Grammid/oomwoo-pcb/kicad/cliff-sensor/output/Cliff Sensor.pdf

1 | 2 | 3 | 4 | 5
1 | 2 | 3 | 4 | 5

AB

C

D

AB

C

D Date: 2026-10-28

Size: USLetter | Rev: 1
KiCad E.D.A. 10.0.4 | Id: 1/1

## Title: Cliff sensor board (fit 6x)

File: Cliff Sensor.kicad_sch

Sheet: /

OOMWOO cliff sensor

D4001
1 | IR333-A 2

3
4

5 6

J4001

ZX-SH1_0-4PLT

Q4001 PT333-3B

LED_A OUT LED_K OOMWOO cliff sensor board (rev 1, 2026-10-28). One design, fitted 6x. No lenses: narrow-beam 5 mm parts (IR333-A 20 deg, PT333-3B black lens) tilted toward each other so their beams cross at the floor. The tilt sets the reference distance:
crossing depth = (spacing / 2) / tan(tilt), e.g. 18 mm spacing: 30 deg -> 15.6 mm, 25 deg -> 19.3 mm, 20 deg -> 24.7 mm. Beyond the crossing point the beams diverge, so a far floor (a cliff) returns little light even if it is white.

The main board switches the LED cathode (CLIFF_LED_EN, modulate it to cancel ambient light) and pulls OUT up (47k).
Refs in the 4000s: each board has its own range.

Assembly (JLC): D4001 and Q4001 THT with the ASSEMBLY STANDOFF (~2 mm) so the leads can be bent; pin bending to the tilt angle, or bend by hand in the 3D-printed housing. LED: flat side = cathode. Q8501: flat side / square pad = emitter. Spacing D4001-Q4001: 18 mm centre to centre. - VLED PWM period <<15 usec - duty cycle ~10%

J4001

ZX-SH1_0-4PLT 1
2
3
4

5 6 Q4001 PT333-3B
