Grammid/oomwoo-pcb/kicad/front-sensors/output/Front Sensor-bom.csv

Comment | Designator | Footprint | LCSC Part # | Quantity
10uF/10V | C2001,C2003,C2005 | JLCImport:C0603 | C19702 | 3
100nF/50V | C2002,C2004 | JLCImport:C0603 | C1591 | 2
2005WR-2X4P | J2001 | JLCImport:HDR-TH_8P-P2.00-H-F-R2-C2-S2.00-W8.8 | C6837622 | 1
BLM18PG121SN1D | L2001 | JLCImport:BLM18PG121SN1D | C14709 | 1
47k | R2001 | JLCImport:R0603 | C2907042 | 1
100 | R2002 | JLCImport:R0603 | C2906981 | 1
IRM-H638T/TR2 | U2002 | JLCImport:IRM-H638T | C91447 | 1
