Grammid/oomwoo-pcb/kicad/main-phone/output/Main-bom.csv

Comment | Designator | Footprint | LCSC Part # | Quantity
ITR9606-F | BUMP-L1,BUMP-R1 | JLCImport:OPTO-TH_ITR9606-F | C3008416 | 2
10uF/10V | C6,C17,C19,C31,C33,C108,C113,C114,C121,C122,C146,C147,C148,C149,C152,C153,C159,C160,C161,C170,C172 | JLCImport:C0603 / Capacitor_SMD:C_0603_1608Metric | C19702 | 21
220nF/25V | C8 | Capacitor_SMD:C_0603_1608Metric | C64705 | 1
100nF/50V | C12,C13,C15,C16,C18,C21,C30,C32,C36,C37,C64,C84,C88,C92,C102,C103,C109,C111,C117,C119,C142,C143,C158,C163,C167,C169,C171,C173,C174,C175,C177 | JLCImport:C0603 / Capacitor_SMD:C_0603_1608Metric | C1591 | 31
1uF/25V | C14,C22,C176 | Capacitor_SMD:C_0603_1608Metric | C380328 | 3
18pF/50V | C39,C42 | Capacitor_SMD:C_0603_1608Metric | C107040 | 2
10uF/25V | C62,C134,C135,C136,C137,C138,C140,C141,C150,C151,C168 | JLCImport:C0603 | C96446 | 11
10uF/50V | C95,C106,C115,C116,C164,C165,C166 | JLCImport:C1206 | C13585 | 7
47nF/50V | C110,C112,C120,C178,C179 | JLCImport:C0603 / Capacitor_SMD:C_0603_1608Metric | C1622 | 5
1.2nF/50V | C162 | JLCImport:C0603 | C107073 | 1
ZX-SH1_0-4PLT | CLIFF-LF1,CLIFF-LM1,CLIFF-LR1,CLIFF-RF1,CLIFF-RM1,CLIFF-RR1,REAR-IR1 | JLCImport:ZX-SH1_0-4PLT | C7430453 | 7
S2B-ZR-SM4A-TF_LF_SN | CN1 | JLCImport:S2B-ZR-SM4A-TF_LF_SN | C265329 | 1
WAFER-PH2_0-4PWB | CONTACT_CHGR1 | JLCImport:WAFER-PH2_0-4PWB | C3029442 | 1
USBLC6-2SC6_C2687116 | D1,D40 | JLCImport:USBLC6-2SC6_C2687116 | C2687116 | 2
ZMM9V1_C2891750 | D2 | JLCImport:ZMM9V1_C2891750 | C2891750 | 1
SS34 | D4,D11,D37 | JLCImport:SS34_C8678 | C8678 | 3
SS56 | D12,D13,D14,D15,D42,D43 | JLCImport:SS56 | C65009 | 6
1N4148 | D26,D27,D28 | JLCImport:SOD-123_L2.8-W1.8-LS3.7-RD-1 | C917030 | 3
SMAJ22A | D41 | JLCImport:SMAJ18A_C148219 | C353464 | 1
YLED0603B | D44,D45,LED1,LED_CHG1,LED_DONE1,LED_HOME1,LED_PWR1 | JLCImport:YLED0603B | C19171394 | 7
DC-044A-20A | DC1 | JLCImport:DC-044A-20A | C129006 | 1
JFC1206-2200FS | F1 | JLCImport:JFC1206-2200FS | C136357 | 1
ZX-SH1_0-3PLT | HALL-BIN1,HALL-TOWER1 | JLCImport:ZX-SH1_0-3PLT | C7430452 | 2
PZ254R-12-12P | J1 | JLCImport:HDR-TH_12P-P2.54-H-M-R2-C6-S2.54 | C492434 | 1
C3030WV-4P | J2 | JLCImport:CONN-TH_4P-P3.00_CTJ_C3030WV-P3.00-4P | C239441 | 1
PZ1_27-2X7P-TP | JTAG1 | JLCImport:PZ1_27-2X7P-TP | C55099228 | 1
SMMS0630-100M | L1 | JLCImport:SMMS0630-100M | C128692 | 1
3.3uH | L2,L3 | JLCImport:CYA0630-3_3UH | C5189747 | 2
10uH | L4 | JLCImport:XRNR4030-10UH_M | C5289356 | 1
WAFER-GH1_25-4PWB | LIDAR1 | JLCImport:WAFER-GH1_25-4PWB | C3029379 | 1
ZX-ZH1_5-2PWT | MAIN_BRUSH1,SIDE_BRUSH1 | JLCImport:ZX-ZH1_5-2PWT | C19272405 | 2
XDWF-C3030WR-1*4P | MAIN_FAN1 | JLCImport:CONN-TH_4P-P3.00_L8.9-W15.7-EH4.7 | C50399536 | 1
ZX-ZH1_5-7PWT | MOT_WHEEL_L1,MOT_WHEEL_R1 | JLCImport:ZX-ZH1_5-7PWT | C19272410 | 2
AO4407C | Q1,Q13,Q14,Q37,Q38 | Package_SO:SOIC-8_3.9x4.9mm_P1.27mm | C469397 | 5
AOD407_C6396162 | Q12 | JLCImport:AOD407_C6396162 | C6396162 | 1
AO3401 | Q16,Q24,Q25,Q27 | JLCImport:AO3401 | C20628875 | 4
AO3400 | Q18,Q19,Q20,Q23,Q26,Q28,Q29,Q30,Q31,Q32,Q33,Q34,Q35,Q36 | JLCImport:AO3400 | C20628874 | 14
10k | R1,R21,R22,R49,R50,R51,R52,R67,R92,R103,R104,R105,R107,R159,R165,R172,R173,R179,R181,R184,R195,R201,R217 | JLCImport:R0603 / Resistor_SMD:R_0603_1608Metric | C98220 | 23
47k | R2,R39,R53,R64,R73,R189,R192,R194,R196,R212,R213 | JLCImport:R0603 | C2907042 | 11
2.2k | R5,R6,R149 | JLCImport:R0603 / Resistor_SMD:R_0603_1608Metric | C2907005 | 3
1k | R14,R44,R48,R77,R78,R89,R98,R176,R178,R190 | Resistor_SMD:R_0603_1608Metric / JLCImport:R0603 | C2907113 | 10
RLH12FTCR250 | R15,R65 | Resistor_SMD:R_1206_3216Metric | C22464902 | 2
100k | R16,R38,R40,R41,R56,R63,R74,R90,R116,R168,R171,R175,R177,R180,R186,R187,R188,R191,R200,R202,R203,R207,R211,R219,R221 | JLCImport:R0603 / Resistor_SMD:R_0603_1608Metric | C2907088 | 25
10 | R36,R60,R141,R146,R222 | JLCImport:R0603 | C2907091 | 5
120 Ohm | R37 | Resistor_SMD:R_0603_1608Metric | C22787 | 1
1Ω | R59 | JLCImport:FRC0805J1R0TS | C2930253 | 1
100 | R66,R113,R183 | Resistor_SMD:R_0603_1608Metric | C2906981 | 3
GL5537-1 | R75 | JLCImport:GL5537-1 | C125628 | 1
RLH12FTCR300 | R83 | Resistor_SMD:R_1206_3216Metric | C22464904 | 1
LRBK25EFER110 | R84 | Resistor_SMD:R_2512_6332Metric | C5121166 | 1
100mΩ/1W | R106 | JLCImport:R1206 | C46961734 | 1
4.7k | R143,R147 | Resistor_SMD:R_0603_1608Metric | C2907034 | 2
69.8k | R144 | Resistor_SMD:R_0603_1608Metric | C2930012 | 1
22.1k | R145,R208 | Resistor_SMD:R_0603_1608Metric | C2960862 | 2
12k | R148 | Resistor_SMD:R_0603_1608Metric | C2930069 | 1
232k | R160,R205,R206 | Resistor_SMD:R_0603_1608Metric | C22913 | 3
330 | R185 | JLCImport:R1206 | C17930 | 1
1M | R193,R199,R218 | JLCImport:R0603 | C22935 | 3
180 | R197,R220 | JLCImport:R0603 | C22828 | 2
150 | R224,R225,R226,R227,R228,R229 | JLCImport:R0603 | C22808 | 6
ZX-SH1_0-7PWT | SIDE-R1 | JLCImport:ZX-SH1_0-7PWT | C7430449 | 1
PZ254V-11-06P | STM32_DEBUG1 | Connector_PinHeader_2.54mm:PinHeader_1x06_P2.54mm_Vertical | C492405 | 1
TS-1187A-B-A-B | SW_CLEAN1,SW_HOME1,SW_PWR1 | JLCImport:TS-1187A-B-A-B | C318884 | 3
NTCG164KF104FT1 | T1 | JLCImport:NTCG164KF104FT1 | C92042 | 1
SLM6900 | U1 | JLCImport:SLM6900 | C388595 | 1
TMI6240 | U2 | JLCImport:TMI6240 | C2979914 | 1
MT3608 | U5 | JLCImport:MT3608 | C84817 | 1
STM32G473VCT6 | U13 | JLCImport:LQFP-100_L14.0-W14.0-P0.50-LS16.0-BL | C730121 | 1
DRV8870DDAR | U14,U15,U18,U20 | JLCImport:DRV8870DDAR | C86590 | 4
HT7533-1_C14289 | U16 | JLCImport:HT7533-1_C14289 | C14289 | 1
ICM-42607-P | U19 | JLCImport:ICM-42607-P | C5129967 | 1
TPS54560BDDAR | U21,U22 | Package_SO:Texas_R-PDSO-G8_EP2.95x4.9mm_Mask2.4x3.1mm_ThermalVias | C1850354 | 2
74LVC1G17 | U23 | Package_TO_SOT_SMD:SOT-23-5 | C19829593 | 1
TYPE-C-31-M-12 | USBC2 | JLCImport:USB-C_SMD-TYPE-C-31-M-12_1 | C165948 | 1
2005FV-2X4P | VL-L1,VL-R1 | JLCImport:HDR-TH_8P-P2.00-V-F-R2-C4-S2.00-1 | C18723066 | 2
XKXEL89CII-SUAYLC-32_768K | X3 | JLCImport:XKXEL89CII-SUAYLC-32_768K | C18214309 | 1
