Grammid/oomwoo-pcb/kicad/rear-ir/output/Rear IR-bom.csv

Comment | Designator | Footprint | LCSC Part # | Quantity
10uF/10V | C5001,C5002 | JLCImport:C0603 | C19702 | 2
ZX-SH1_0-4PLT | J5001 | JLCImport:ZX-SH1_0-4PLT | C7430453 | 1
100 | R5001,R5002 | JLCImport:R0603 | C2906981 | 2
IRM-H638T/TR2 | U5001,U5002 | JLCImport:IRM-H638T | C91447 | 2
