Grammid/oomwoo-pcb/kicad/charging-dock/output/Charging Dock.pdf

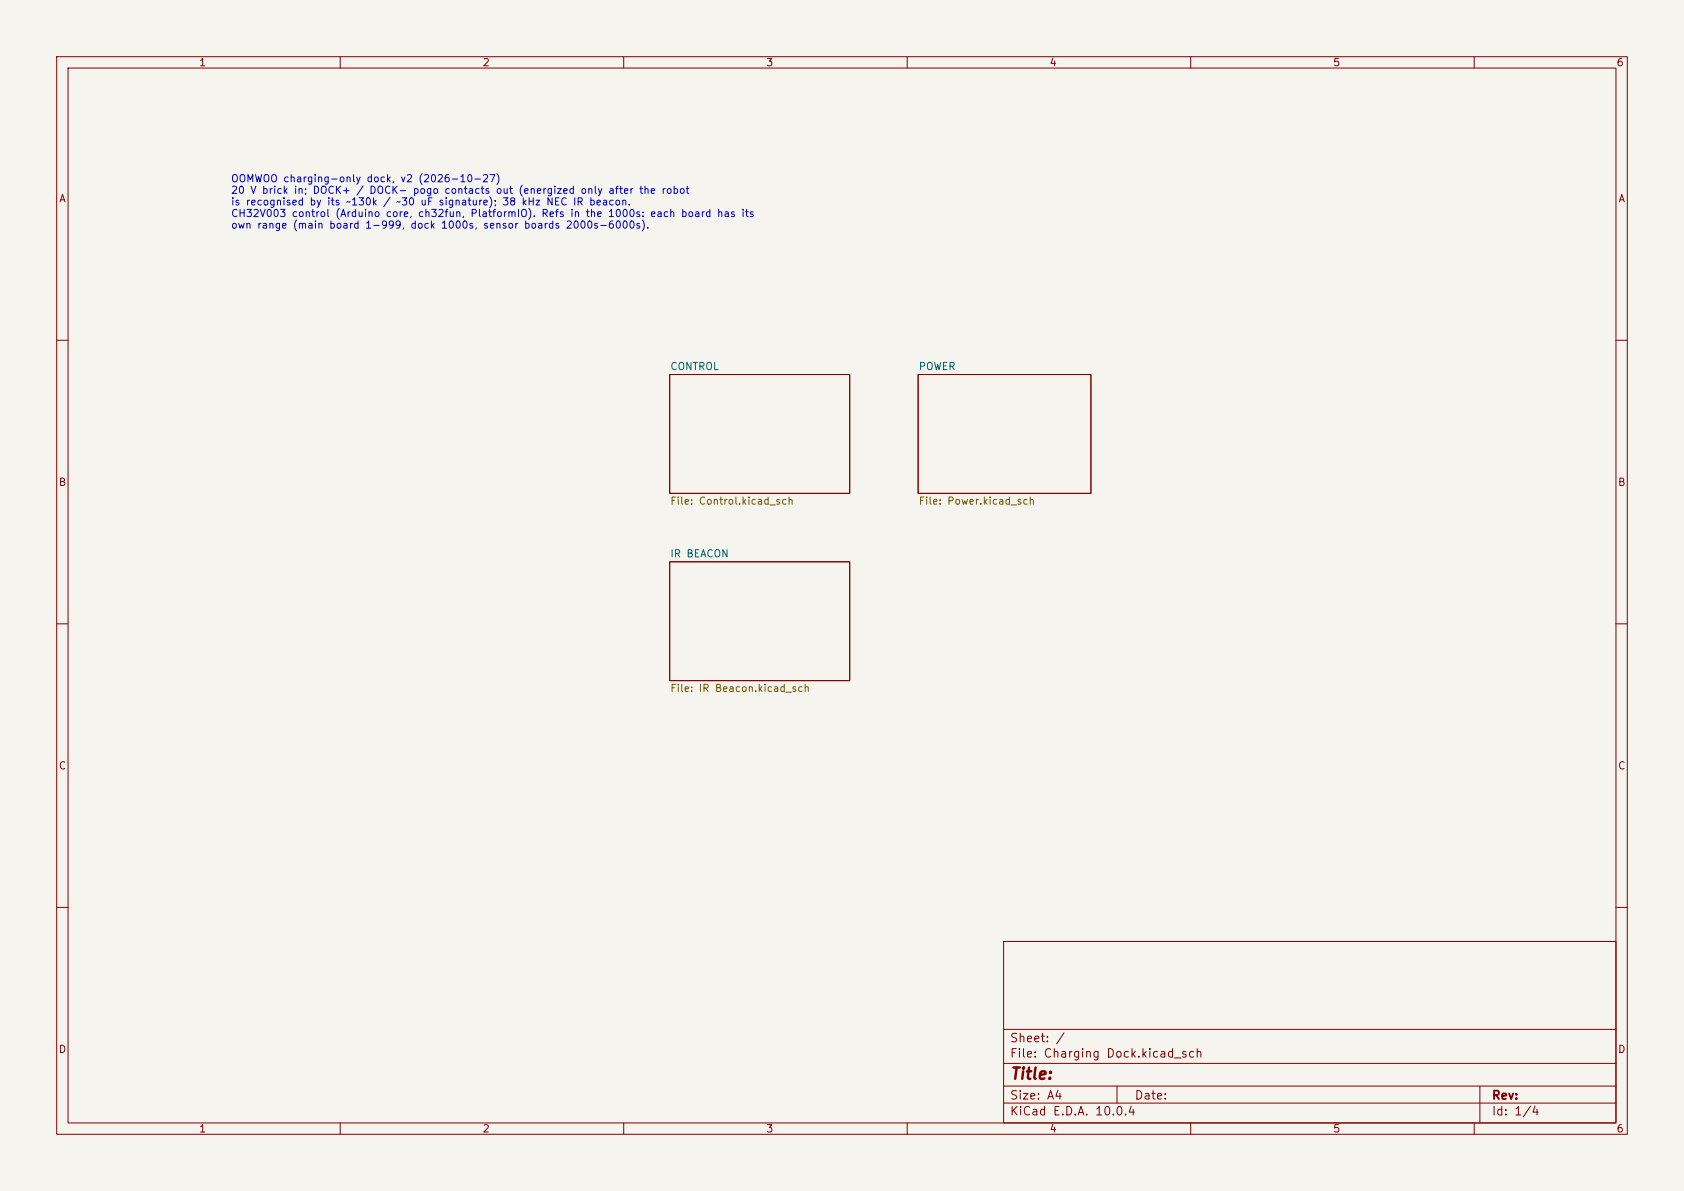
[picture p1: page 1]

File: Power.kicad_sch CONTROL File: Control.kicad_sch OOMWOO charging-only dock, v2 (2026-10-27) 20 V brick in; DOCK+ / DOCK- pogo contacts out (energized only after the robot

is recognised by its ~130k / ~30 uF signature); 38 kHz NEC IR beacon. CH32V003 control (Arduino core, ch32fun, PlatformIO). Refs in the 1000s: each board has its own range (main board 1-999, dock 1000s, sensor boards 2000s-6000s).

Size: A4 | Rev:
KiCad E.D.A. 10.0.4 | Id: 1/4

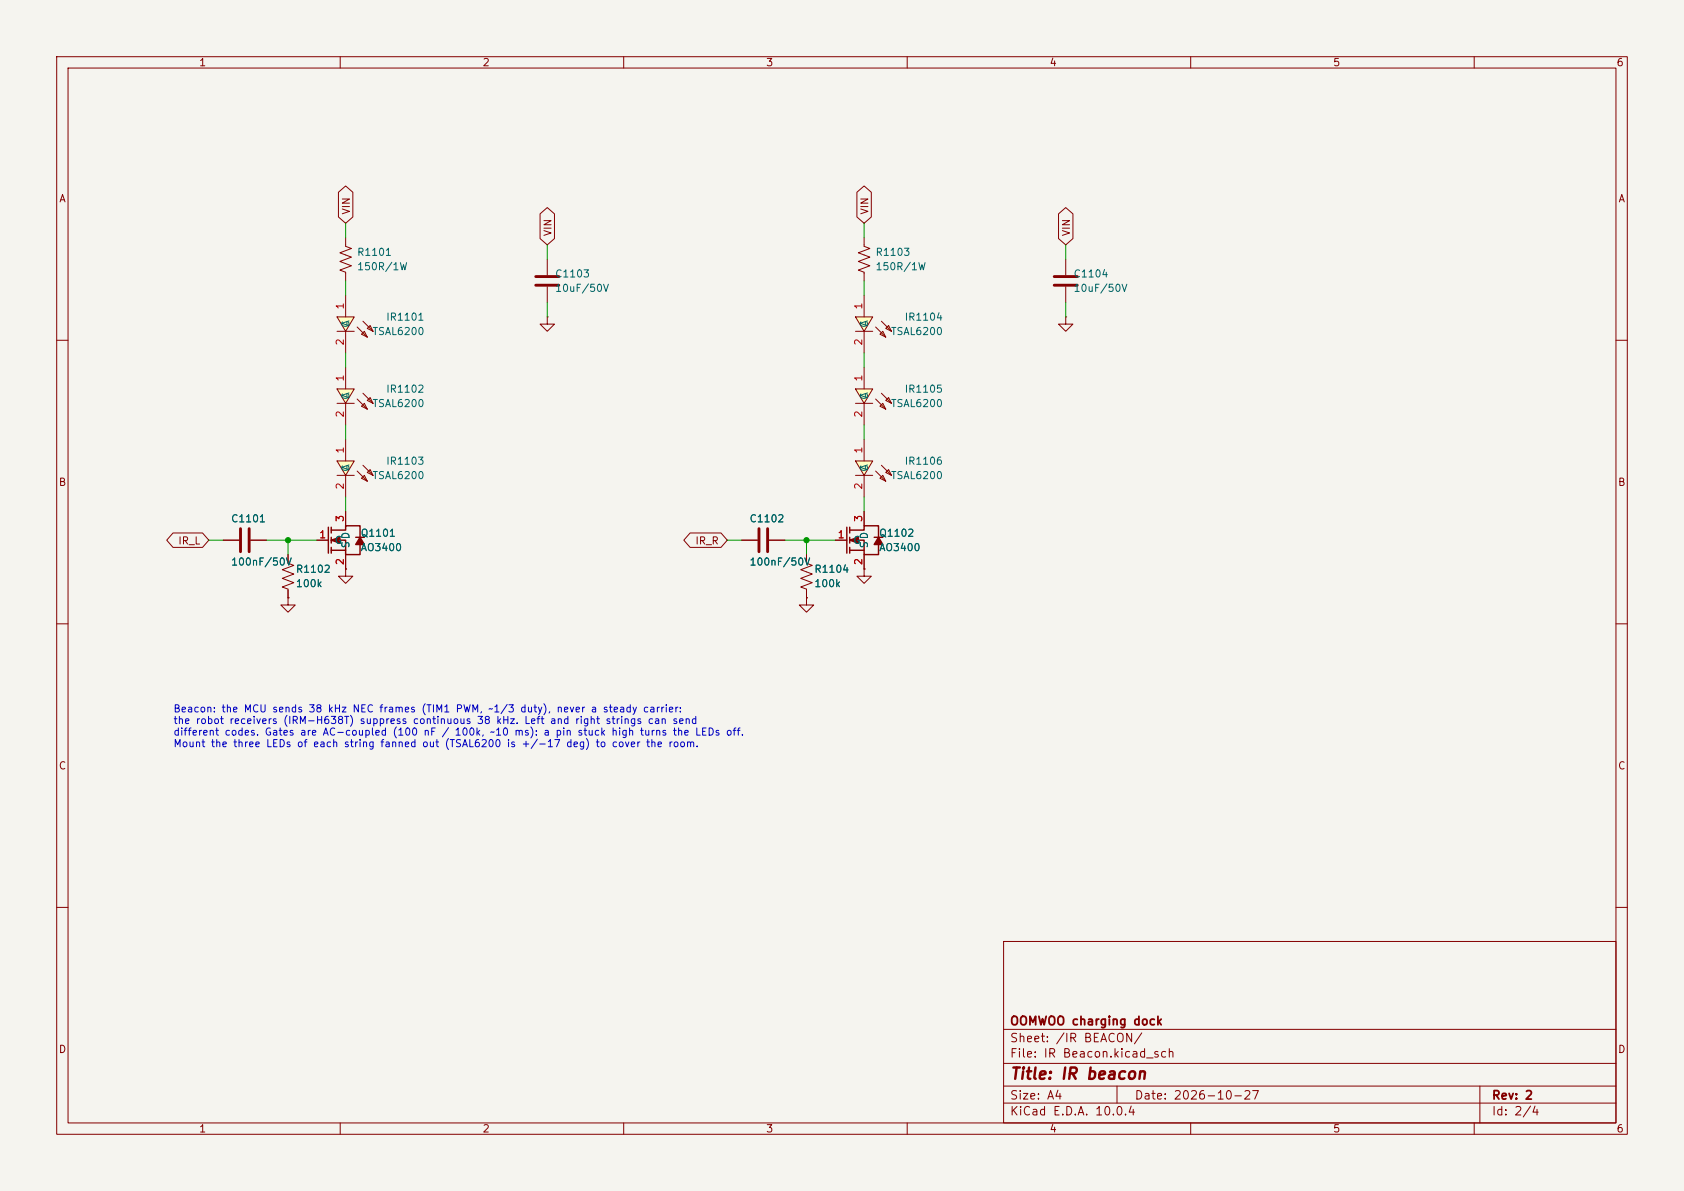
[picture p2: page 2]

Beacon: the MCU sends 38 kHz NEC frames (TIM1 PWM, ~1/3 duty), never a steady carrier: the robot receivers (IRM-H638T) suppress continuous 38 kHz. Left and right strings can send

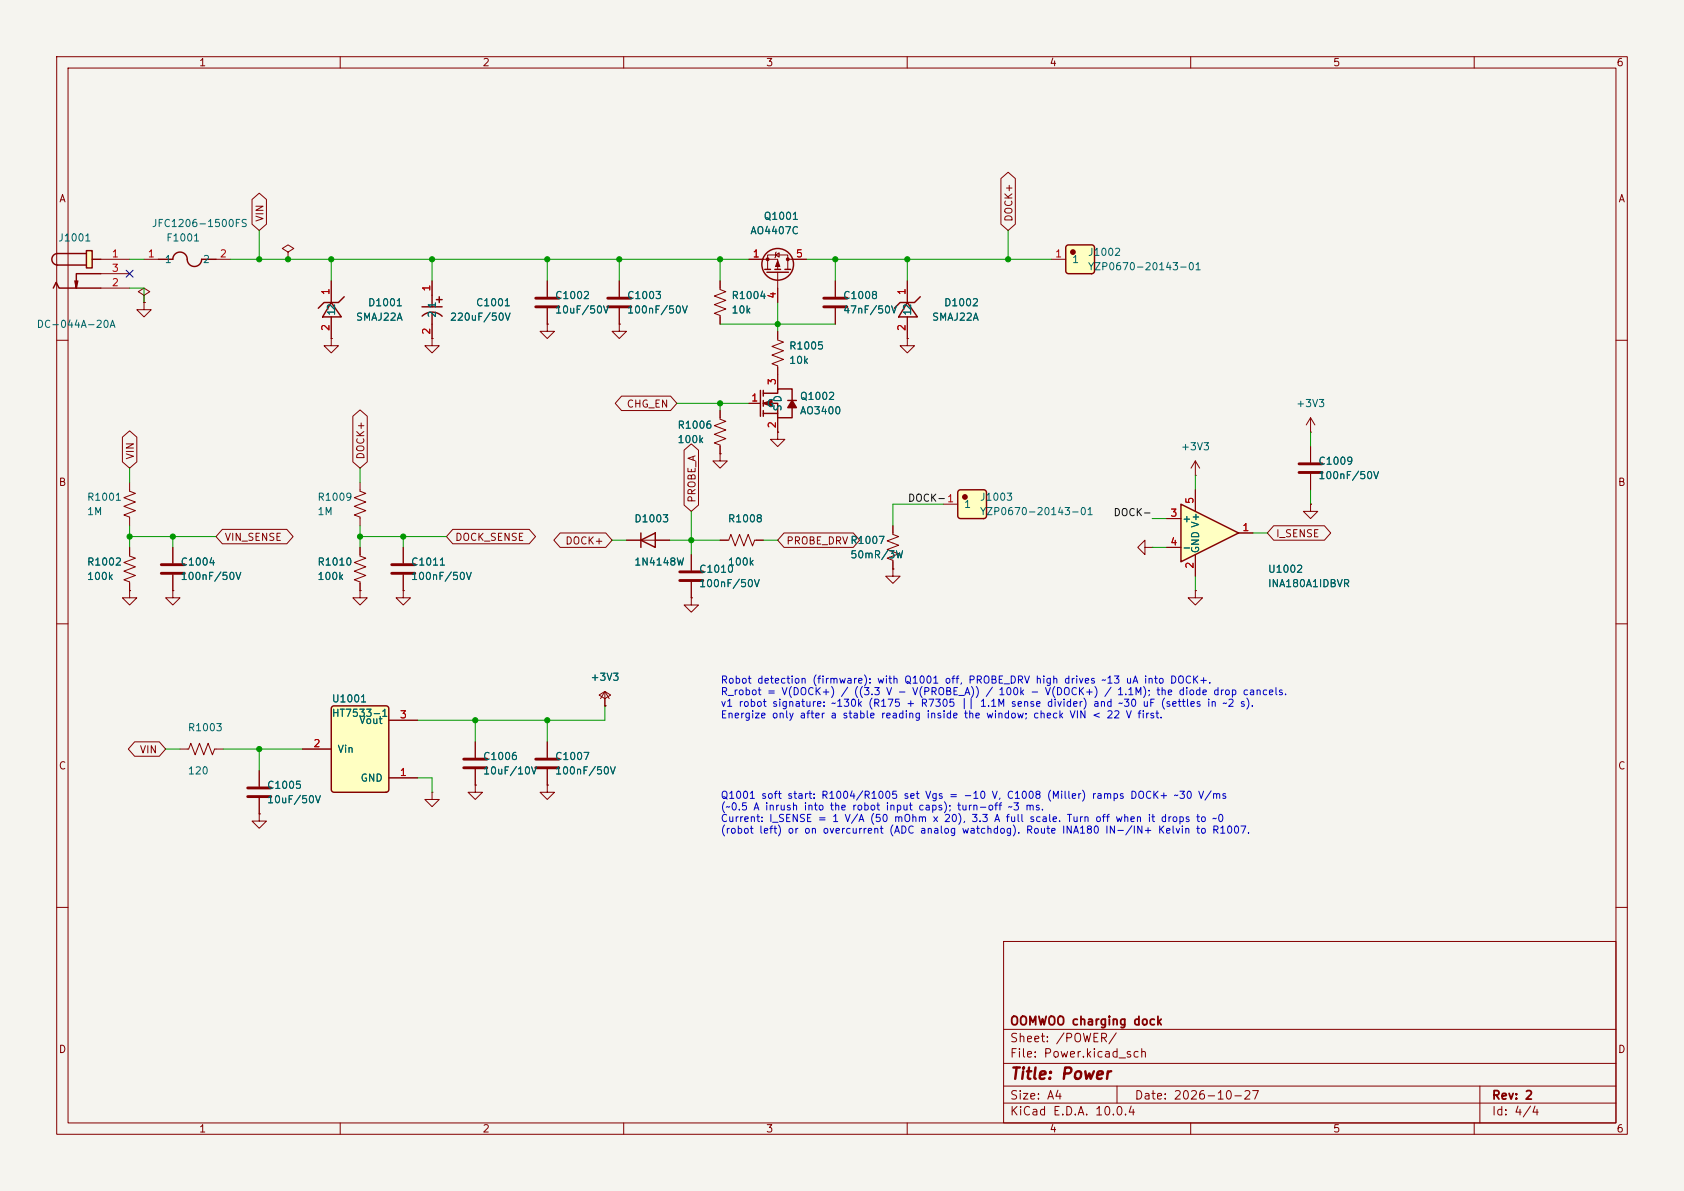
[picture p3: page 3]

Energize only after a stable reading inside the window; check VIN < 22 V first. D1003

(robot left) or on overcurrent (ADC analog watchdog). Route INA180 IN-/IN+ Kelvin to R1007. Robot detection (firmware): with Q1001 off, PROBE_DRV high drives ~13 uA into DOCK+. R_robot = V(DOCK+) / ((3.3 V - V(PROBE_A)) / 100k - V(DOCK+) / 1.1M); the diode drop cancels. v1 robot signature: ~130k (R175 + R7305 || 1.1M sense divider) and ~30 uF (settles in ~2 s).

Q1001 soft start: R1004/R1005 set Vgs = -10 V, C1008 (Miller) ramps DOCK+ ~30 V/ms
(~0.5 A inrush into the robot input caps); turn-off ~3 ms. Current: I_SENSE = 1 V/A (50 mOhm x 20), 3.3 A full scale. Turn off when it drops to ~0

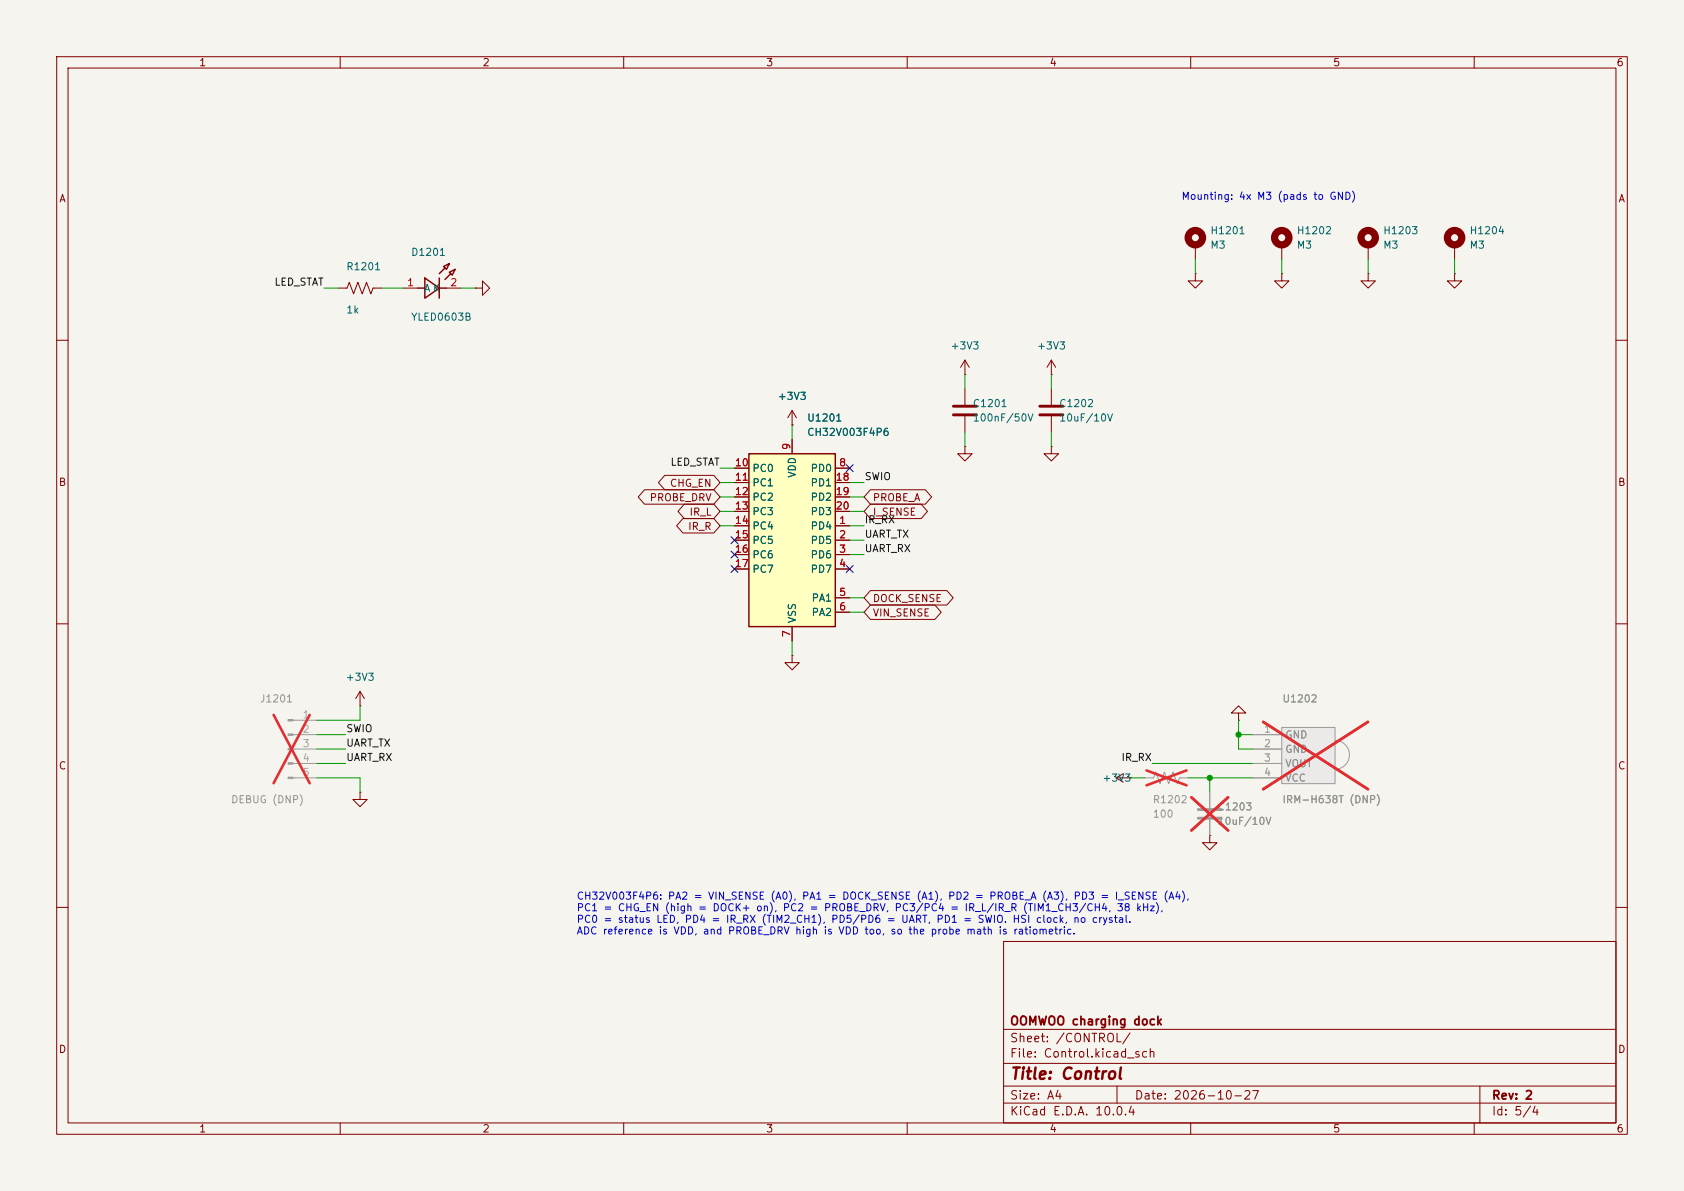
[picture p4: page 4]
