Grammid/oomwoo-pcb/kicad/hall-sensor/output/Hall Sensor.pdf

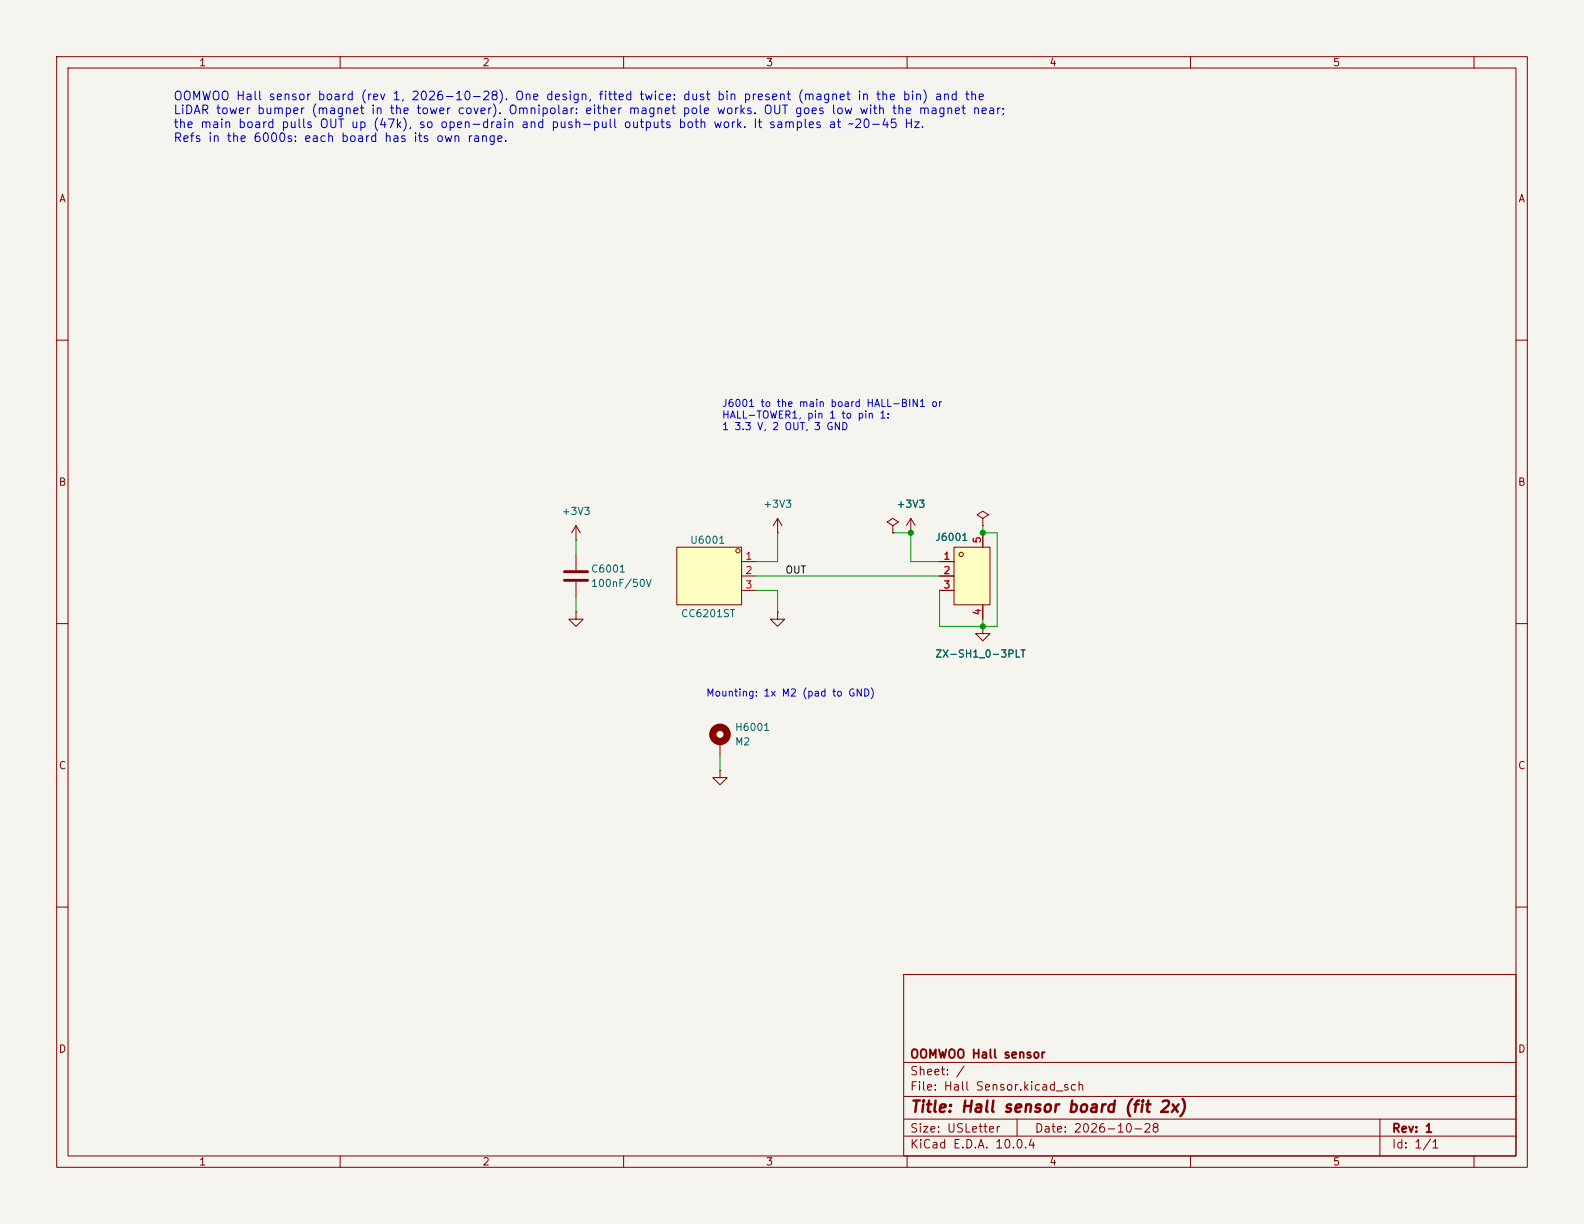
[picture p5: page 1]

OOMWOO Hall sensor board (rev 1, 2026-10-28). One design, fitted twice: dust bin present (magnet in the bin) and the
LiDAR tower bumper (magnet in the tower cover). Omnipolar: either magnet pole works. OUT goes low with the magnet near; the main board pulls OUT up (47k), so open-drain and push-pull outputs both work. It samples at ~20-45 Hz.

J6001 to the main board HALL-BIN1 or HALL-TOWER1, pin 1 to pin 1: 1 3.3 V, 2 OUT, 3 GND Mounting: 1x M2 (pad to GND)

OOMWOO Hall sensor
Sheet: /
File: Hall Sensor.kicad_sch
Title: Hall sensor board (fit 2x)

Size: USLetter | Rev: 1
KiCad E.D.A. 10.0.4 | Id: 1/1
