Grammid/oomwoo-pcb/kicad/main-phone/output/Main.pdf

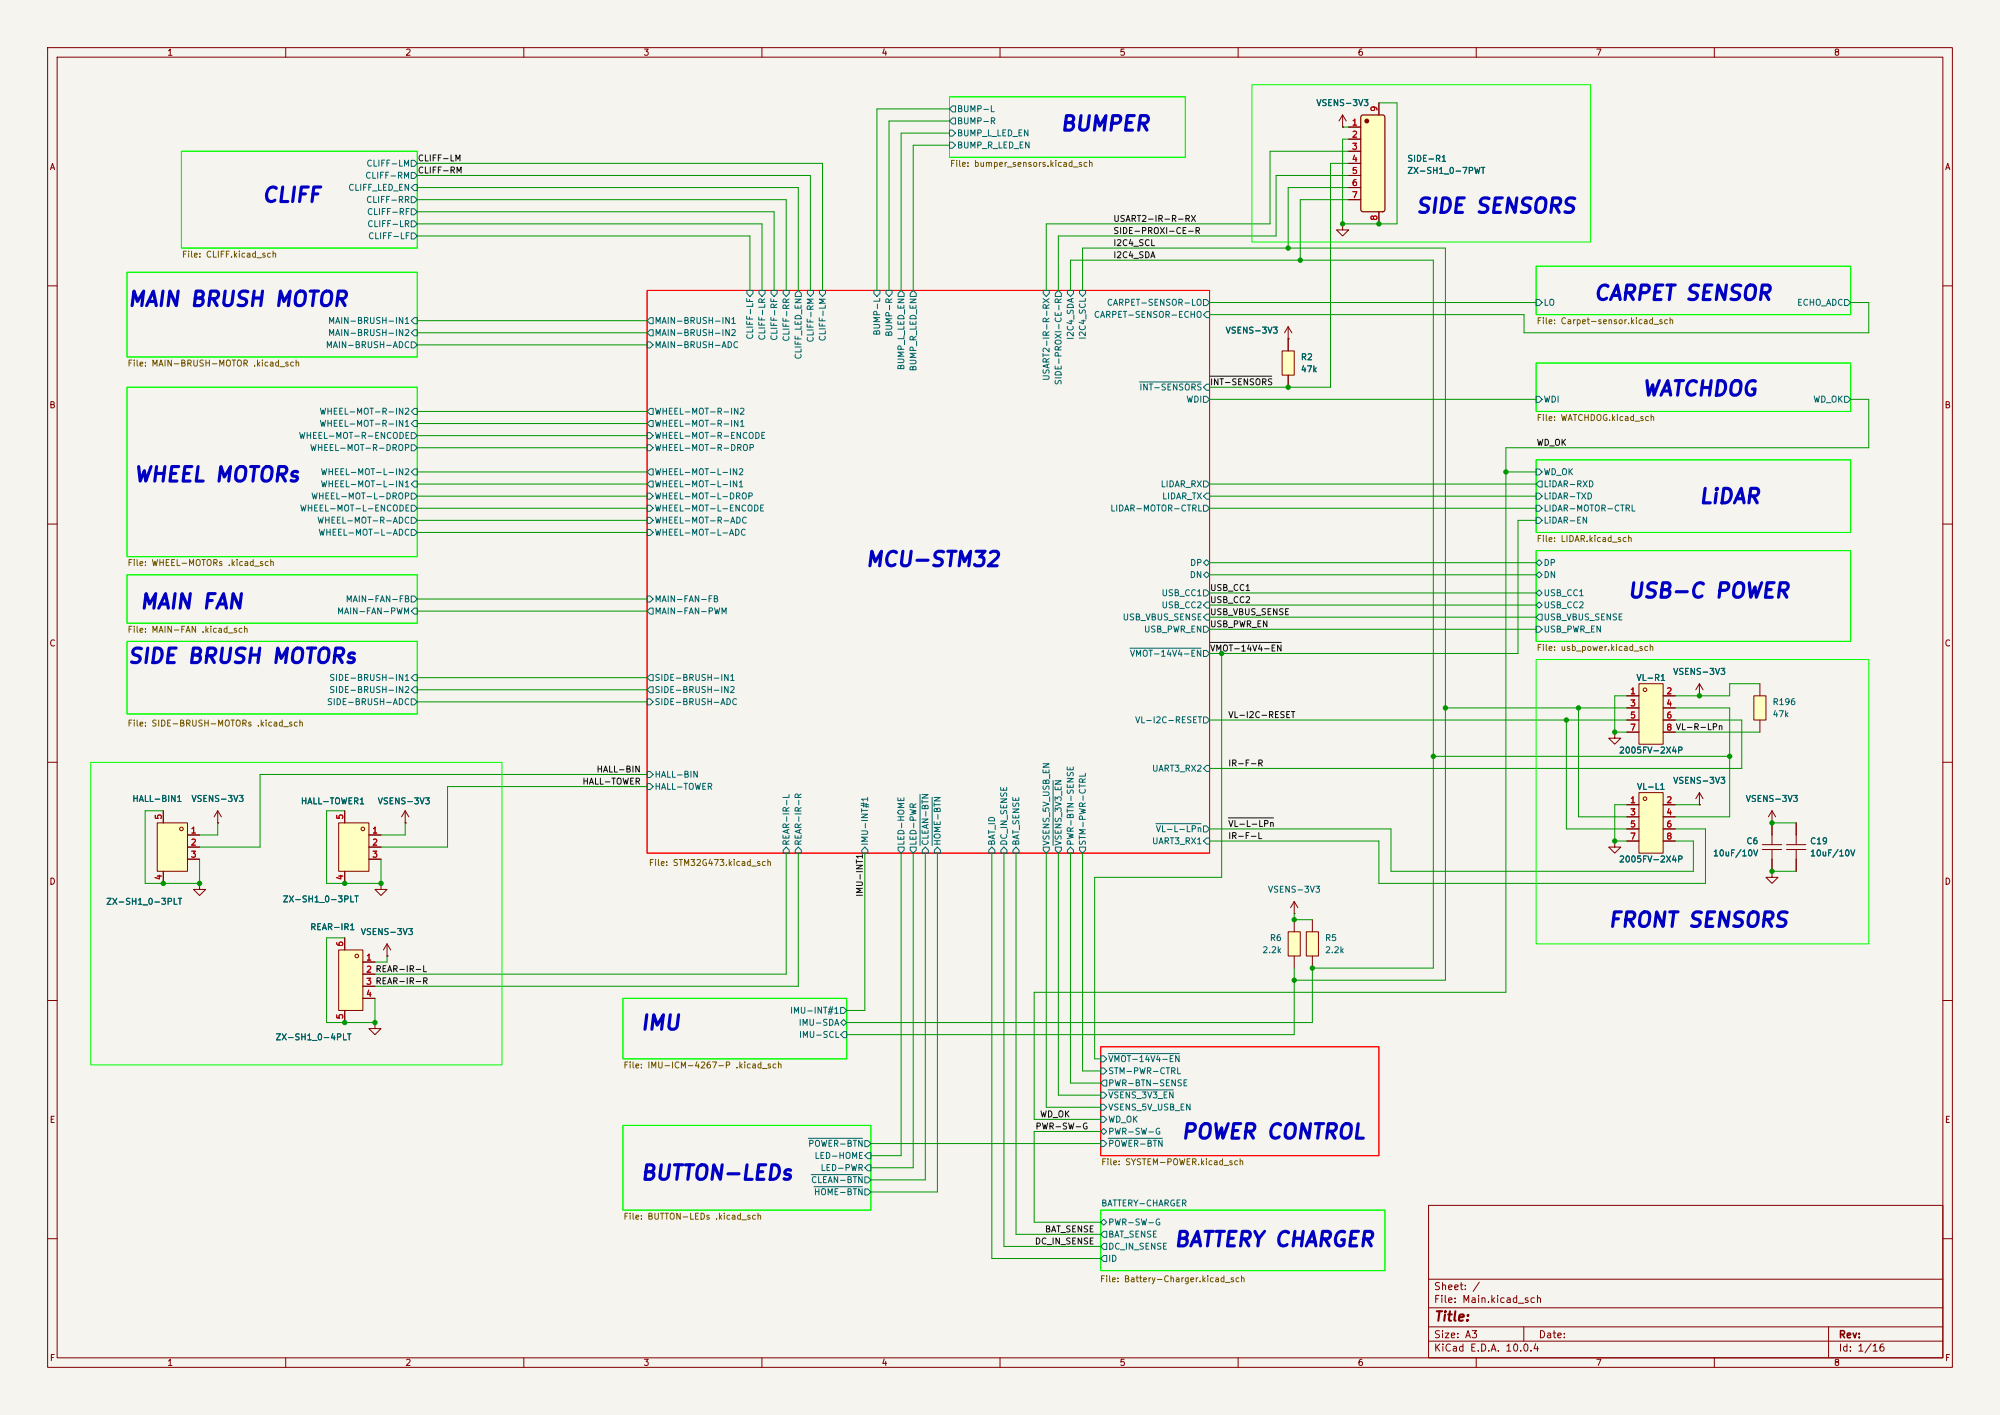
[picture p6: page 1]

BUMP-L File: bumper_sensors.kicad_sch SIDE-BRUSH-ADC

CLIFF-LM
CLIFF-RM
CLIFF_LED_EN
CLIFF-RF CLIFF-RR

CLIFF-LF CLIFF-LR

MAIN-BRUSH-ADC MAIN-BRUSH-IN1 MAIN-BRUSH-IN2
VSENS-3V3 REAR-IR1

File: MAIN-BRUSH-MOTOR .kicad_sch

SIDE-BRUSH-IN2 MAIN-FAN-PWM

IR-F-L USB_PWR_EN

3 3 | 4 4
5 5 | 6 6
7 7 | 8 8

File: SIDE-BRUSH-MOTORs .kicad_sch

VL-L-LPn | VL-L1

PWR-BTN-SENSE STM-PWR-CTRL VMOT-14V4-EN

POWER-BTN
LED-HOME
LED-PWR HOME-BTN
CLEAN-BTN

Size: A3 | Rev:
KiCad E.D.A. 10.0.4 | Id: 1/16 | F Date:

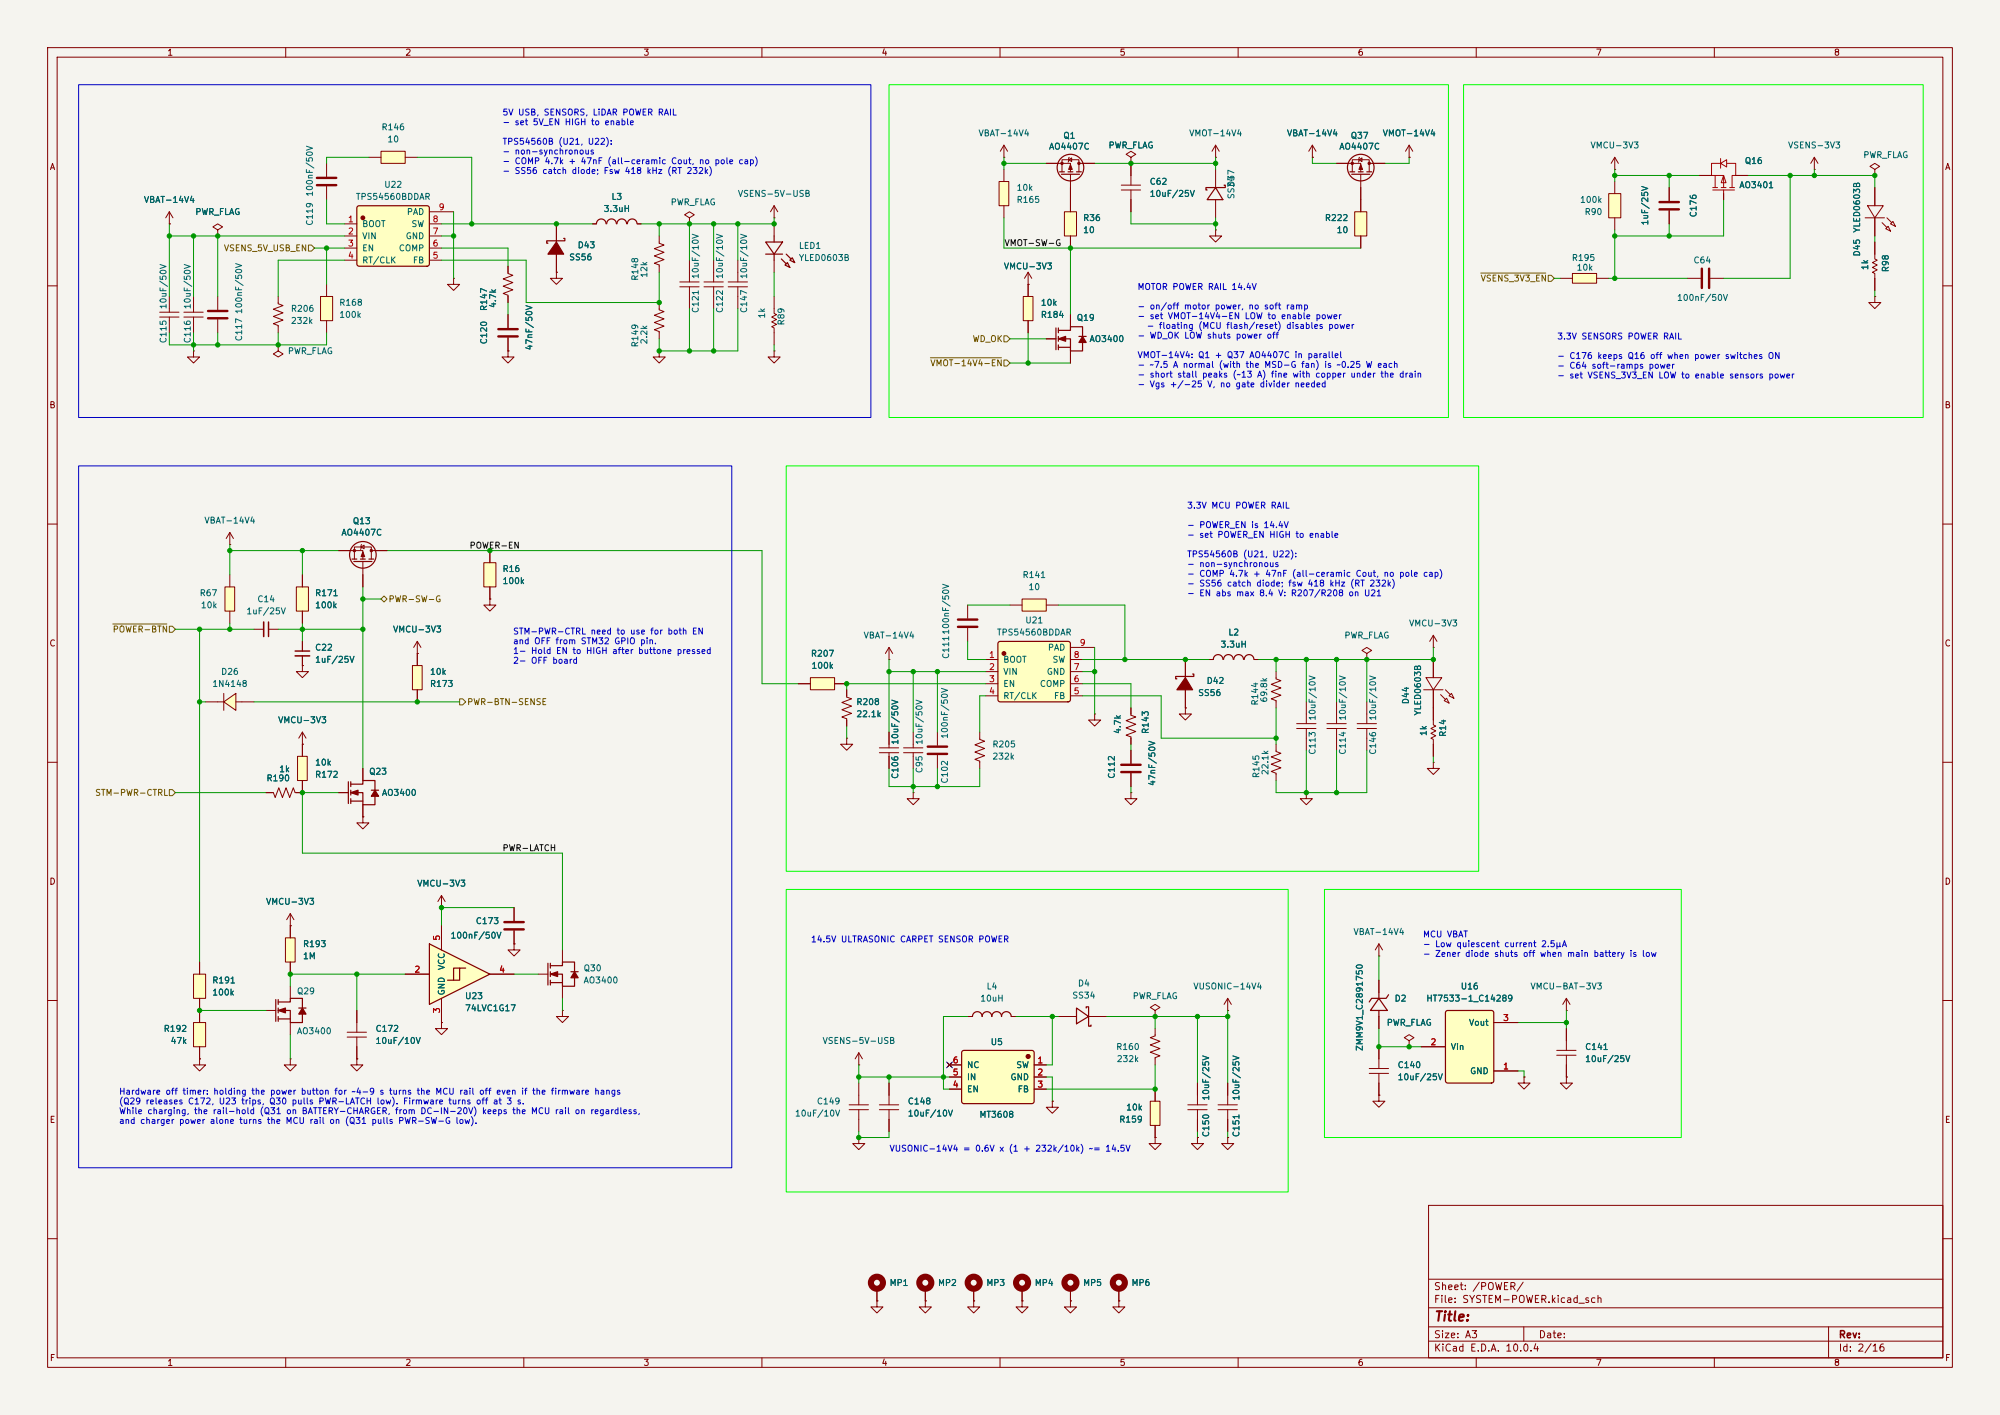
[picture p7: page 2]

3.3V SENSORS POWER RAIL - C176 keeps Q16 off when power switches ON - C64 soft-ramps power - set VSENS_3V3_EN LOW to enable sensors power 5V USB, SENSORS, LiDAR POWER RAIL - set 5V_EN HIGH to enable

TPS54560B (U21, U22): - non-synchronous - COMP 4.7k + 47nF (all-ceramic Cout, no pole cap) - SS56 catch diode; Fsw 418 kHz (RT 232k)

TPS54560B (U21, U22): - non-synchronous - COMP 4.7k + 47nF (all-ceramic Cout, no pole cap) - SS56 catch diode; fsw 418 kHz (RT 232k) - EN abs max 8.4 V: R207/R208 on U21 MOTOR POWER RAIL 14.4V - on/off motor power, no soft ramp - set VMOT-14V4-EN LOW to enable power - floating (MCU flash/reset) disables power - WD_OK LOW shuts power off VMOT-14V4: Q1 + Q37 AO4407C in parallel - ~7.5 A normal (with the MSD-G fan) is ~0.25 W each - short stall peaks (~13 A) fine with copper under the drain - Vgs +/-25 V, no gate divider needed 14.5V ULTRASONIC CARPET SENSOR POWER

3.3V MCU POWER RAIL - POWER_EN is 14.4V - set POWER_EN HIGH to enable

STM-PWR-CTRL need to use for both EN

Hardware off timer: holding the power button for ~4-9 s turns the MCU rail off even if the firmware hangs
(Q29 releases C172, U23 trips, Q30 pulls PWR-LATCH low). Firmware turns off at 3 s. While charging, the rail-hold (Q31 on BATTERY-CHARGER, from DC-IN-20V) keeps the MCU rail on regardless, and charger power alone turns the MCU rail on (Q31 pulls PWR-SW-G low).

Size: A3 | Rev:

F Date:

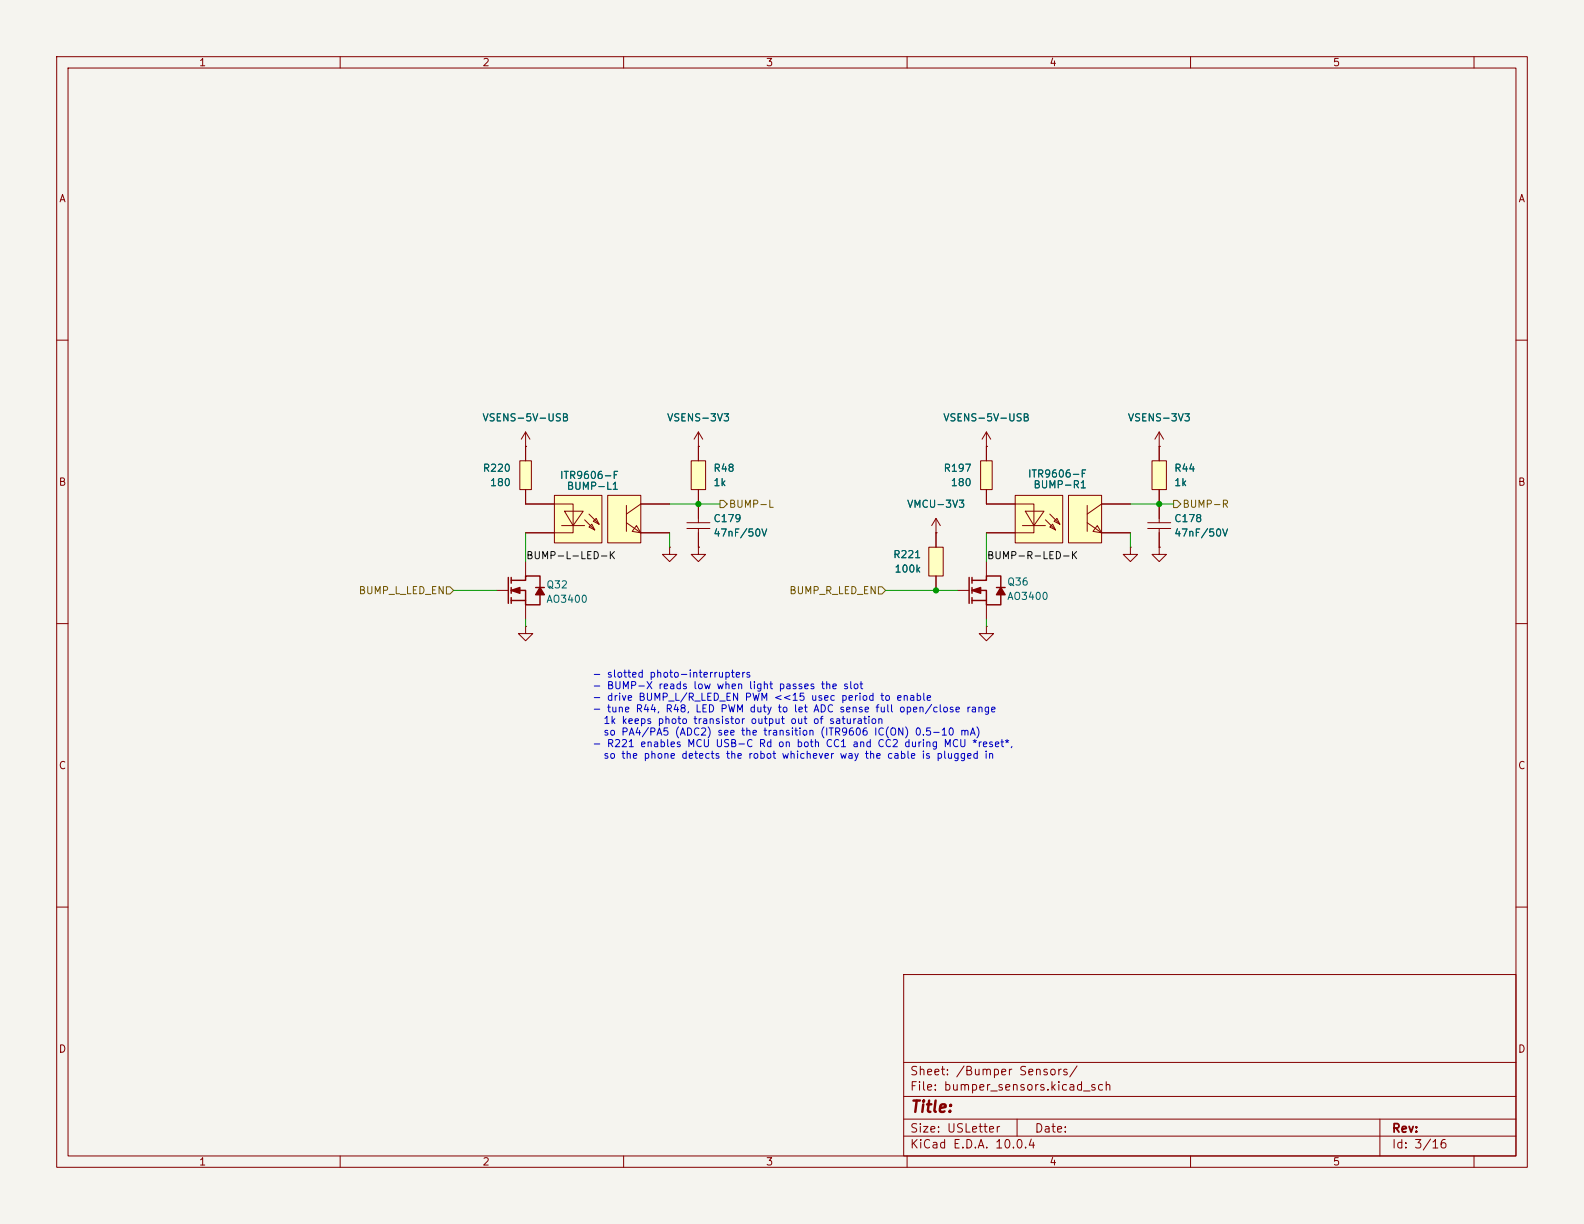
[picture p8: page 3]

so PA4/PA5 (ADC2) see the transition (ITR9606 IC(ON) 0.5-10 mA) - R221 enables MCU USB-C Rd on both CC1 and CC2 during MCU *reset*, so the phone detects the robot whichever way the cable is plugged in R197
BUMP-L1

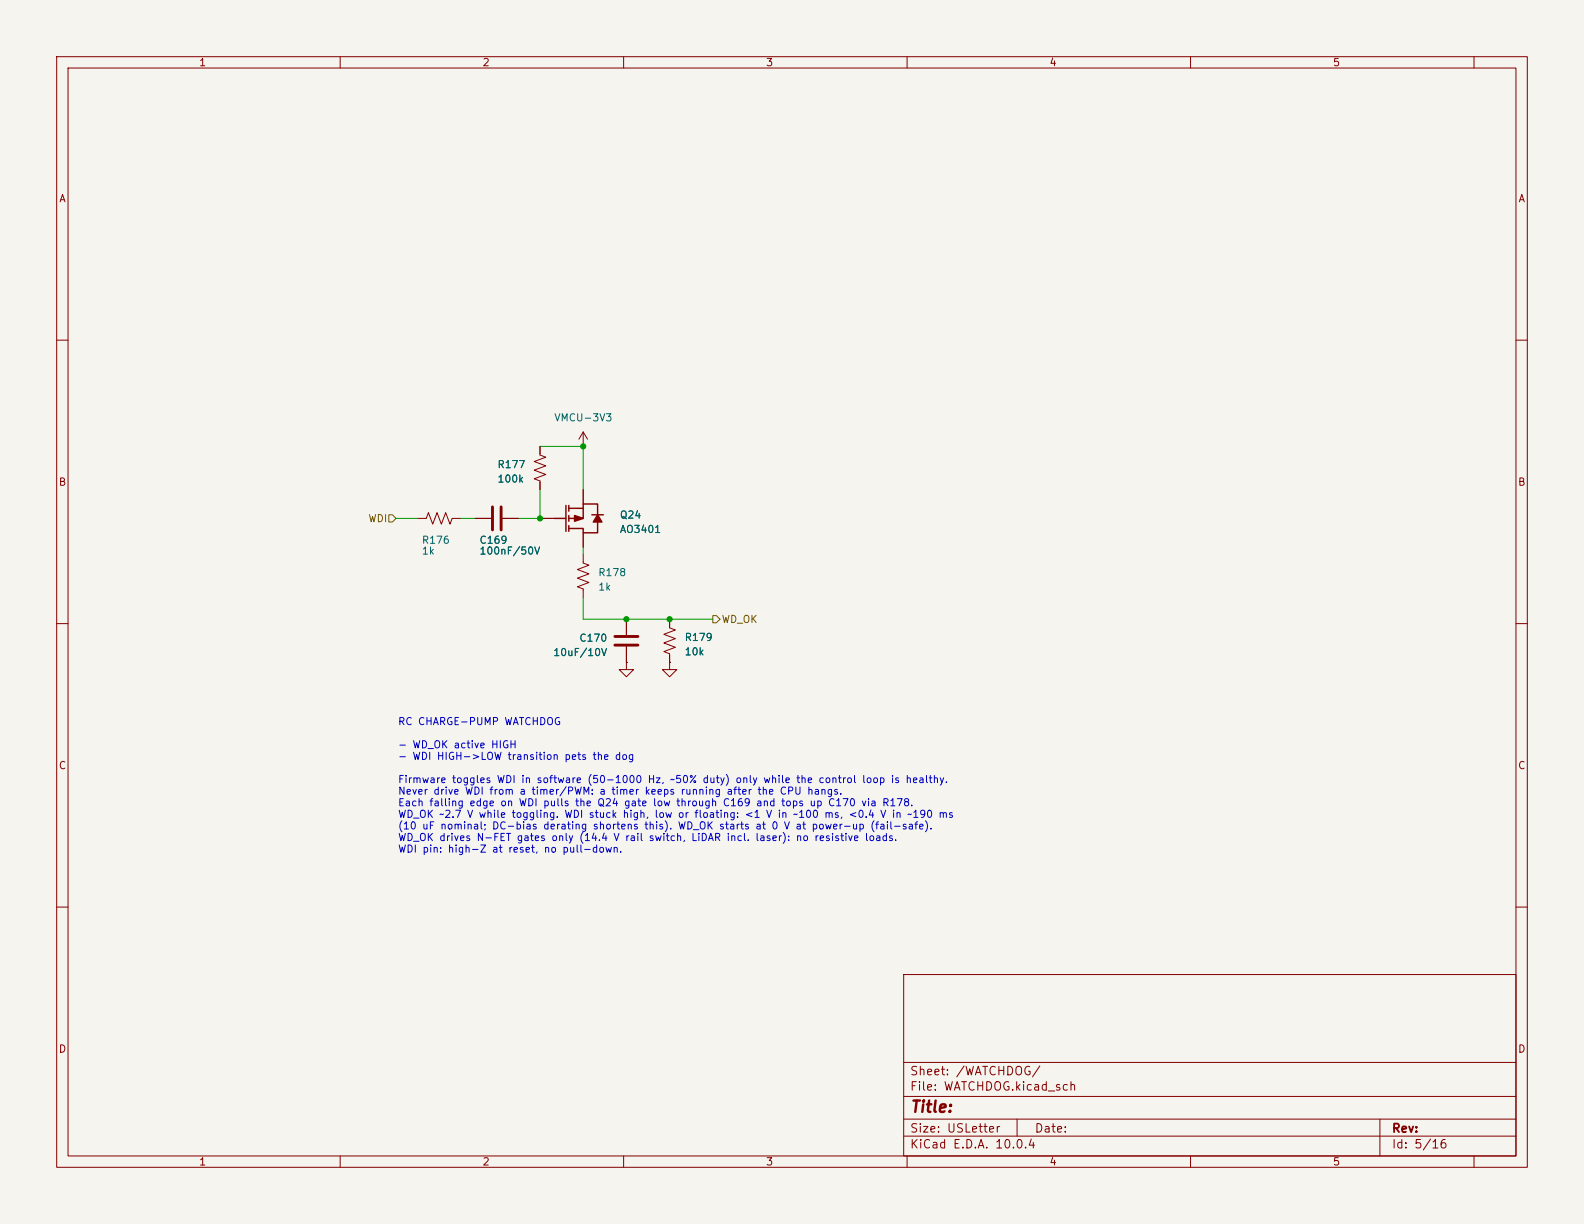
[picture p9: page 4]

RC CHARGE-PUMP WATCHDOG - WD_OK active HIGH - WDI HIGH->LOW transition pets the dog

Firmware toggles WDI in software (50-1000 Hz, ~50% duty) only while the control loop is healthy. Never drive WDI from a timer/PWM: a timer keeps running after the CPU hangs. Each falling edge on WDI pulls the Q24 gate low through C169 and tops up C170 via R178. WD_OK ~2.7 V while toggling. WDI stuck high, low or floating: <1 V in ~100 ms, <0.4 V in ~190 ms

(10 uF nominal; DC-bias derating shortens this). WD_OK starts at 0 V at power-up (fail-safe). WD_OK drives N-FET gates only (14.4 V rail switch, LiDAR incl. laser): no resistive loads. WDI pin: high-Z at reset, no pull-down.

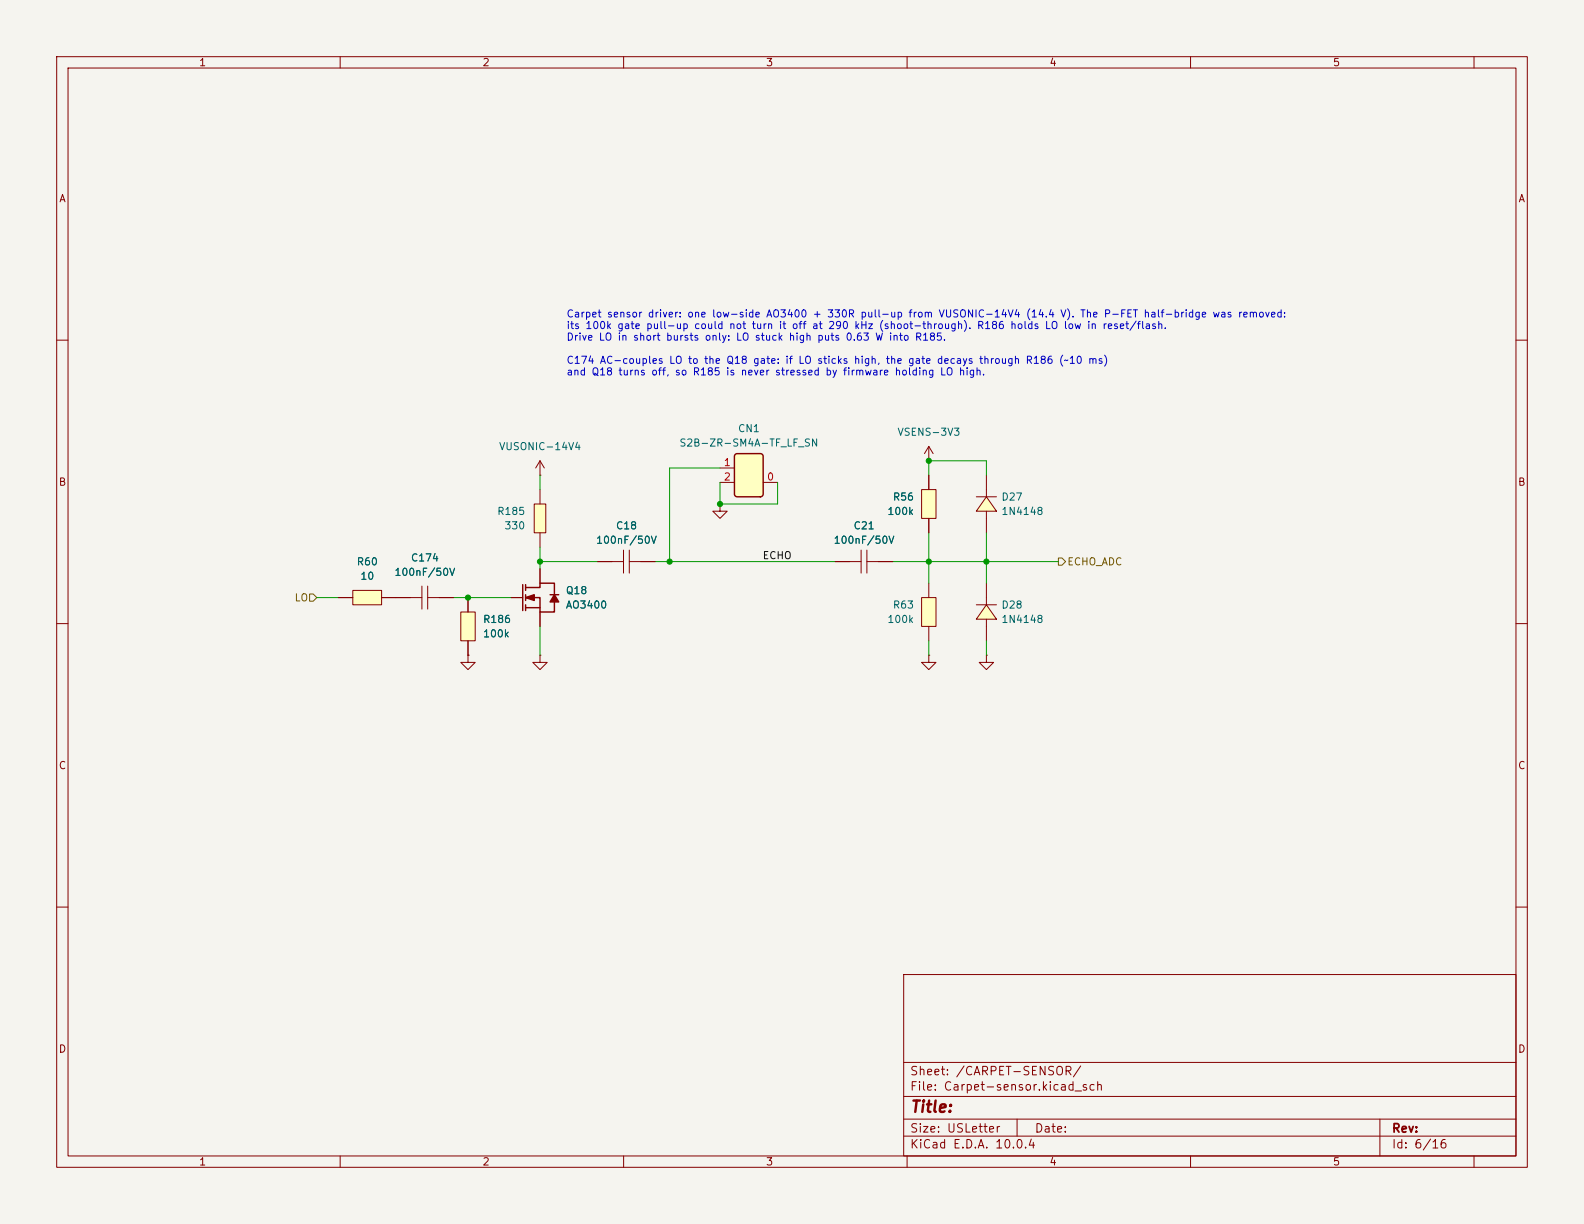
[picture p10: page 5]

Carpet sensor driver: one low-side AO3400 + 330R pull-up from VUSONIC-14V4 (14.4 V). The P-FET half-bridge was removed:
its 100k gate pull-up could not turn it off at 290 kHz (shoot-through). R186 holds LO low in reset/flash. Drive LO in short bursts only: LO stuck high puts 0.63 W into R185. C174 AC-couples LO to the Q18 gate: if LO sticks high, the gate decays through R186 (~10 ms) and Q18 turns off, so R185 is never stressed by firmware holding LO high. R56

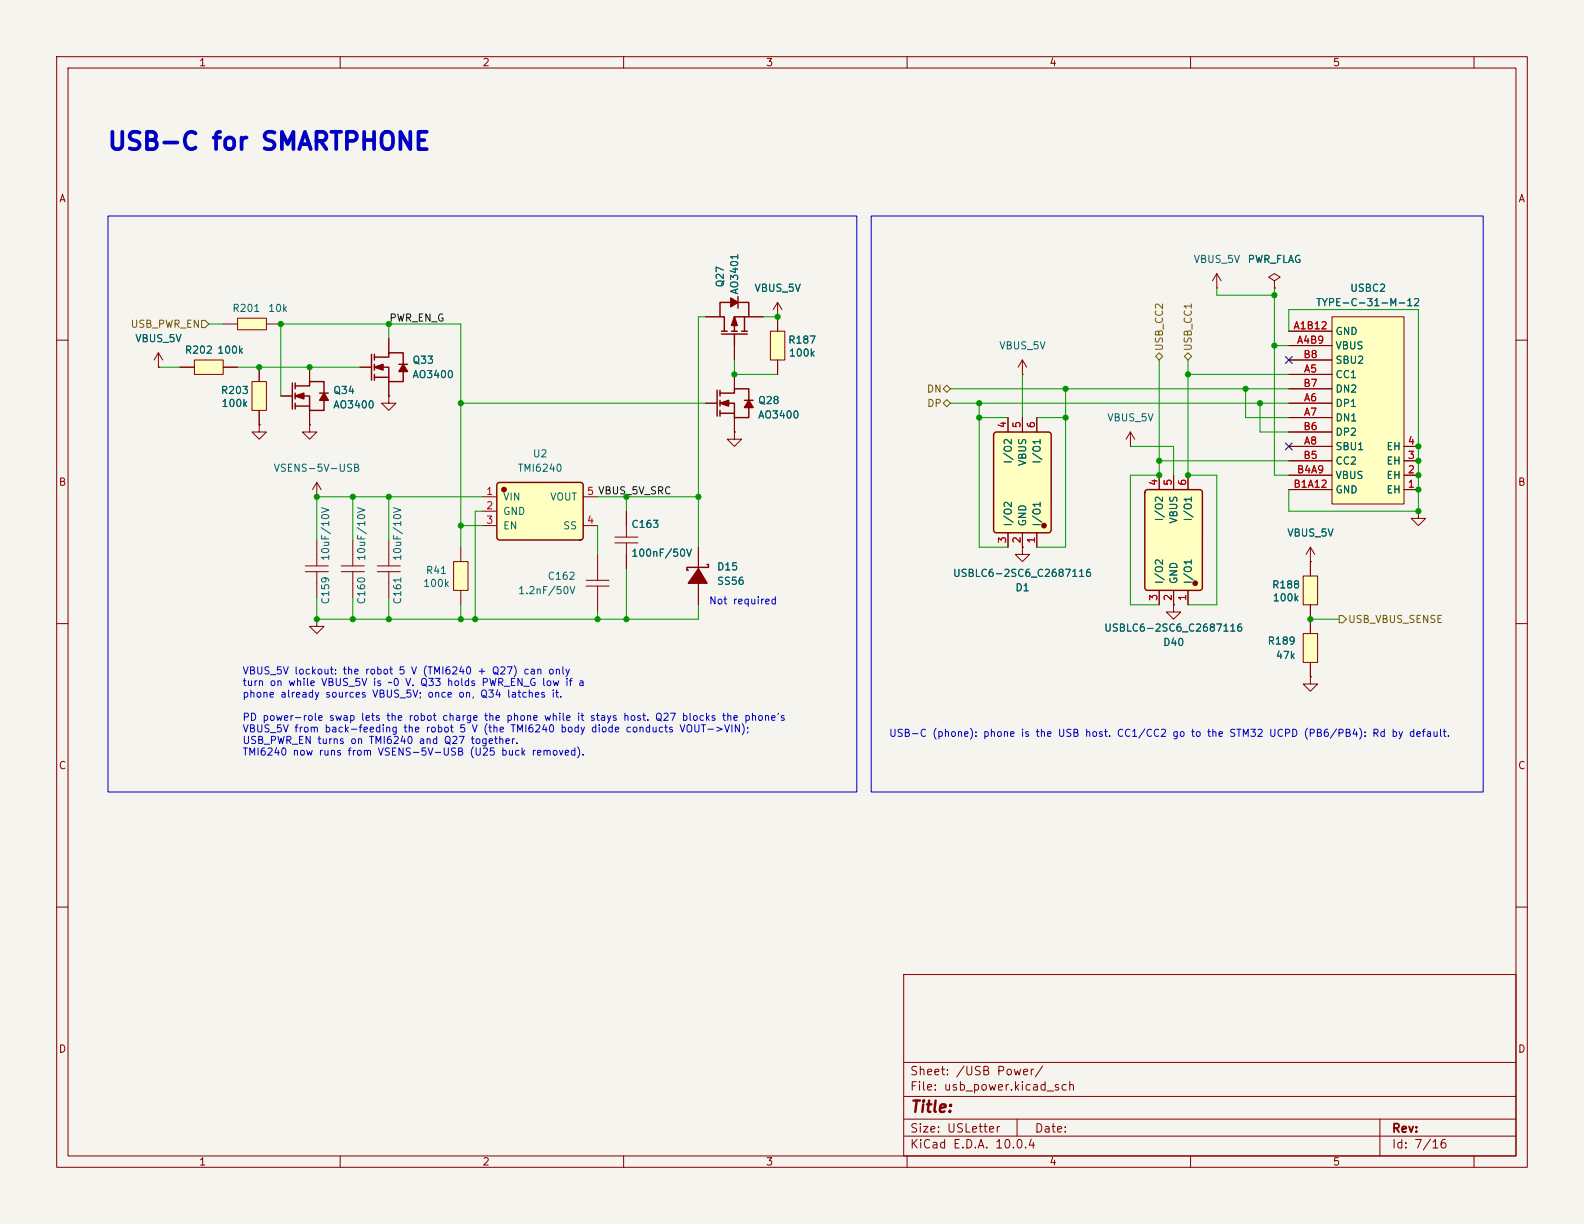
[picture p11: page 6]

VBUS_5V lockout: the robot 5 V (TMI6240 + Q27) can only
turn on while VBUS_5V is ~0 V. Q33 holds PWR_EN_G low if a

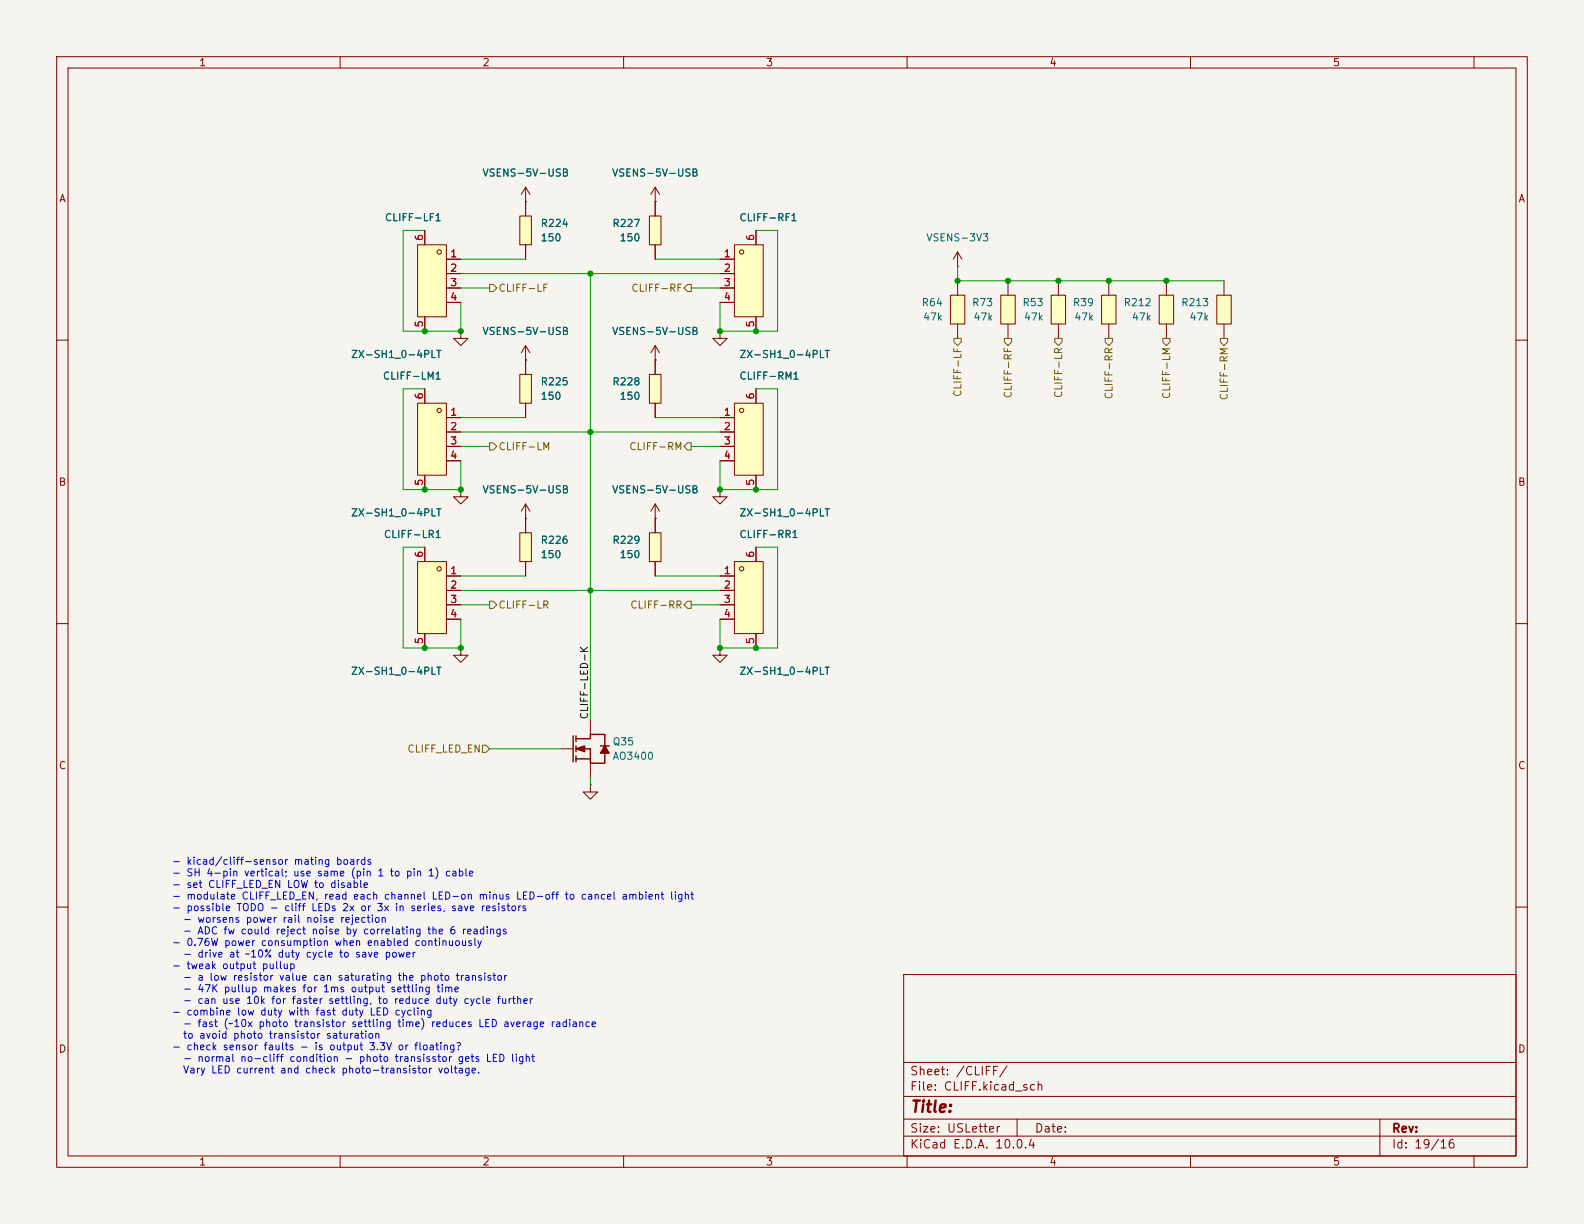
[picture p12: page 7]

2 2 | 2 2
3 3 4 4 | 3 3 4 4

to avoid photo transistor saturation - check sensor faults - is output 3.3V or floating? - normal no-cliff condition - photo transisstor gets LED light

Vary LED current and check photo-transistor voltage.

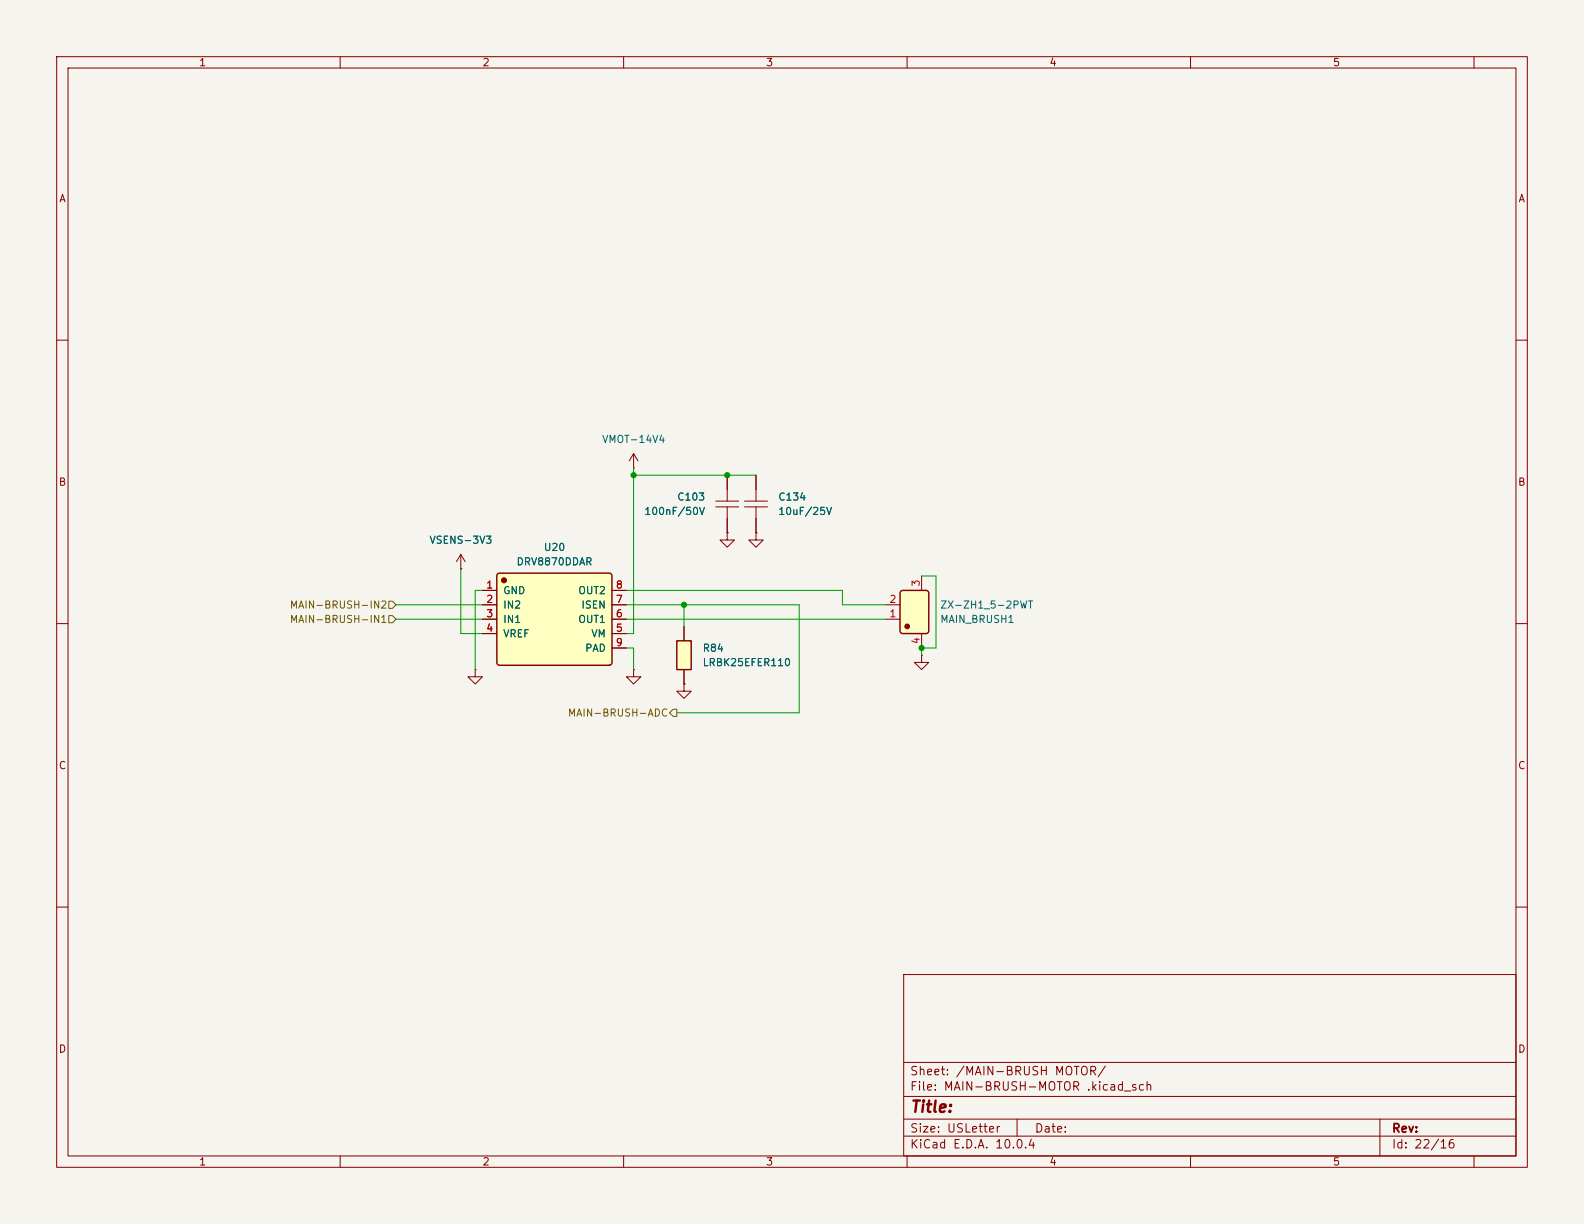
[picture p13: page 8]

3 4 MAIN_BRUSH1 MAIN-BRUSH-IN2 ZX-ZH1_5-2PWT MAIN-BRUSH-IN1 MAIN-BRUSH-ADC

Sheet: /MAIN-BRUSH MOTOR/
File: MAIN-BRUSH-MOTOR .kicad_sch
Title:

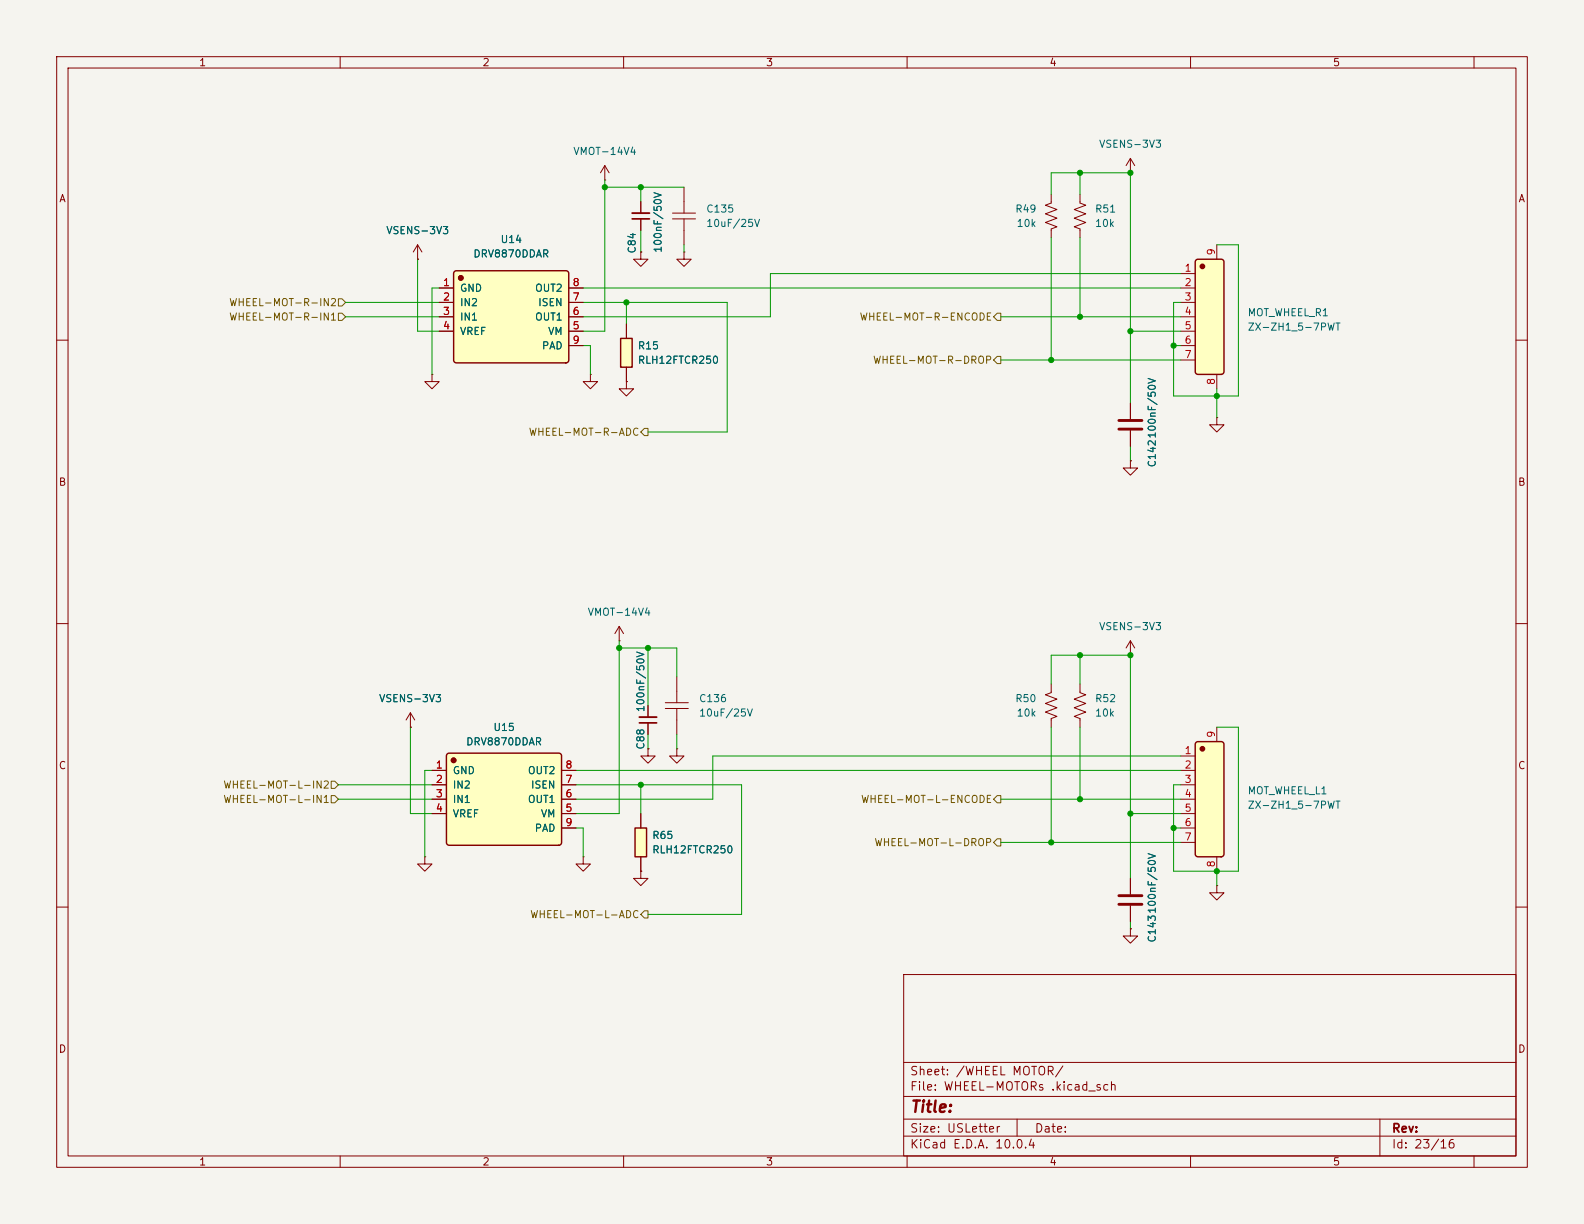
[picture p14: page 9]

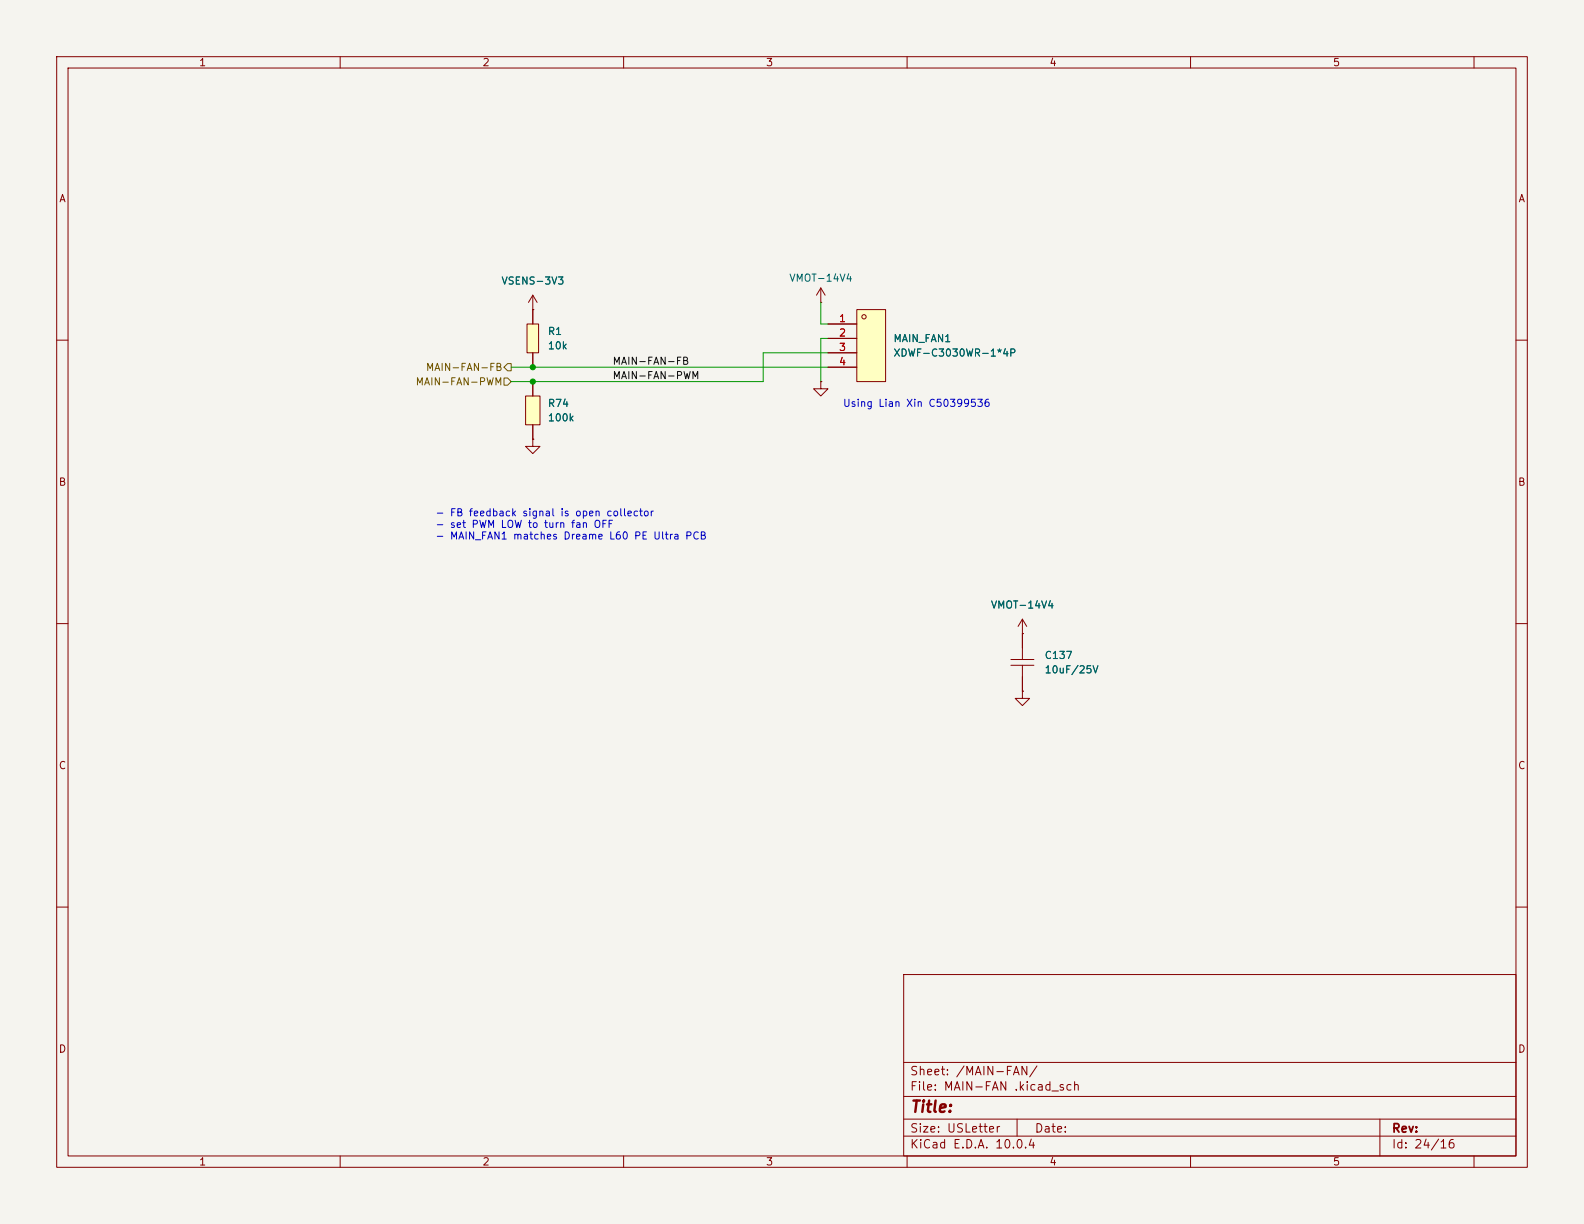
[picture p15: page 10]

XDWF-C3030WR-1*4P MAIN-FAN-PWM

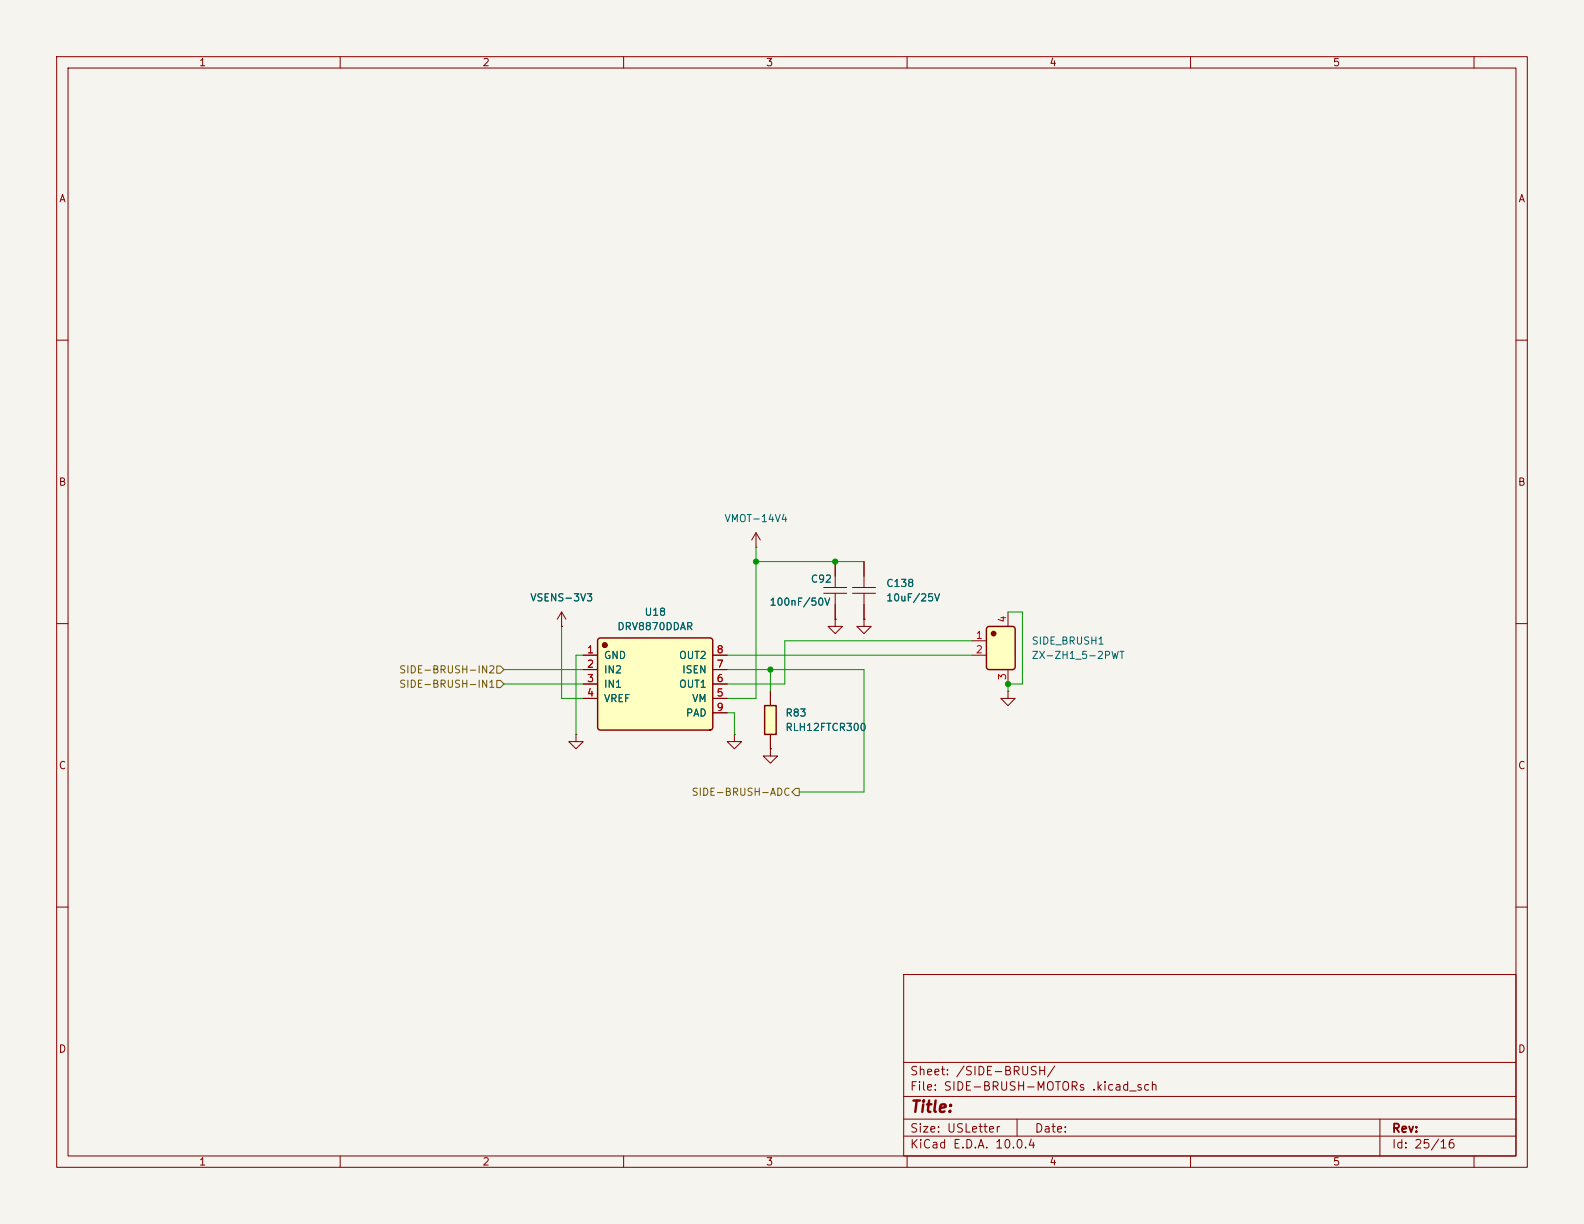
[picture p16: page 11]

Sheet: /SIDE-BRUSH/
File: SIDE-BRUSH-MOTORs .kicad_sch
Title:

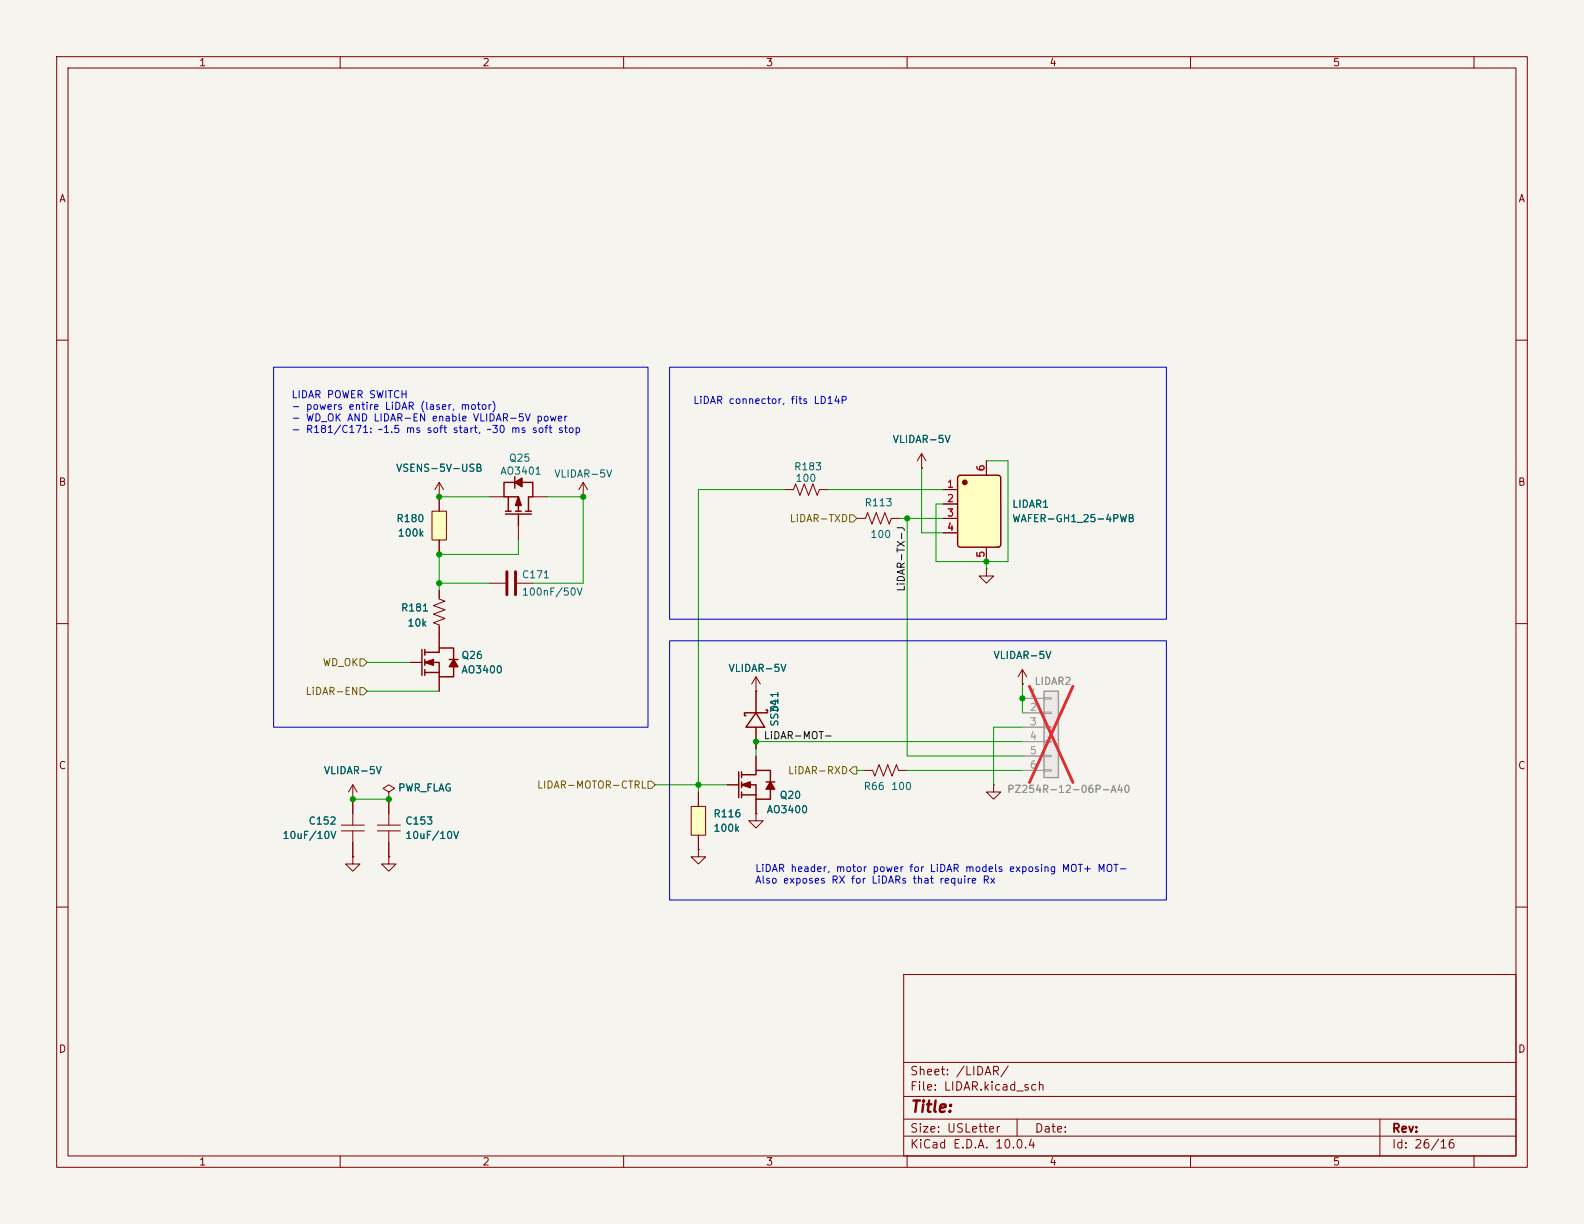
[picture p17: page 12]

LIDAR POWER SWITCH - powers entire LiDAR (laser, motor) - WD_OK AND LIDAR-EN enable VLIDAR-5V power - R181/C171: ~1.5 ms soft start, ~30 ms soft stop
100k VLIDAR-5V C152

LiDAR header, motor power for LiDAR models exposing MOT+ MOT-
Also exposes RX for LiDARs that require Rx

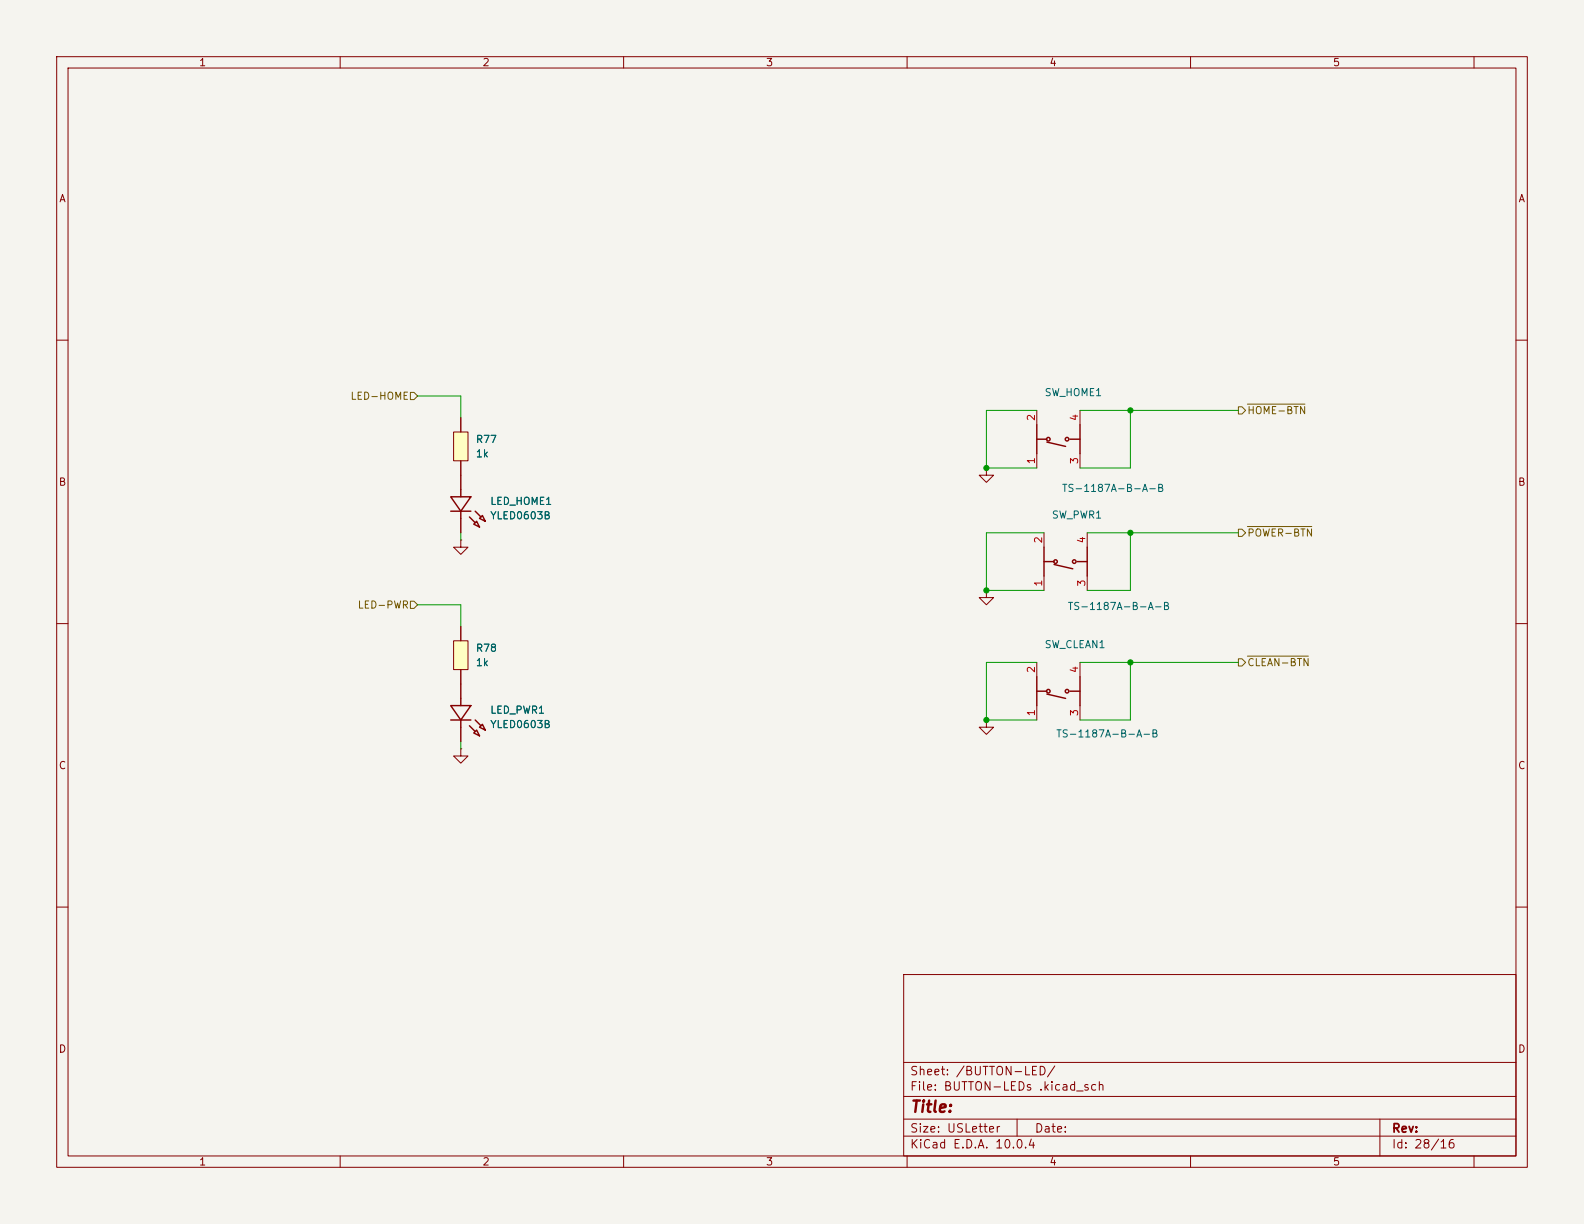
[picture p18: page 13]

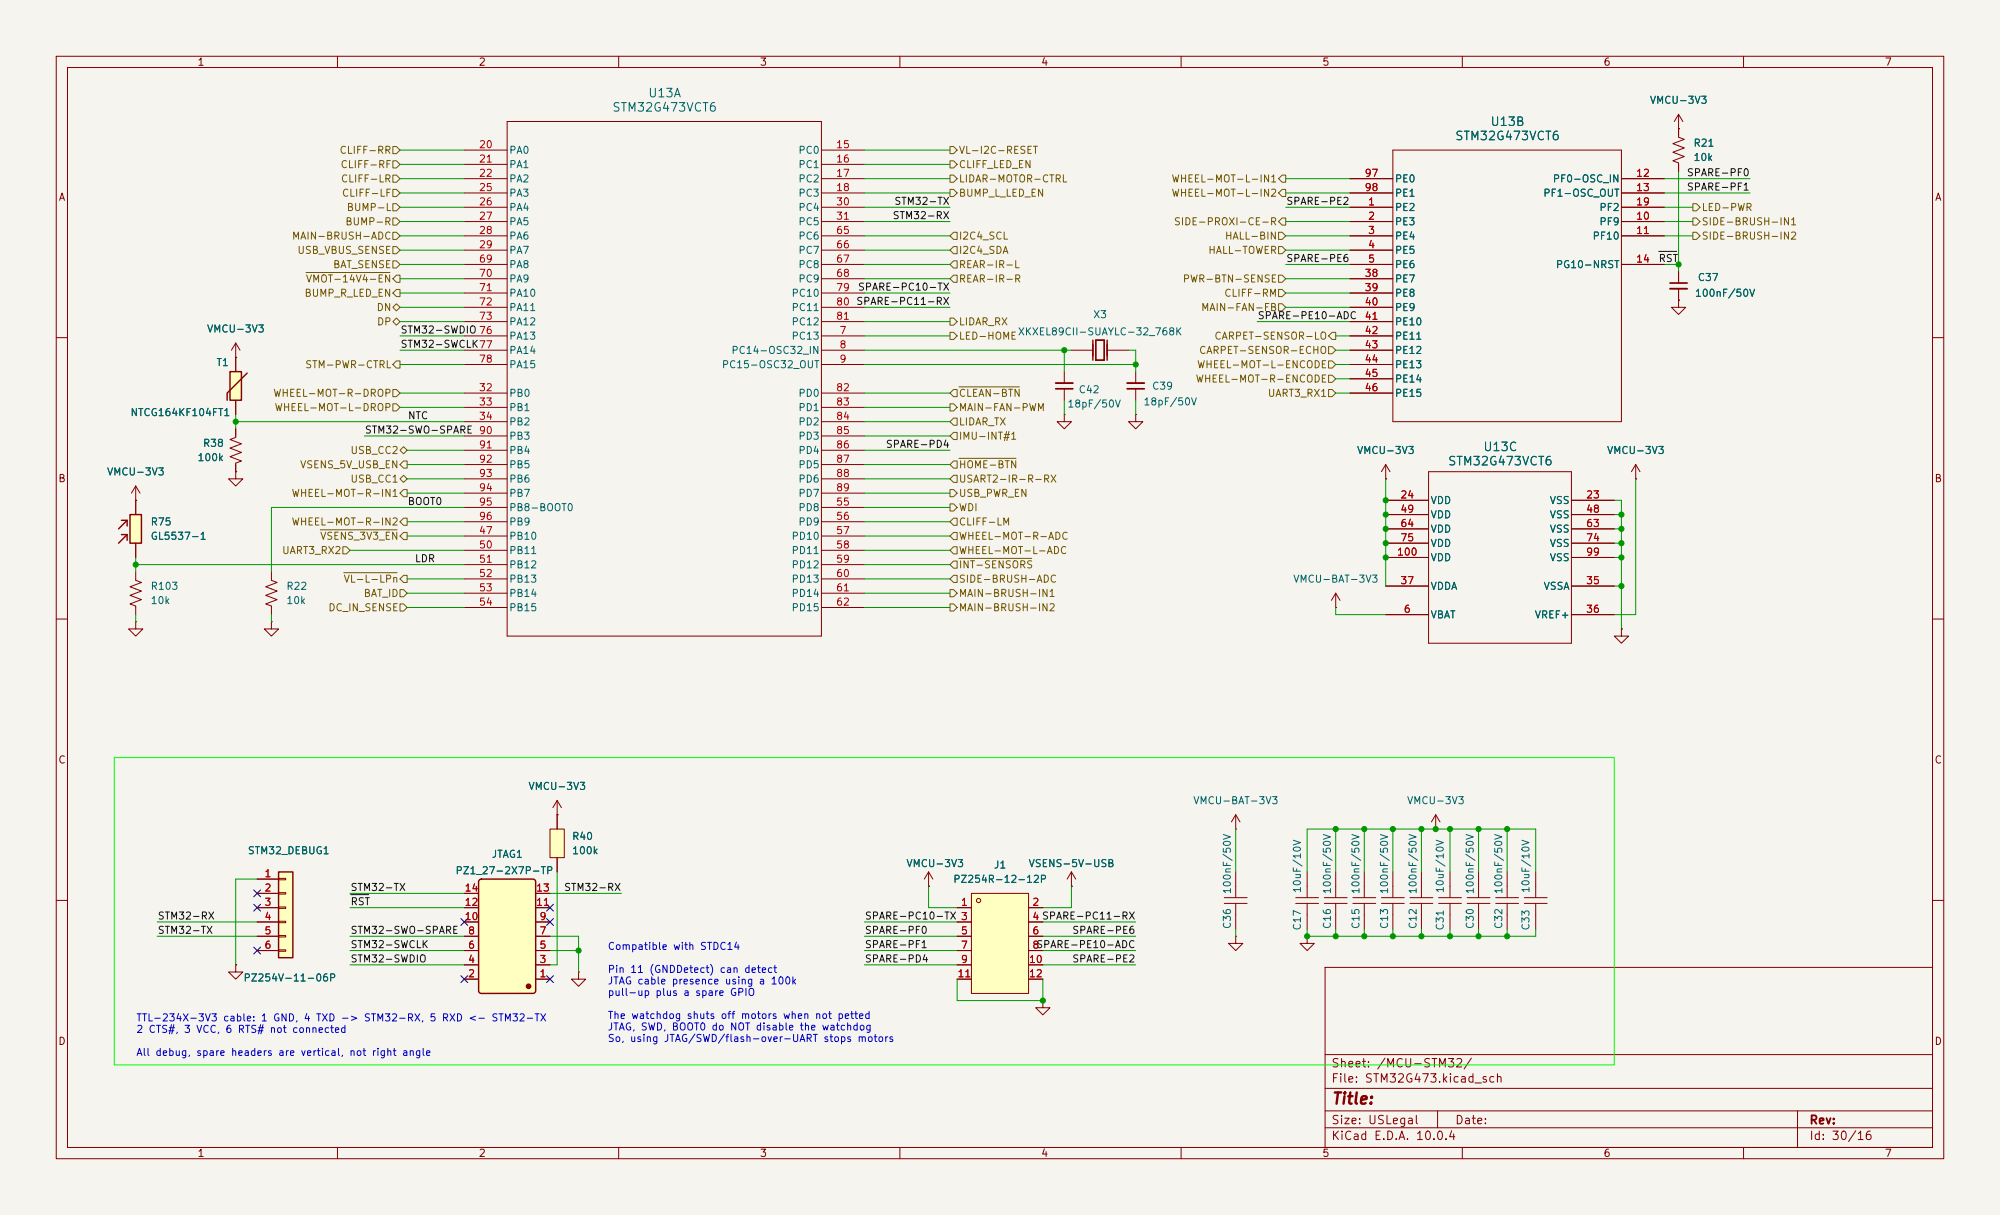
[picture p19: page 14]

LIDAR-MOTOR-CTRL VL-I2C-RESET
I2C4_SCL CLIFF_LED_EN

WHEEL-MOT-L-IN1 DP MAIN-BRUSH-ADC USB_VBUS_SENSE DN

SIDE-BRUSH-IN1 WHEEL-MOT-R-IN2

VL-L-LPn WHEEL-MOT-R-DROP
USB_CC2 BAT_ID USB_CC1 WHEEL-MOT-L-DROP

All debug, spare headers are vertical, not right angle STM32_DEBUG1 PZ254V-11-06P

TTL-234X-3V3 cable: 1 GND, 4 TXD -> STM32-RX, 5 RXD <- STM32-TX
2 CTS#, 3 VCC, 6 RTS# not connected

The watchdog shuts off motors when not petted
JTAG, SWD, BOOT0 do NOT disable the watchdog
So, using JTAG/SWD/flash-over-UART stops motors

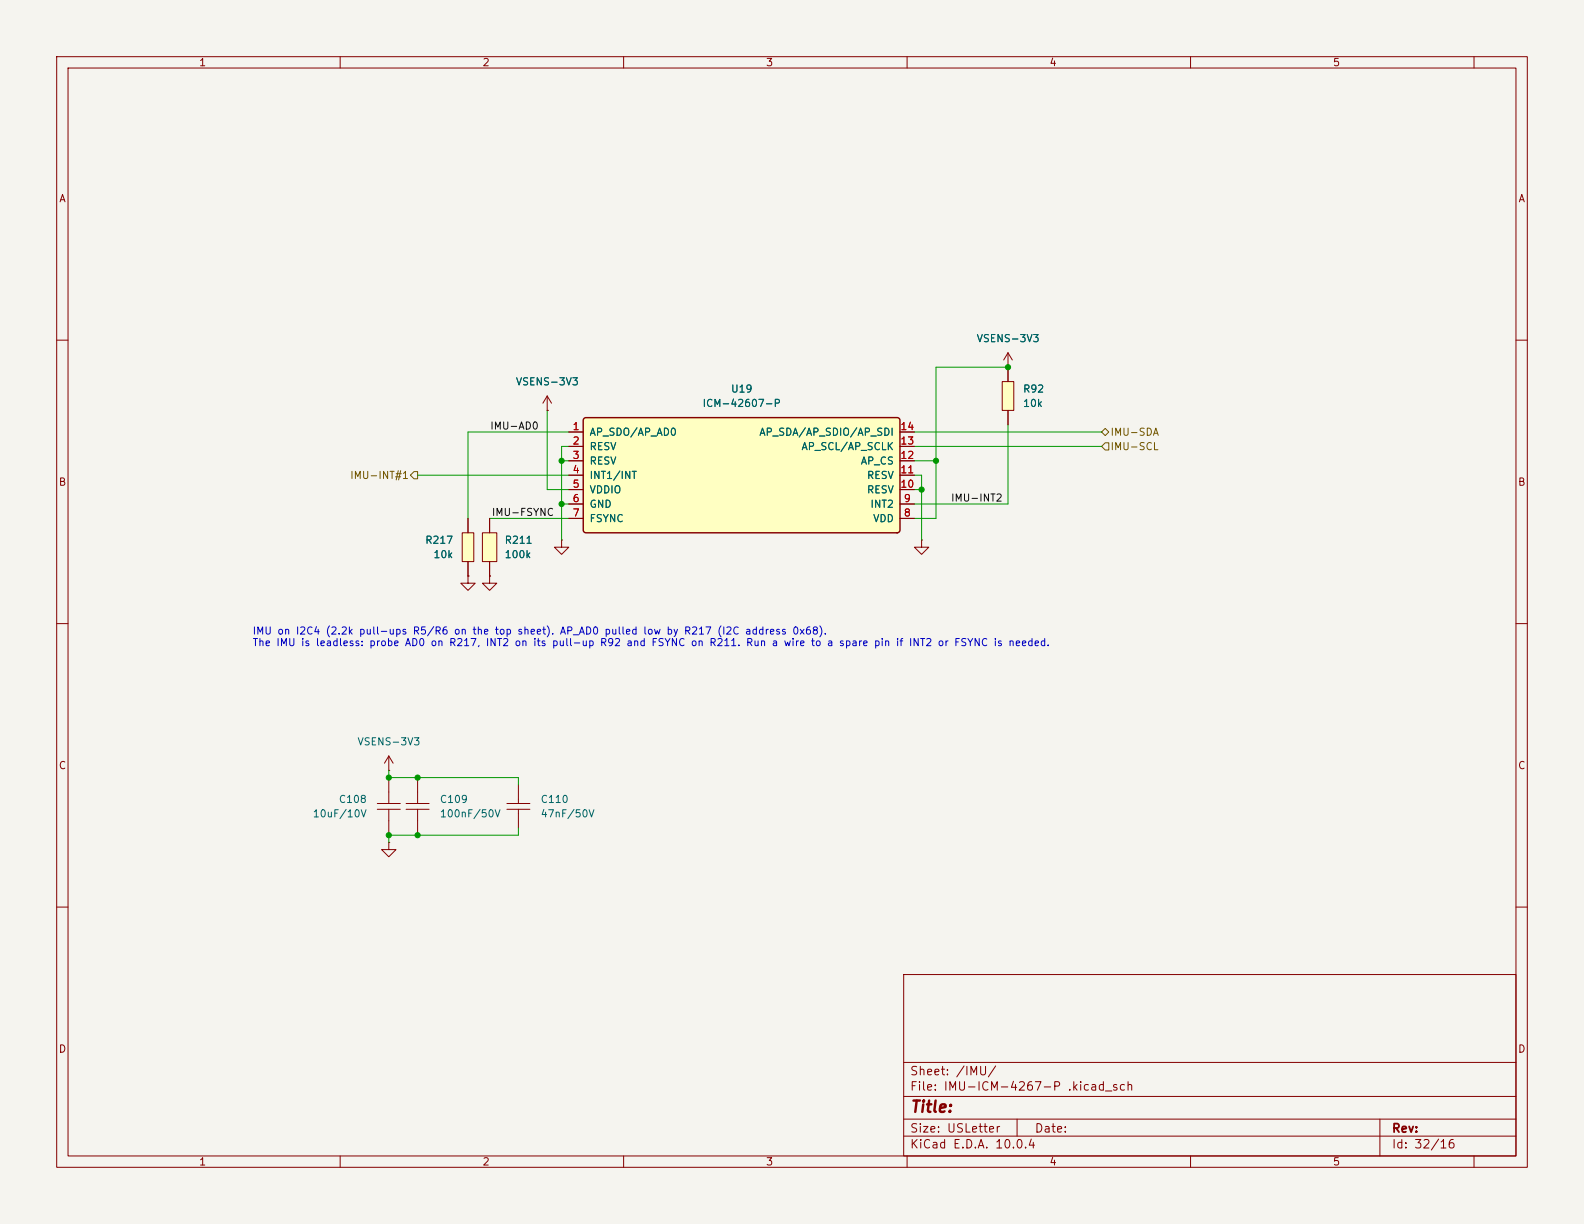
[picture p20: page 15]

IMU on I2C4 (2.2k pull-ups R5/R6 on the top sheet). AP_AD0 pulled low by R217 (I2C address 0x68). The IMU is leadless: probe AD0 on R217, INT2 on its pull-up R92 and FSYNC on R211. Run a wire to a spare pin if INT2 or FSYNC is needed. VSENS-3V3 R92

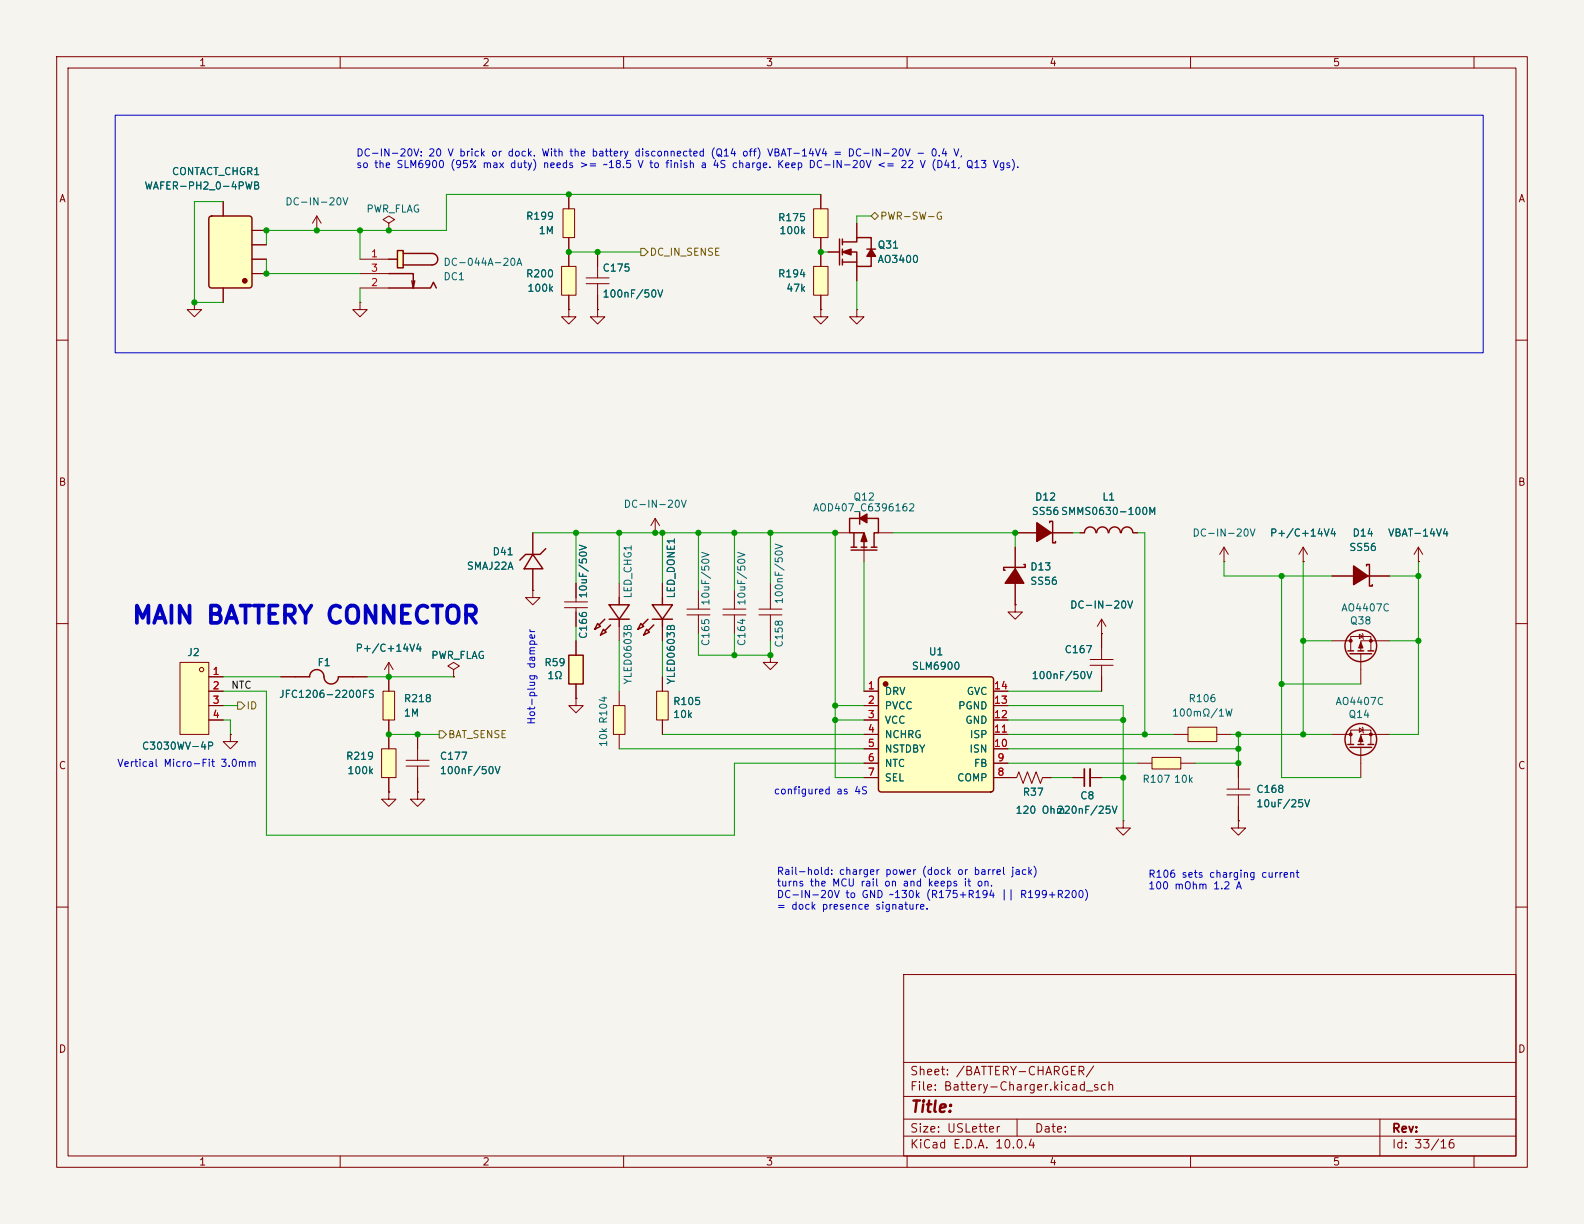
[picture p21: page 16]

ISN 10 ISP 11 GND 12 PGND 13 GVC 14 U1

ISN 10 ISP 11 GND 12 PGND 13 GVC 14

VCC 3 NCHRG 4 NSTDBY 5 NTC 6

turns the MCU rail on and keeps it on. DC-IN-20V to GND ~130k (R175+R194 || R199+R200) = dock presence signature.
