Grammid/oomwoo-pcb/kicad/main/output/Main.pdf

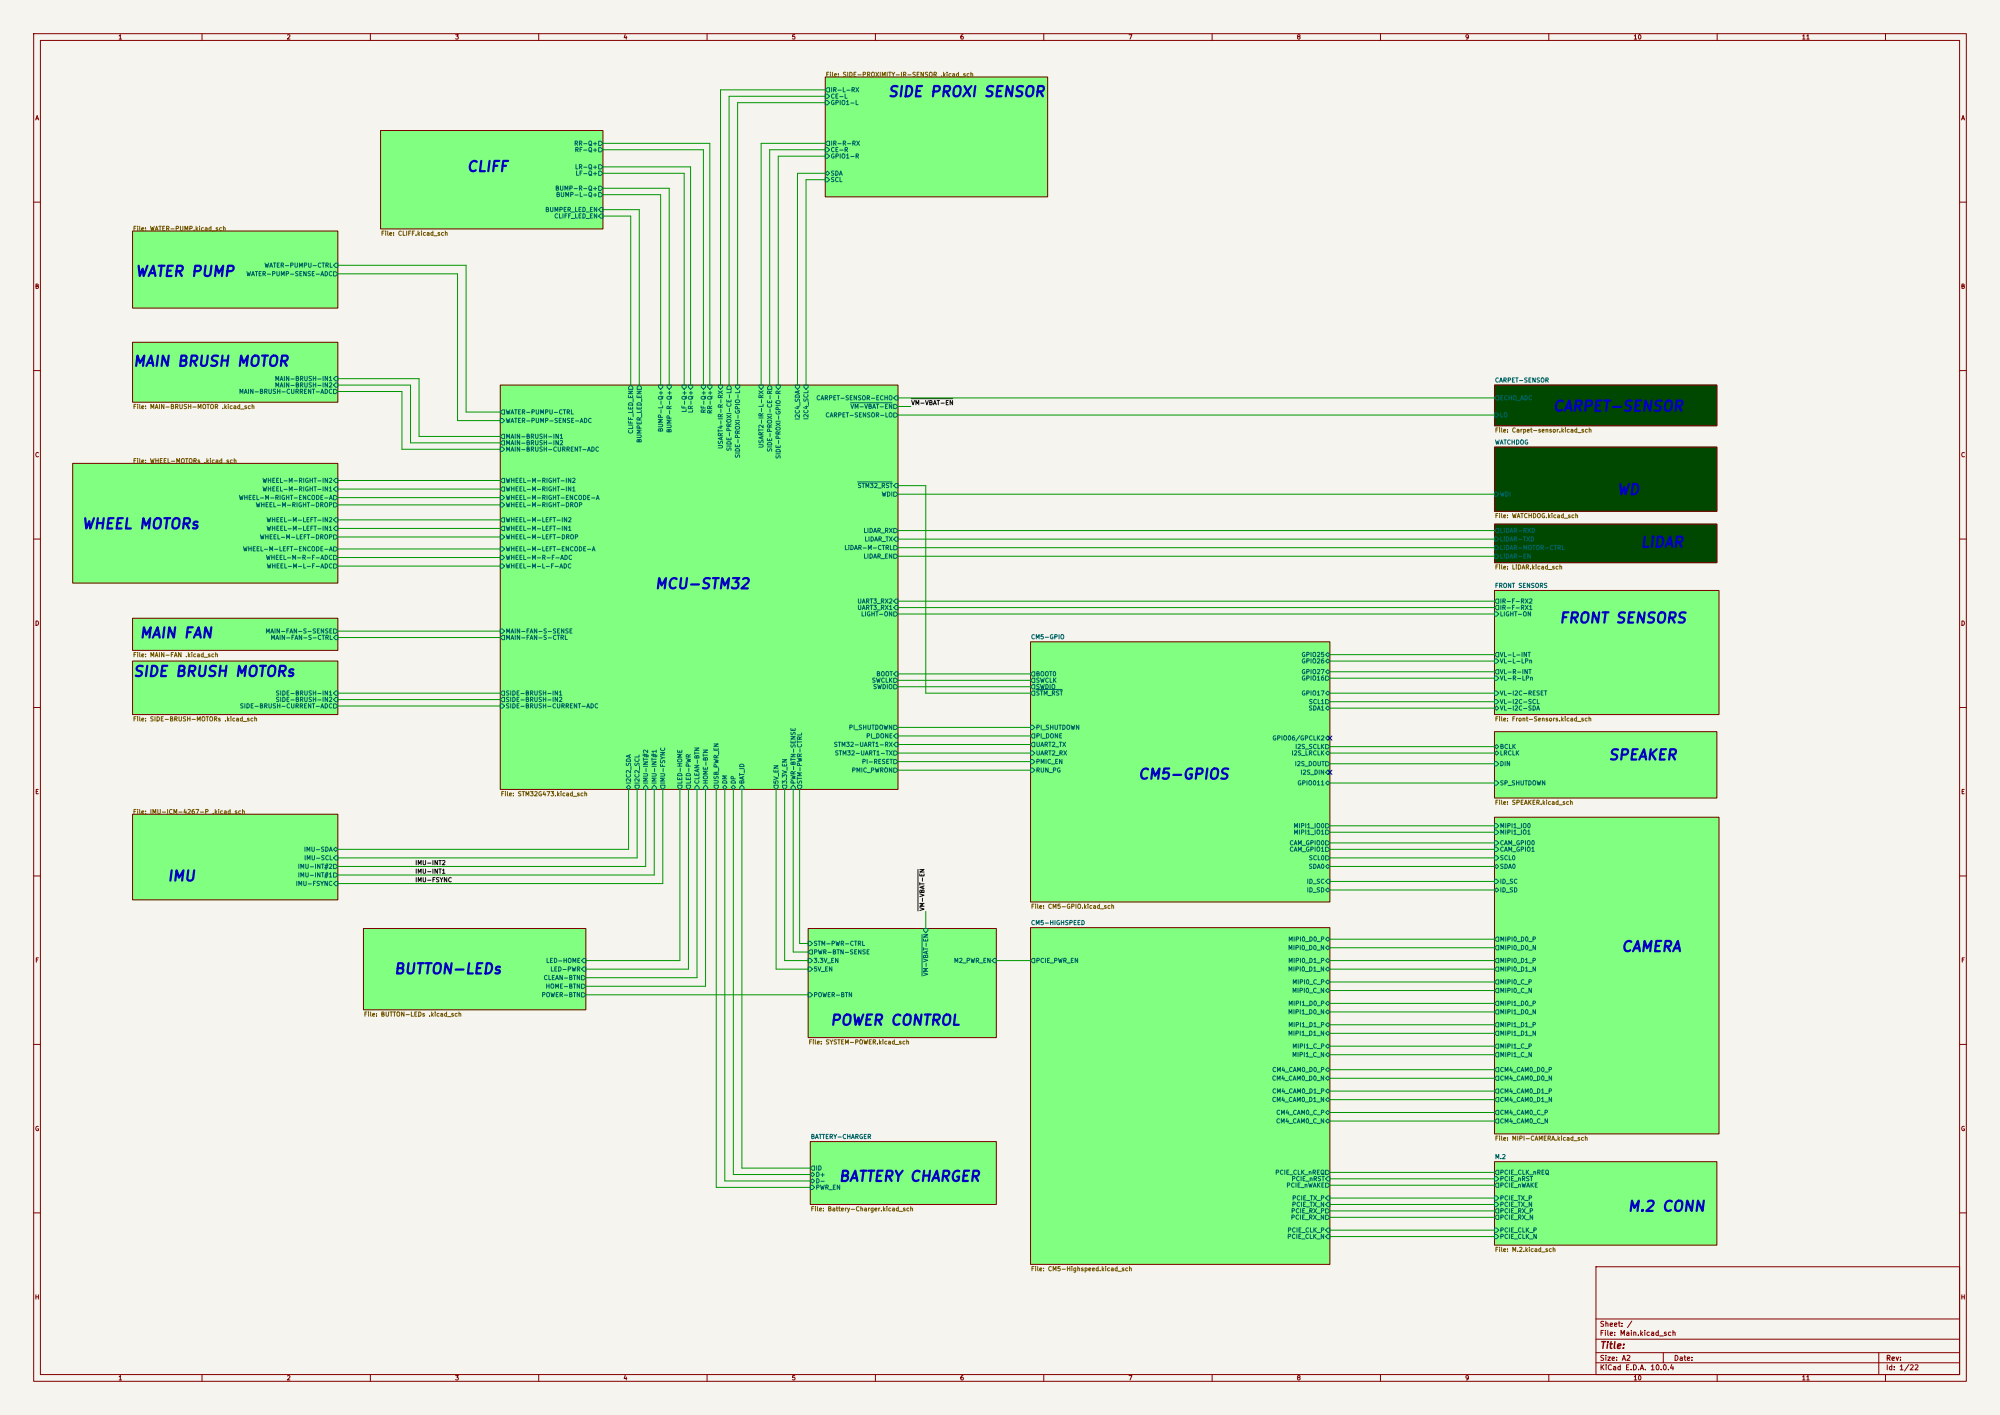
[picture p22: page 1]

WATER-PUMPU-CTRL WATER-PUMP-SENSE-ADC

File: MAIN-BRUSH-MOTOR .kicad_sch WHEEL-M-RIGHT-IN2 WHEEL-M-RIGHT-IN1 WHEEL-M-RIGHT-ENCODE-A WHEEL-M-LEFT-IN2 WHEEL-M-LEFT-IN1 WHEEL-M-LEFT-ENCODE-A WHEEL-M-R-F-ADC WHEEL-M-L-F-ADC WHEEL-M-LEFT-DROP WHEEL-M-RIGHT-DROP

File: Carpet-sensor.kicad_sch
File: LiDAR.kicad_sch WDI WATCHDOG

MAIN-FAN-S-CTRL MAIN-FAN-S-SENSE

VL-L-INT VL-L-LPn

VL-R-INT VL-R-LPn

VL-I2C-RESET VL-I2C-SCL VL-I2C-SDA

File: CM5-GPIO.kicad_sch SIDE-BRUSH-CURRENT-ADC

SIDE-BRUSH-CURRENT-ADC

File: Front-Sensors.kicad_sch BCLK

LED-HOME
LED-PWR HOME-BTN
CLEAN-BTN

Size: A2 | Rev:
KiCad E.D.A. 10.0.4 | Id: 1/22

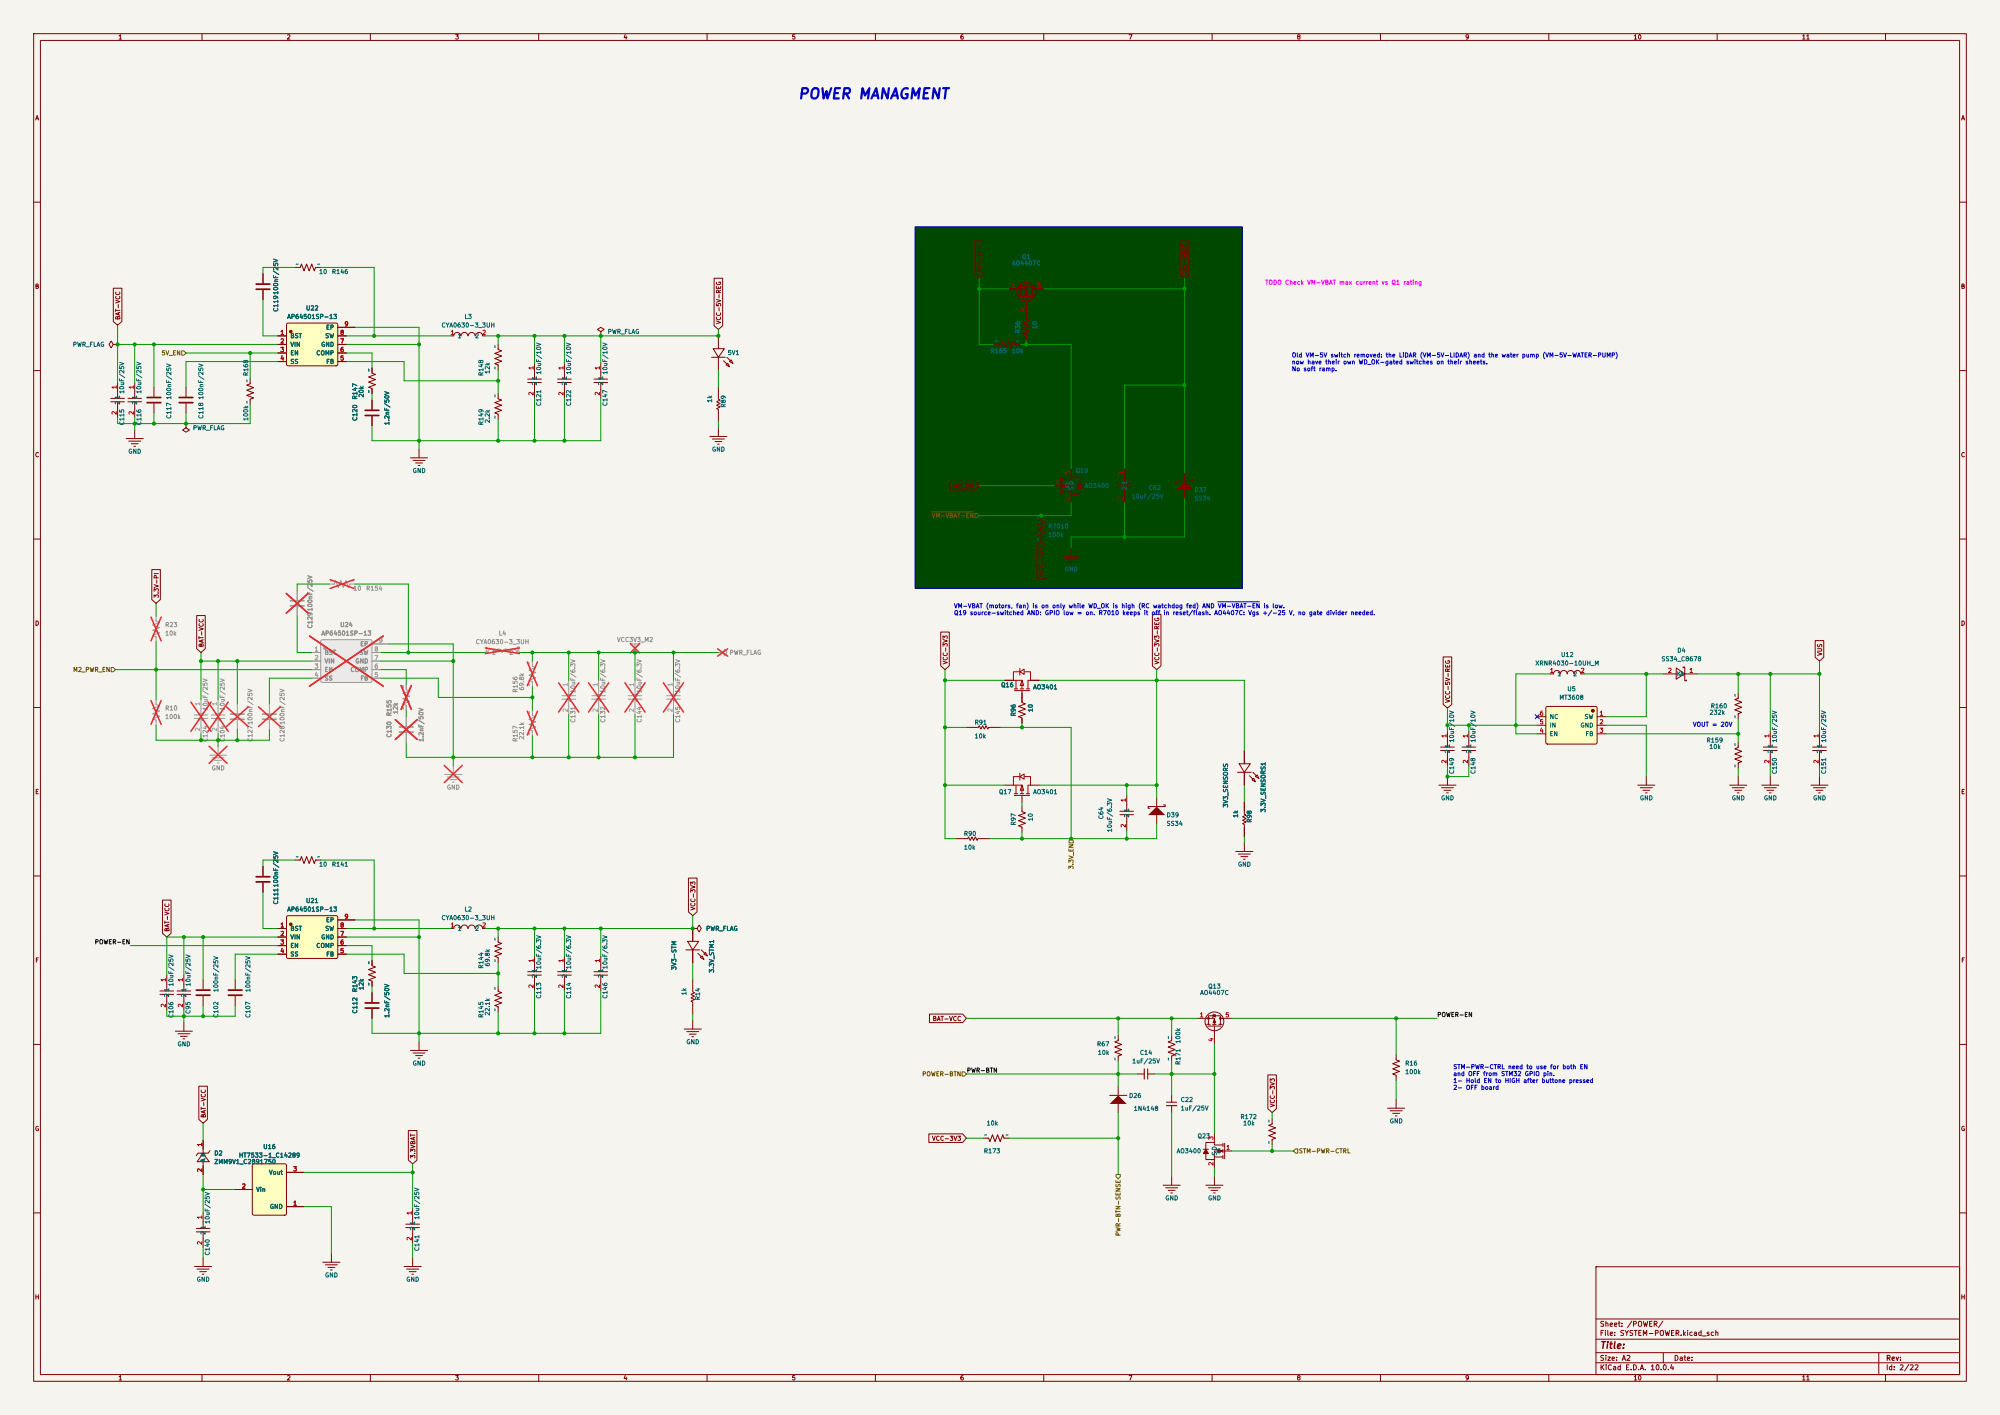
[picture p23: page 2]

TODO Check VM-VBAT max current vs Q1 rating Old VM-5V switch removed: the LiDAR (VM-5V-LIDAR) and the water pump (VM-5V-WATER-PUMP) now have their own WD_OK-gated switches on their sheets. No soft ramp. VM-VBAT (motors, fan) is on only while WD_OK is high (RC watchdog fed) AND VM-VBAT-EN is low. Q19 source-switched AND: GPIO low = on. R7010 keeps it off in reset/flash. AO4407C: Vgs +/-25 V, no gate divider needed.

STM-PWR-CTRL need to use for both EN
and OFF from STM32 GPIO pin. 1- Hold EN to HIGH after buttone pressed 2- OFF board

STM-PWR-CTRL POWER-BTN

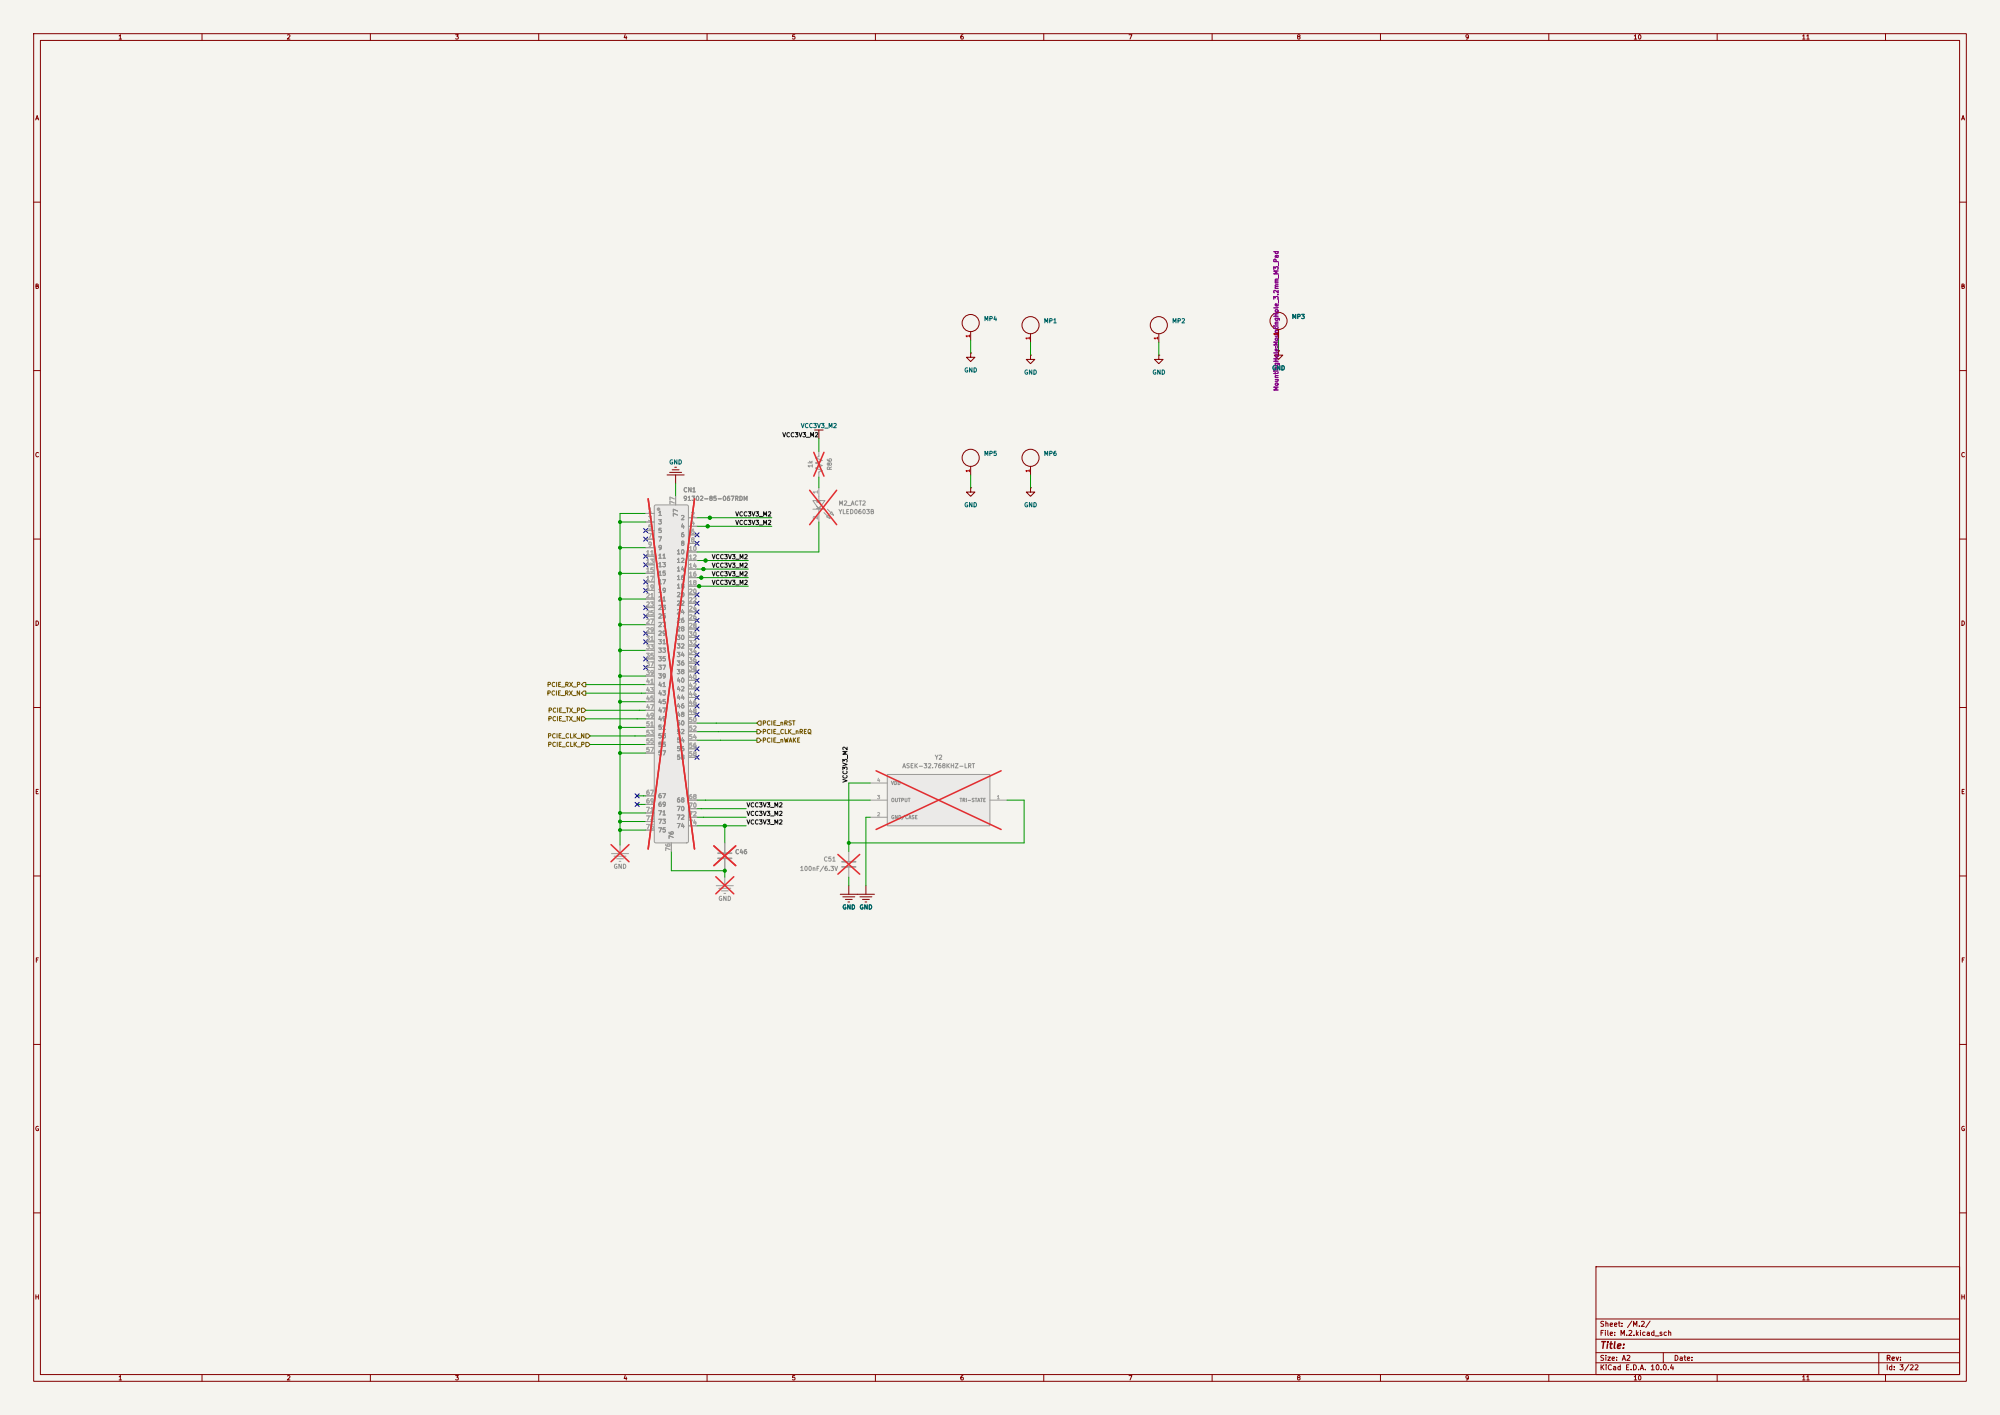
[picture p24: page 3]

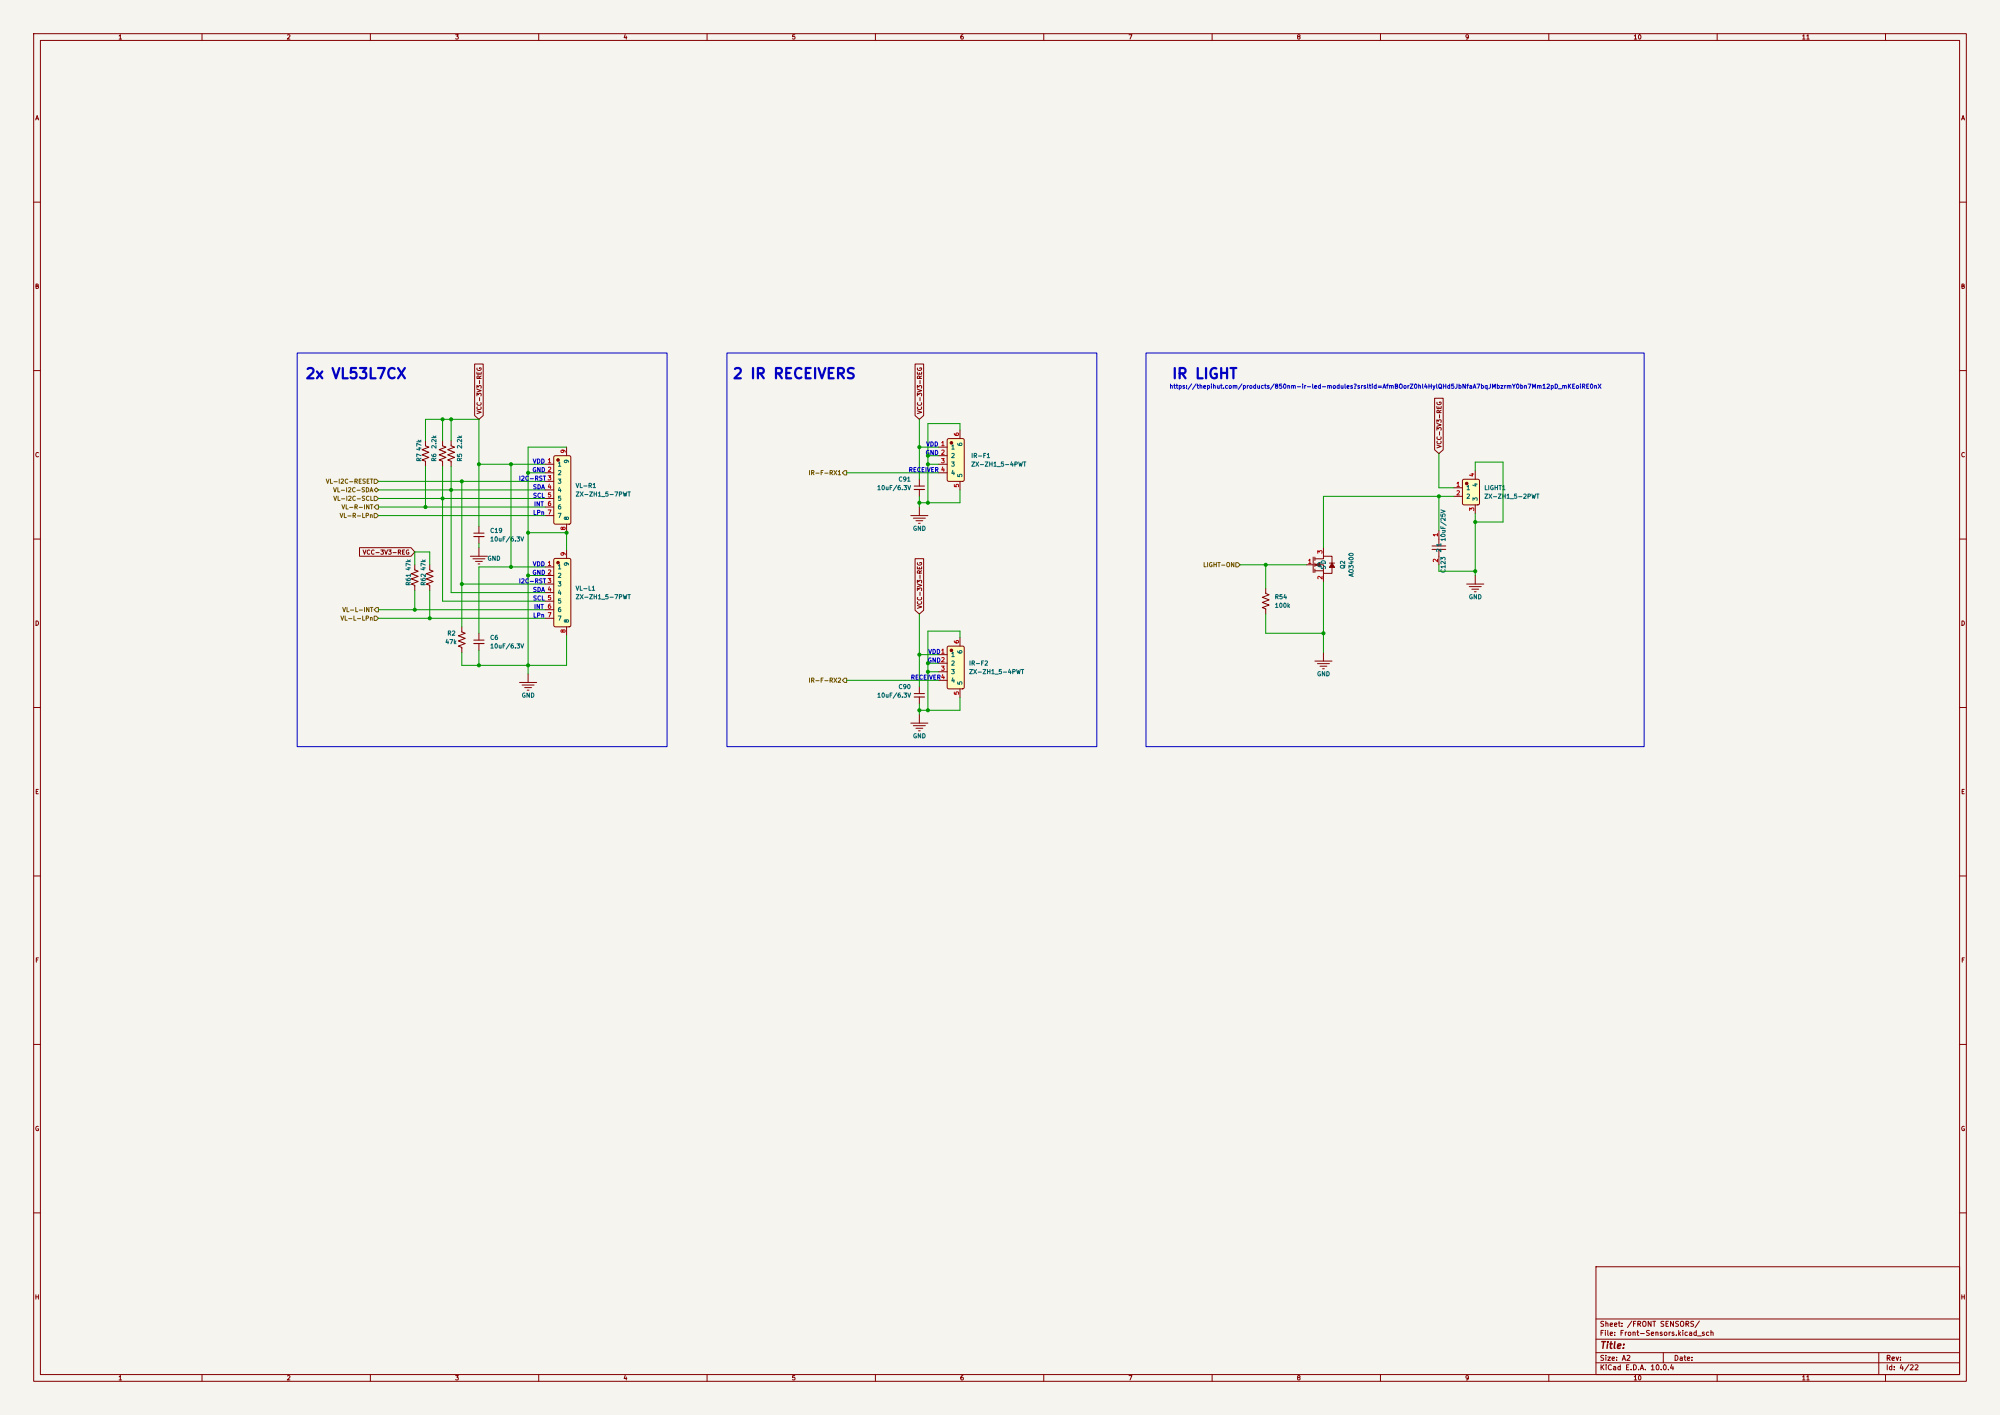
[picture p25: page 4]

VL-I2C-RESET VL-I2C-SDA

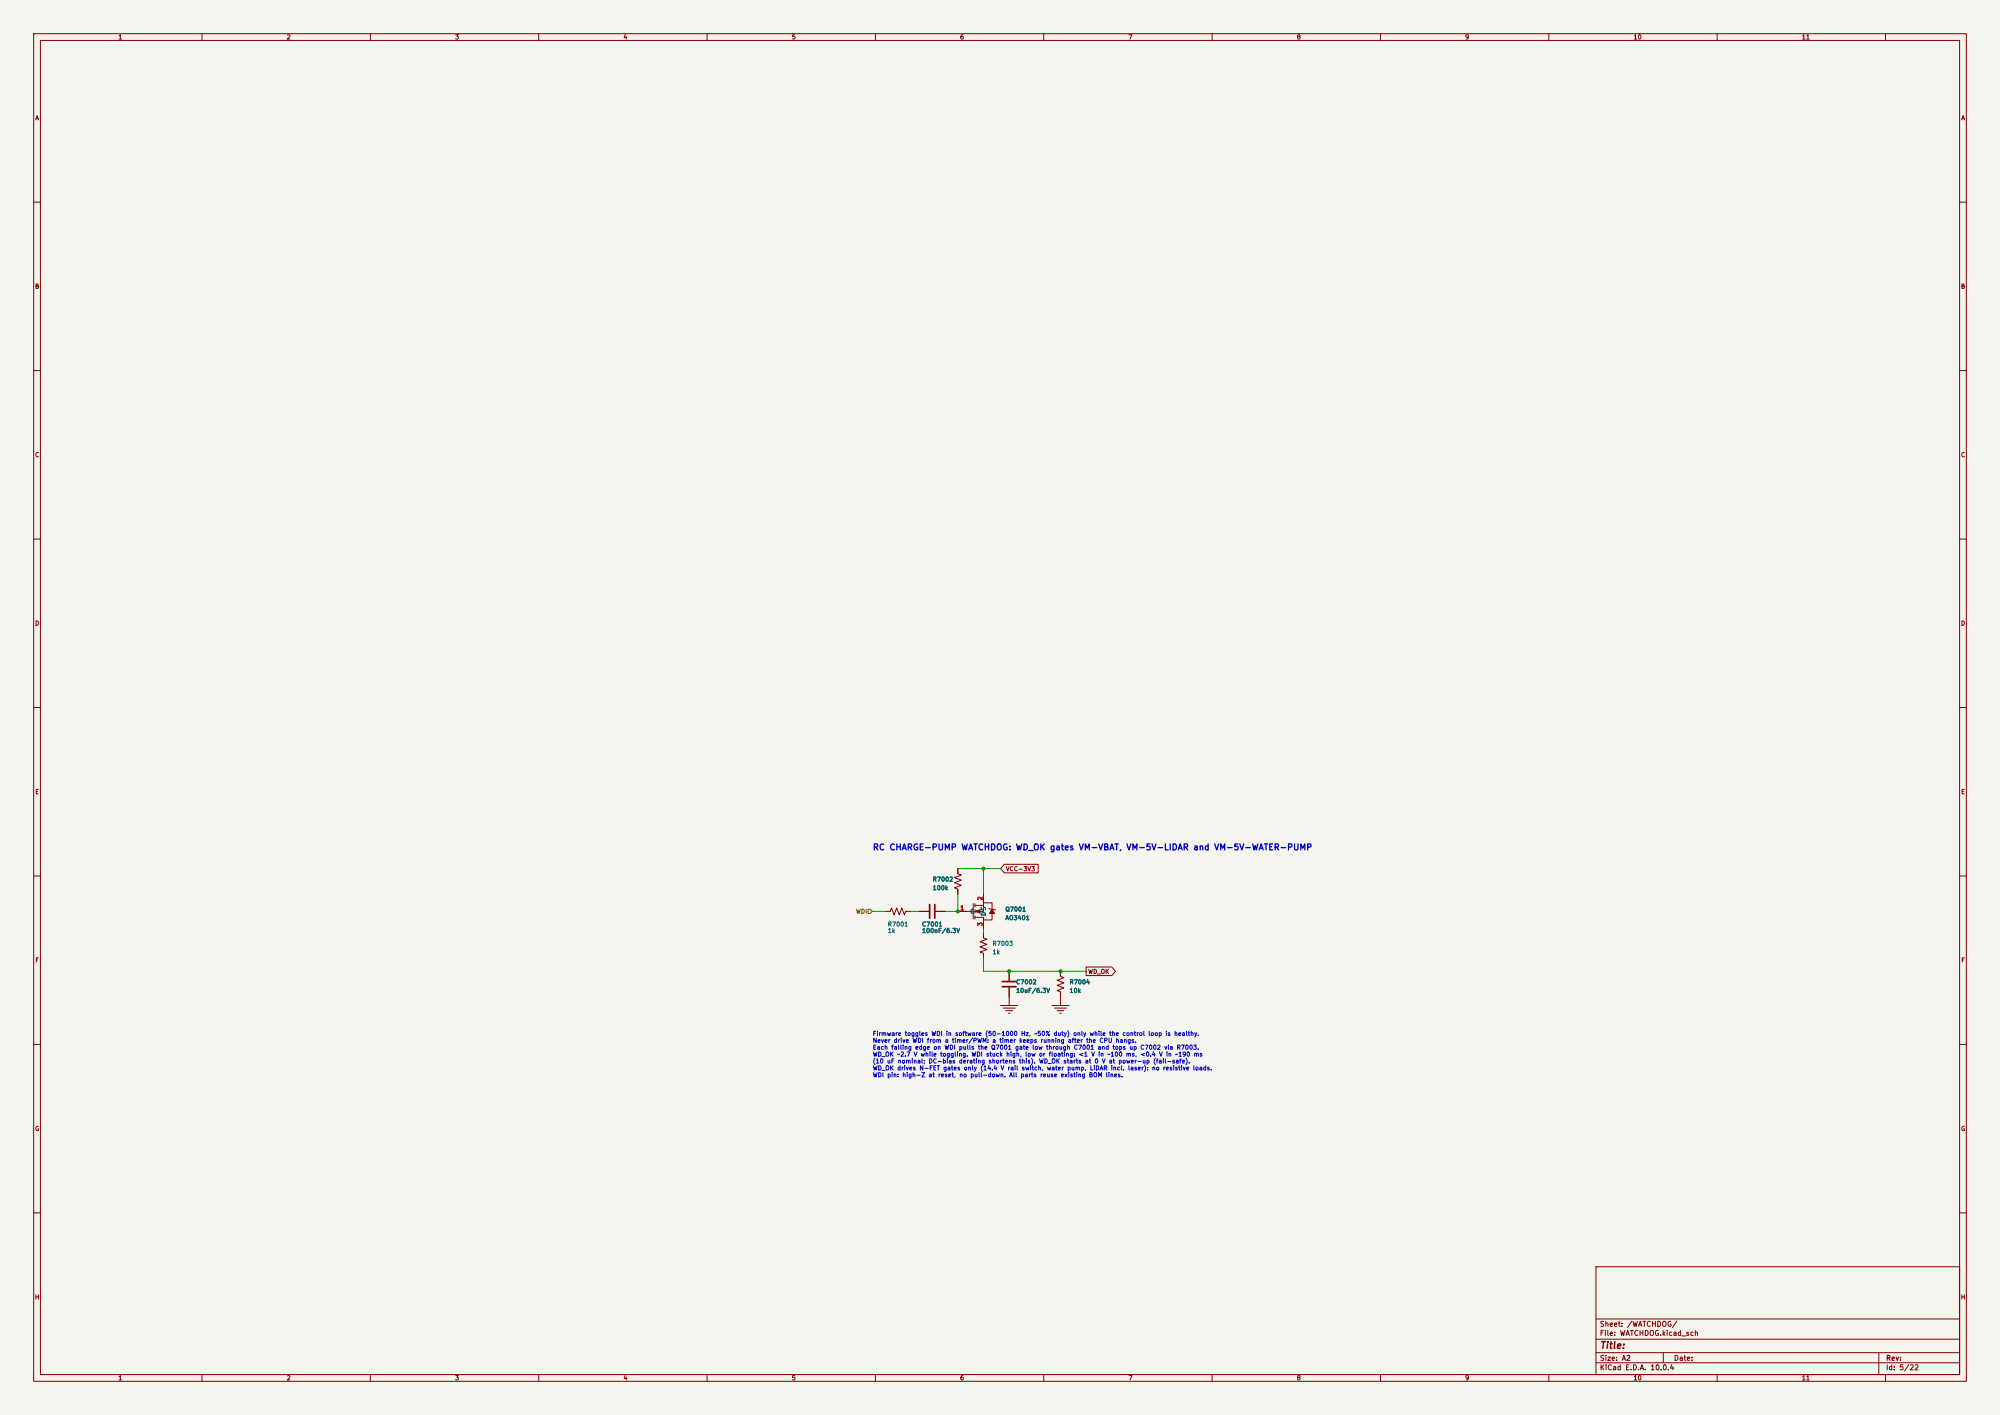
[picture p26: page 5]

VCC-3V3 RC CHARGE-PUMP WATCHDOG: WD_OK gates VM-VBAT, VM-5V-LIDAR and VM-5V-WATER-PUMP

(10 uF nominal; DC-bias derating shortens this). WD_OK starts at 0 V at power-up (fail-safe). WD_OK drives N-FET gates only (14.4 V rail switch, water pump, LiDAR incl. laser): no resistive loads. WDI pin: high-Z at reset, no pull-down. All parts reuse existing BOM lines. R7004

Firmware toggles WDI in software (50-1000 Hz, ~50% duty) only while the control loop is healthy. Never drive WDI from a timer/PWM: a timer keeps running after the CPU hangs. Each falling edge on WDI pulls the Q7001 gate low through C7001 and tops up C7002 via R7003. WD_OK ~2.7 V while toggling. WDI stuck high, low or floating: <1 V in ~100 ms, <0.4 V in ~190 ms

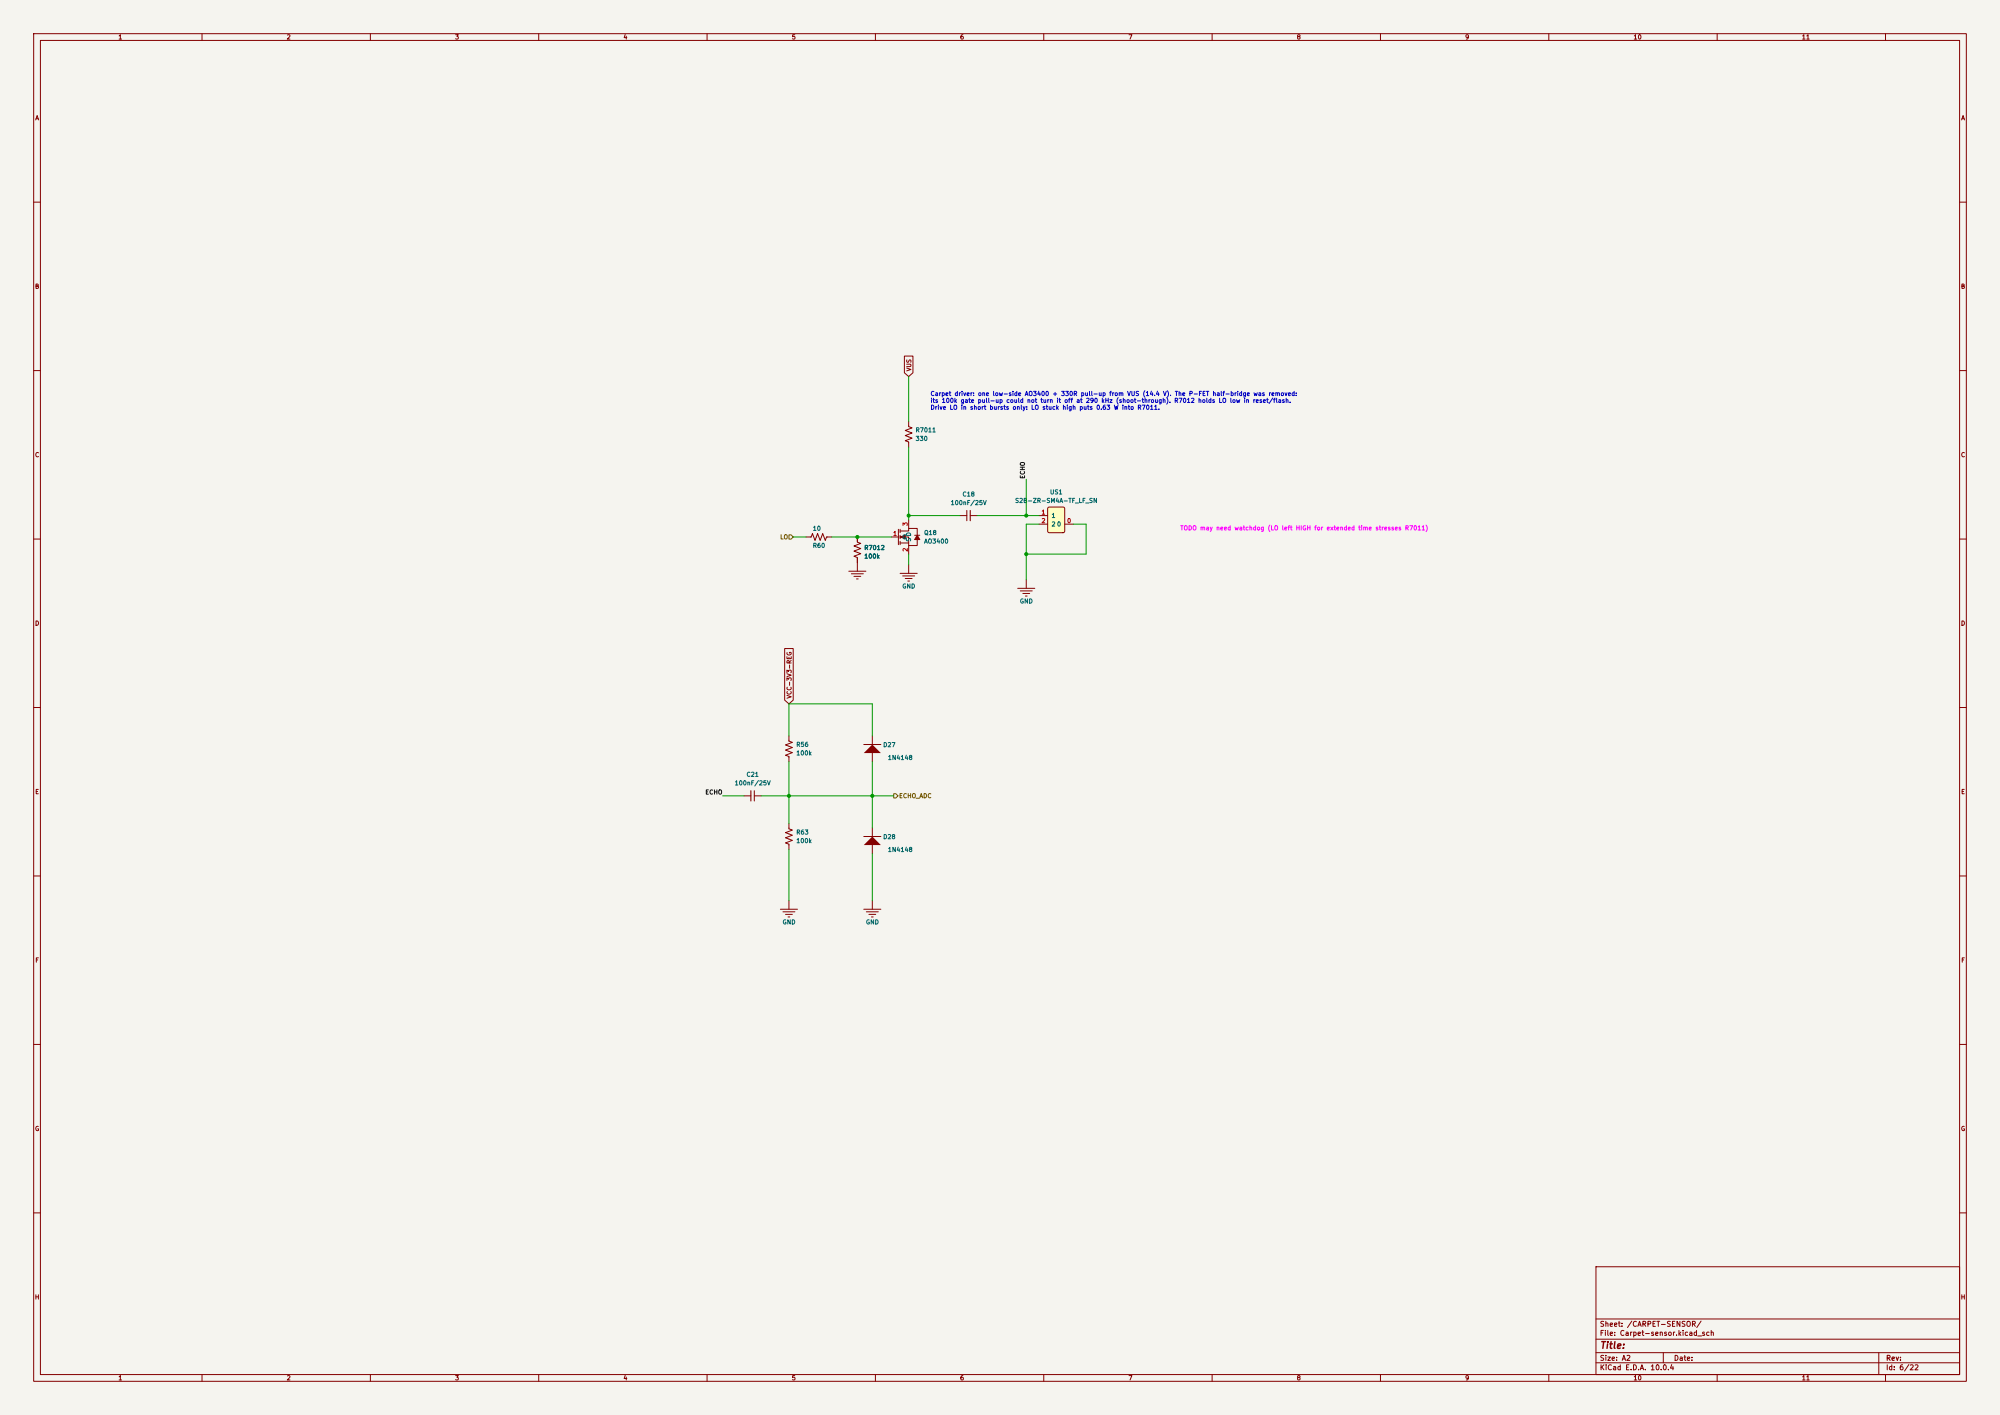
[picture p27: page 6]

Carpet driver: one low-side AO3400 + 330R pull-up from VUS (14.4 V). The P-FET half-bridge was removed:

its 100k gate pull-up could not turn it off at 290 kHz (shoot-through). R7012 holds LO low in reset/flash. Drive LO in short bursts only: LO stuck high puts 0.63 W into R7011. R7012

TODO may need watchdog (LO left HIGH for extended time stresses R7011)

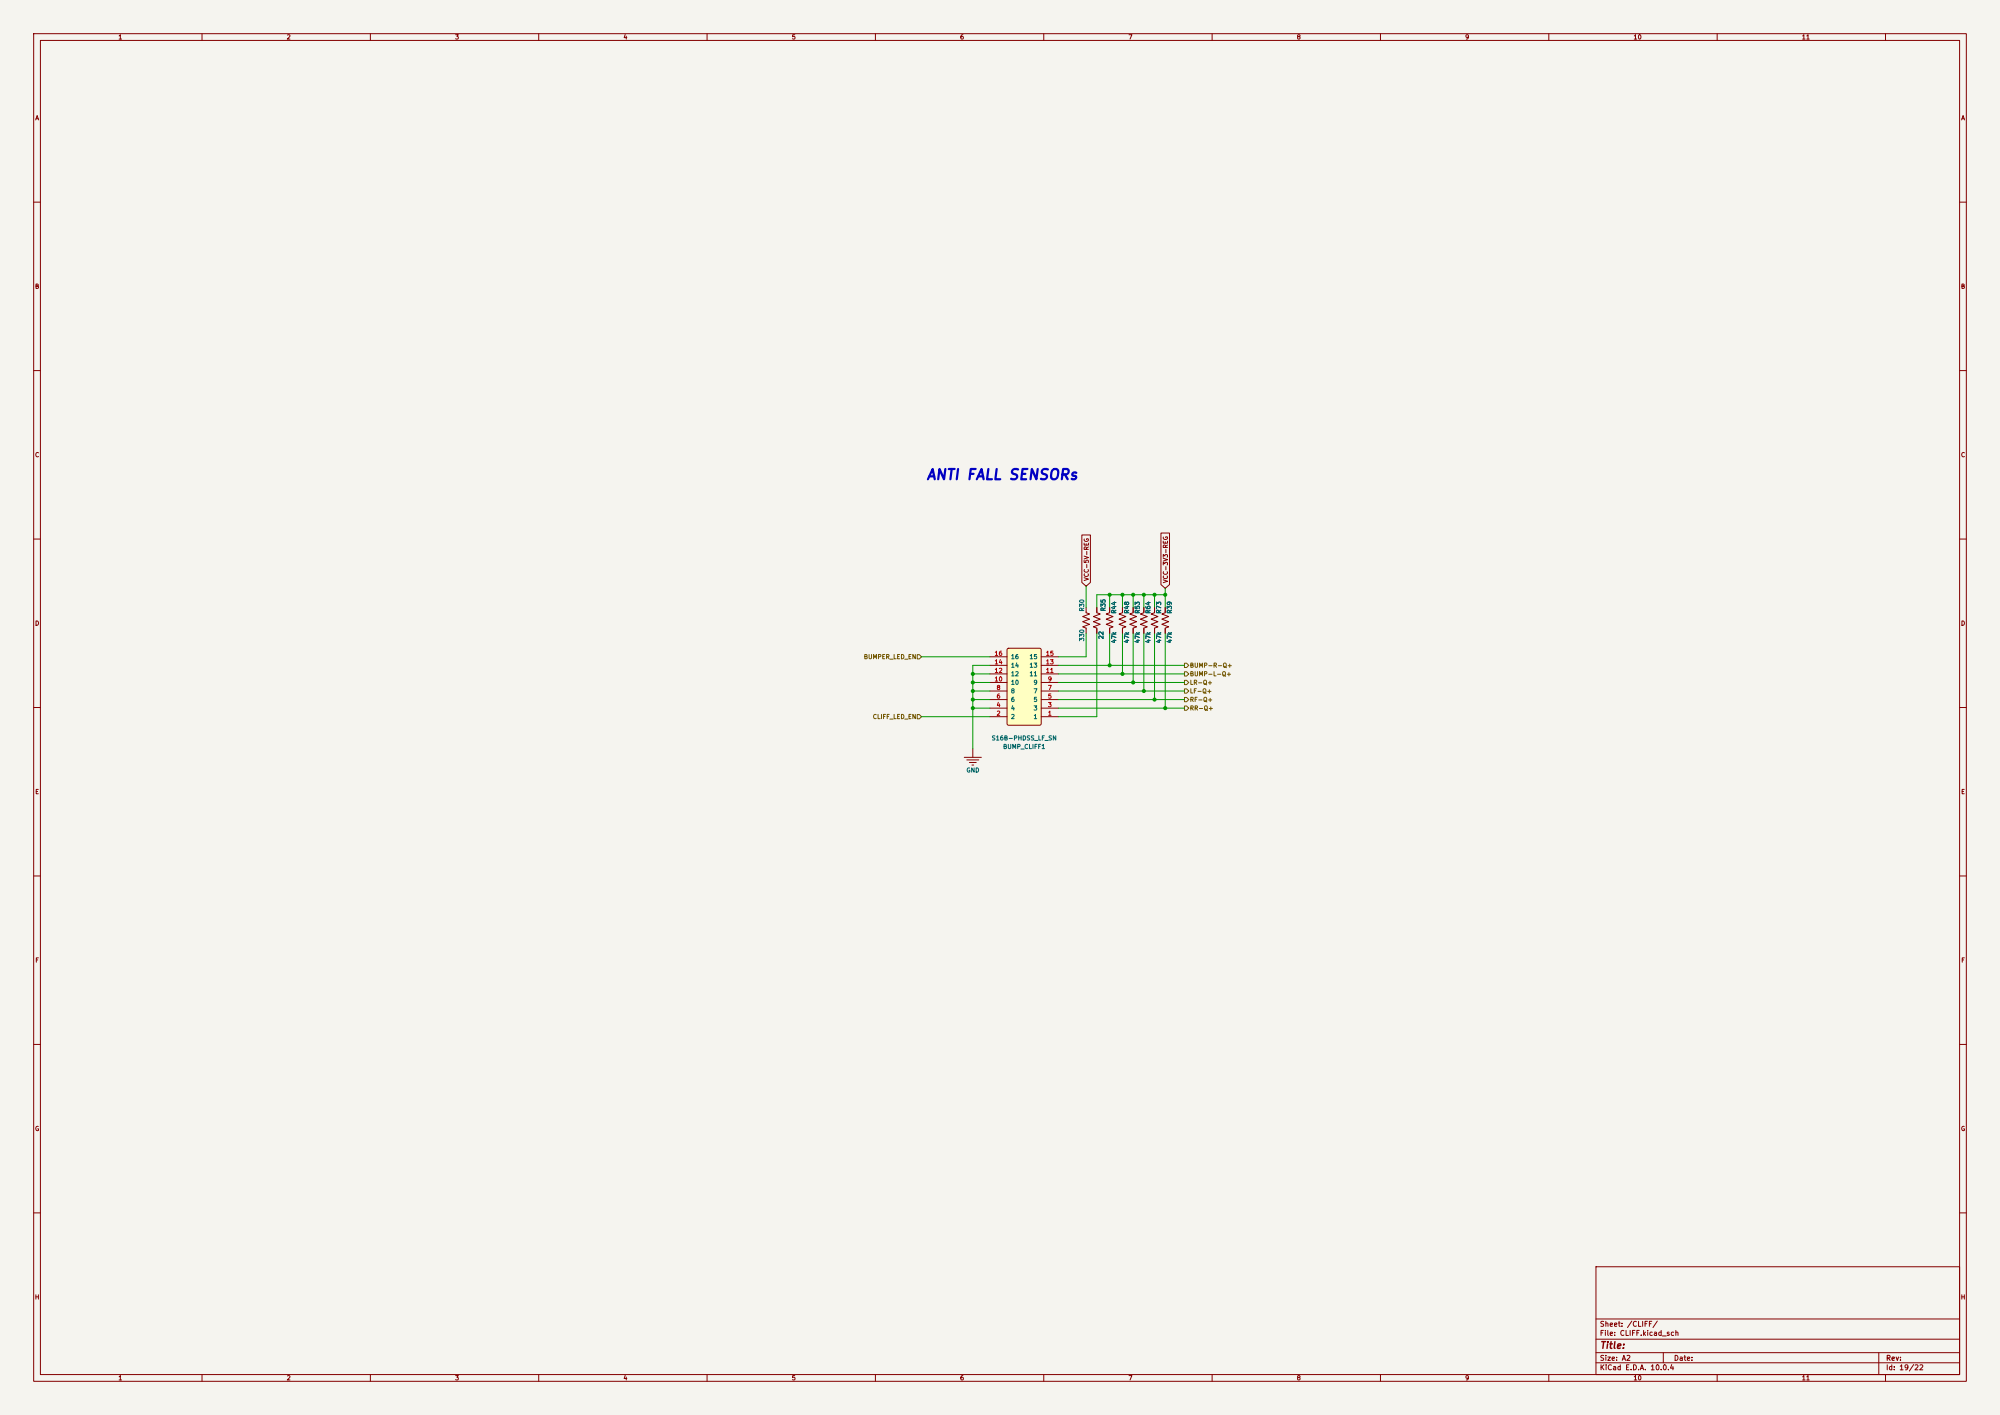
[picture p28: page 7]

BUMP-L-Q+ VCC-3V3-REG VCC-5V-REG

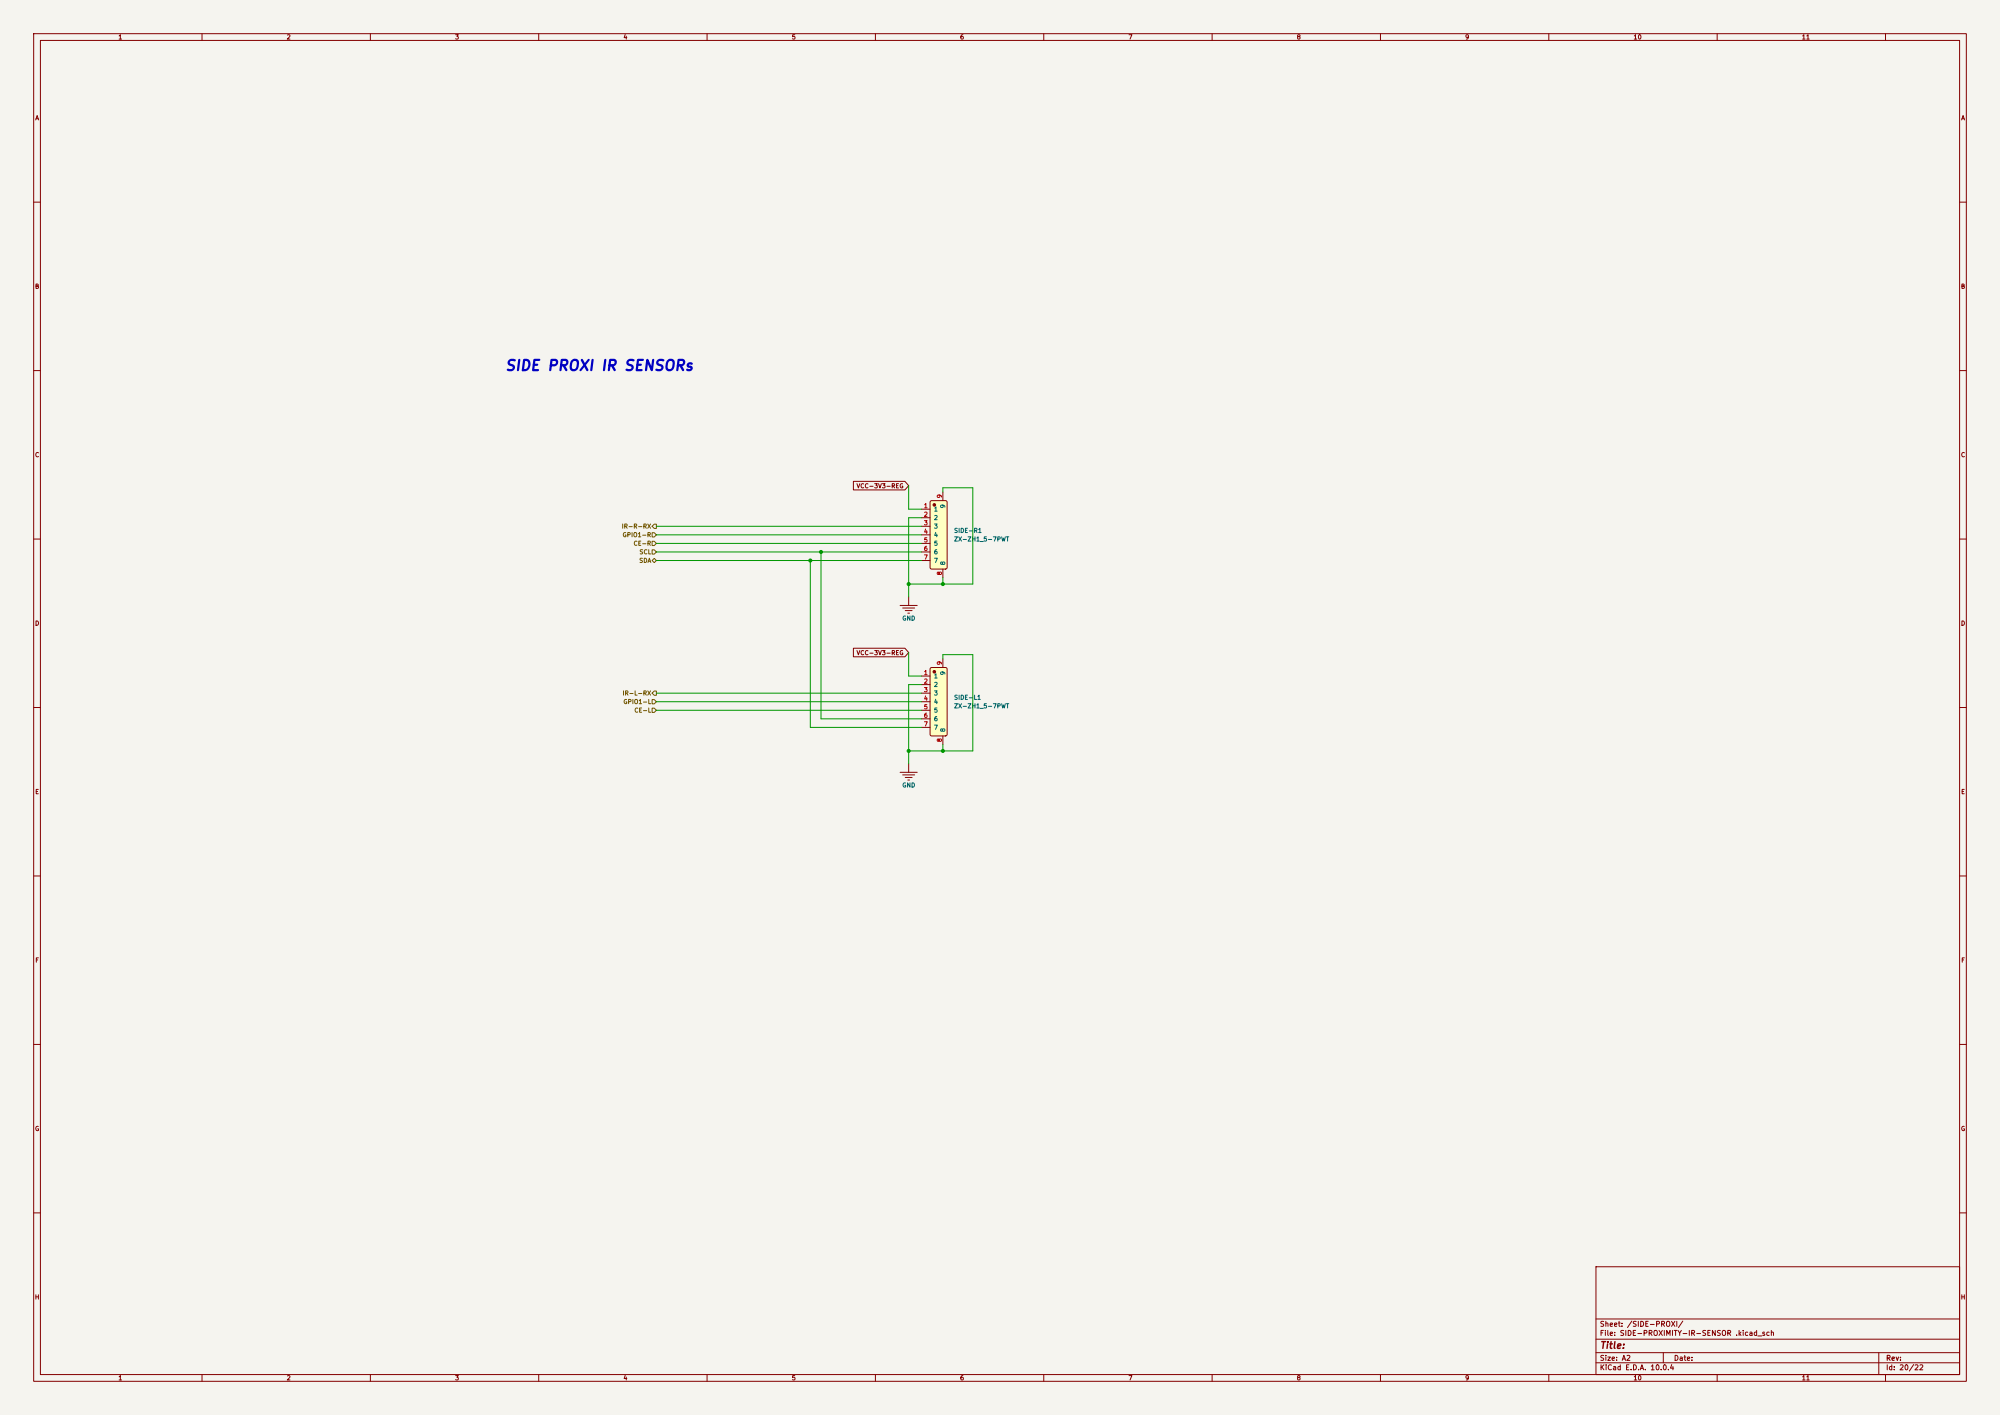
[picture p29: page 8]

VCC-3V3-REG SIDE PROXI IR SENSORs

Sheet: /SIDE-PROXI/
File: SIDE-PROXIMITY-IR-SENSOR .kicad_sch

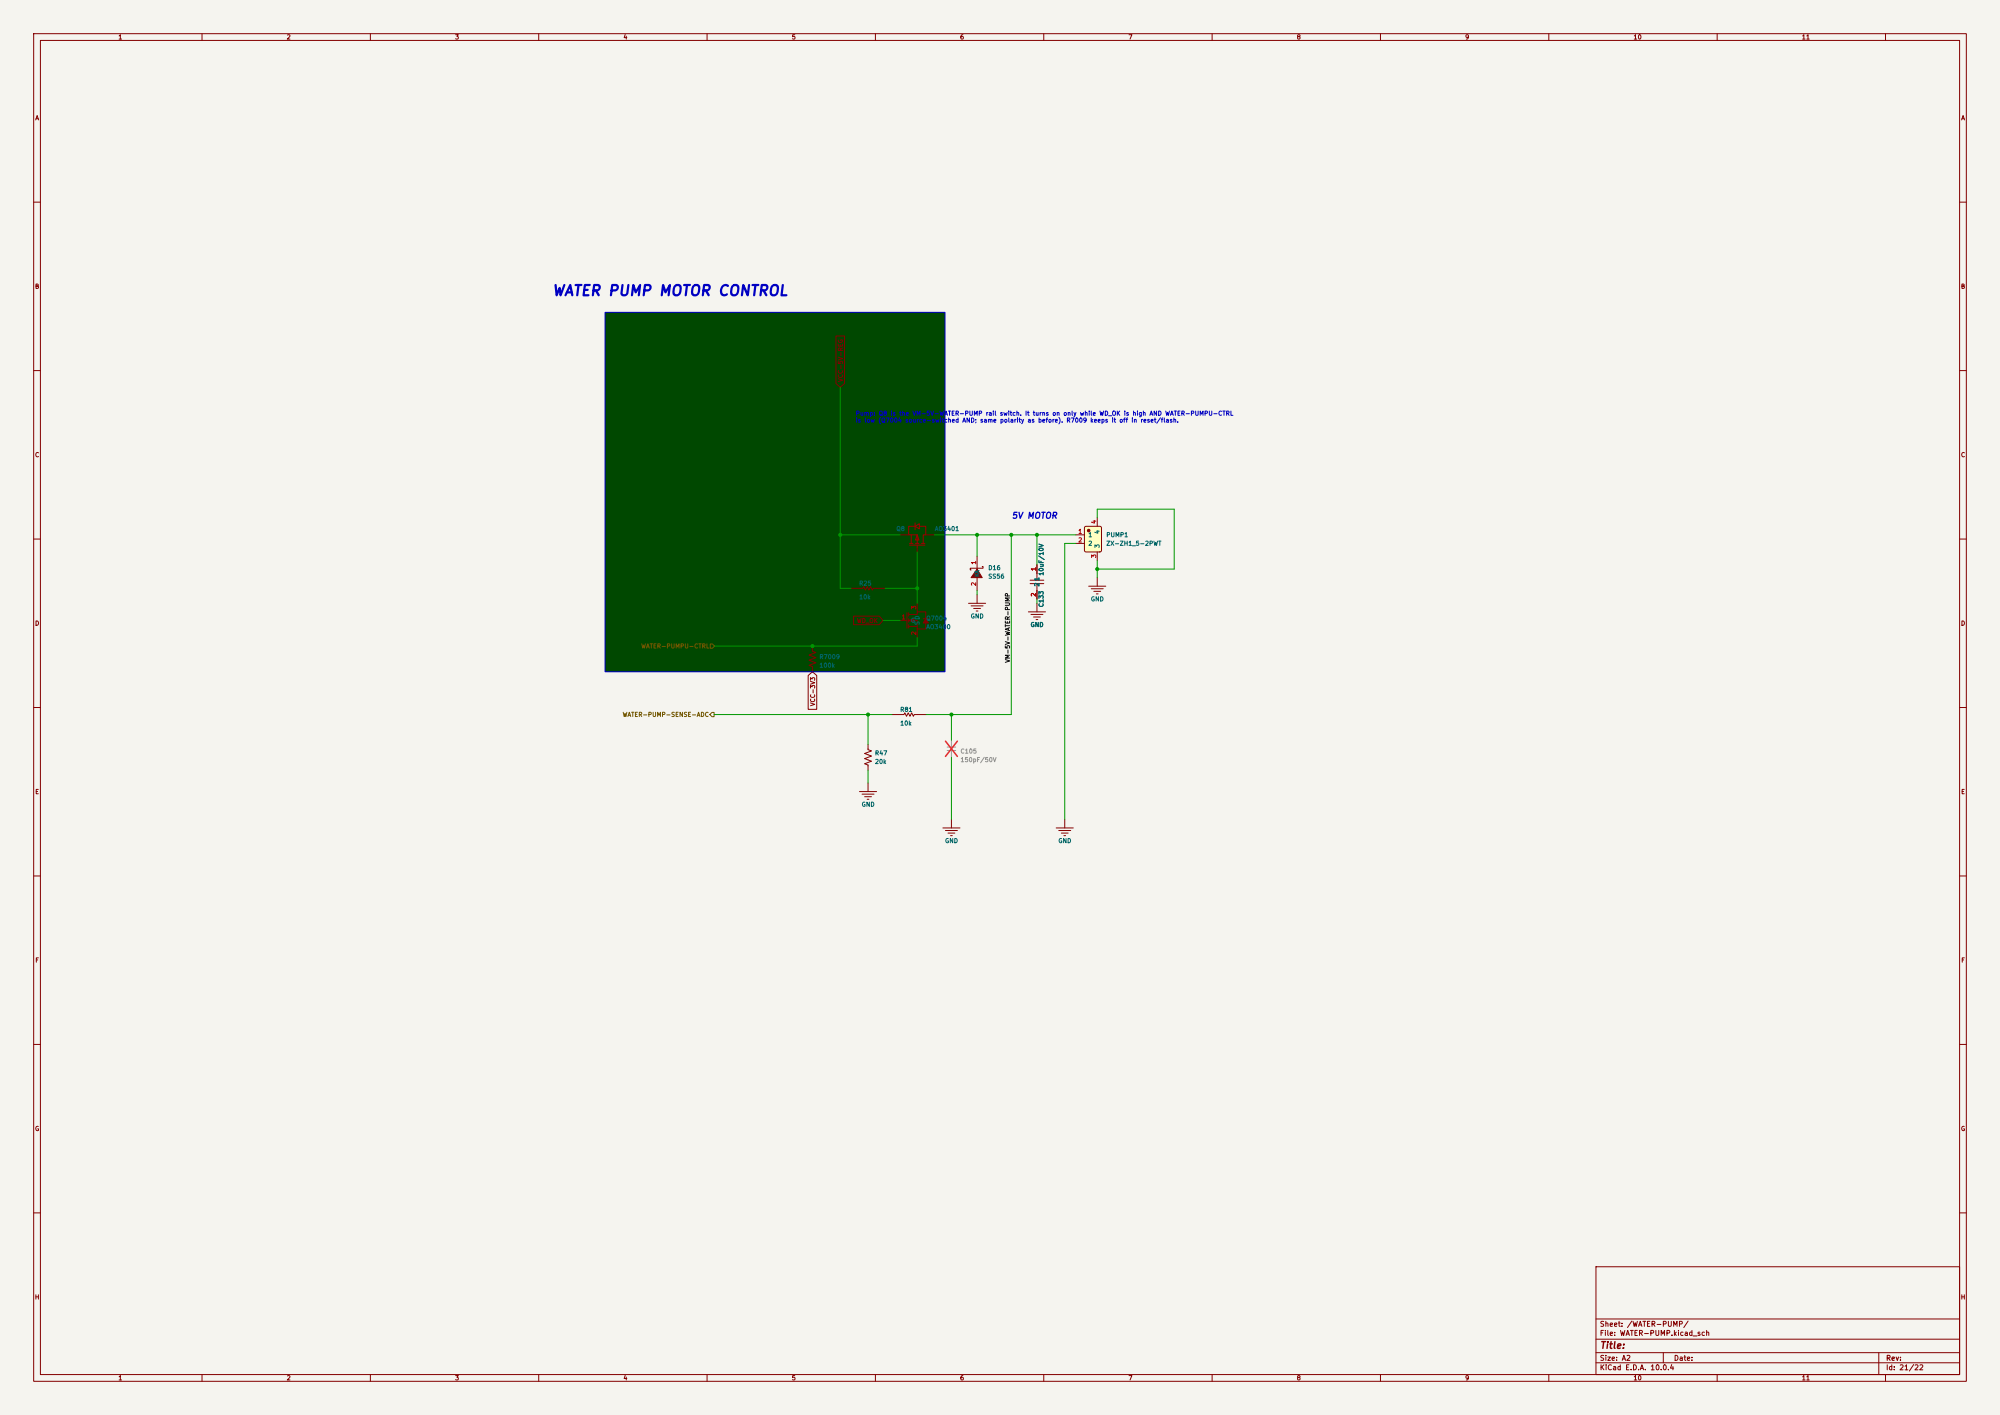
[picture p30: page 9]

WATER PUMP MOTOR CONTROL

Pump: Q8 is the VM-5V-WATER-PUMP rail switch. It turns on only while WD_OK is high AND WATER-PUMPU-CTRL
is low (Q7004 source-switched AND; same polarity as before). R7009 keeps it off in reset/flash. C133 10uF/10V 1

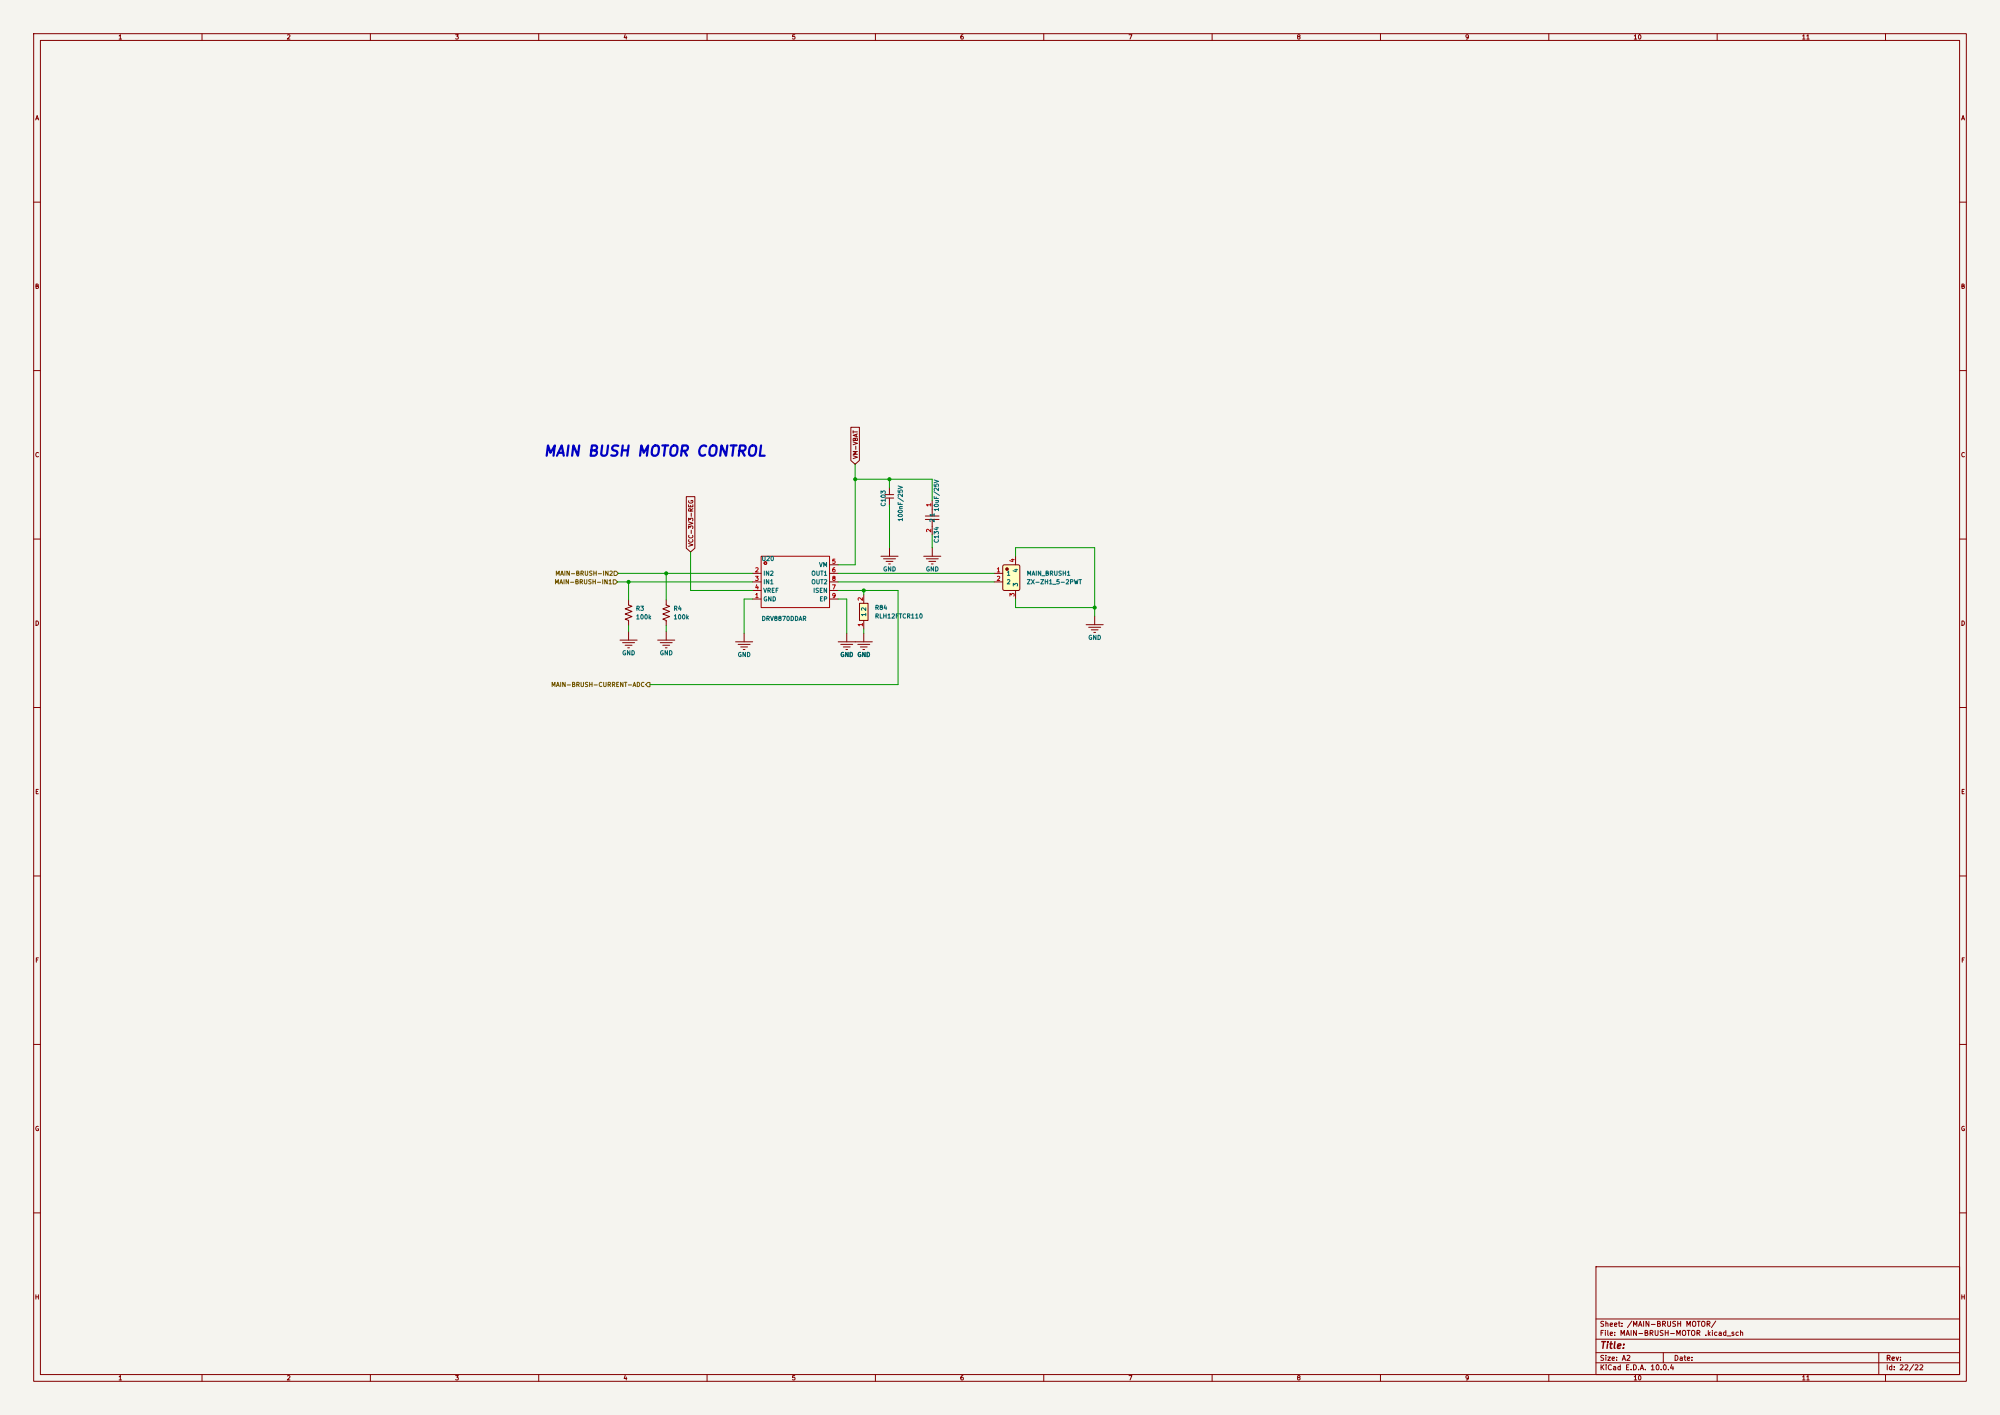
[picture p31: page 10]

4 MAIN_BRUSH1 MAIN-BRUSH-IN1 ZX-ZH1_5-2PWT MAIN-BRUSH-IN2 MAIN-BRUSH-CURRENT-ADC VCC-3V3-REG

Sheet: /MAIN-BRUSH MOTOR/
File: MAIN-BRUSH-MOTOR .kicad_sch

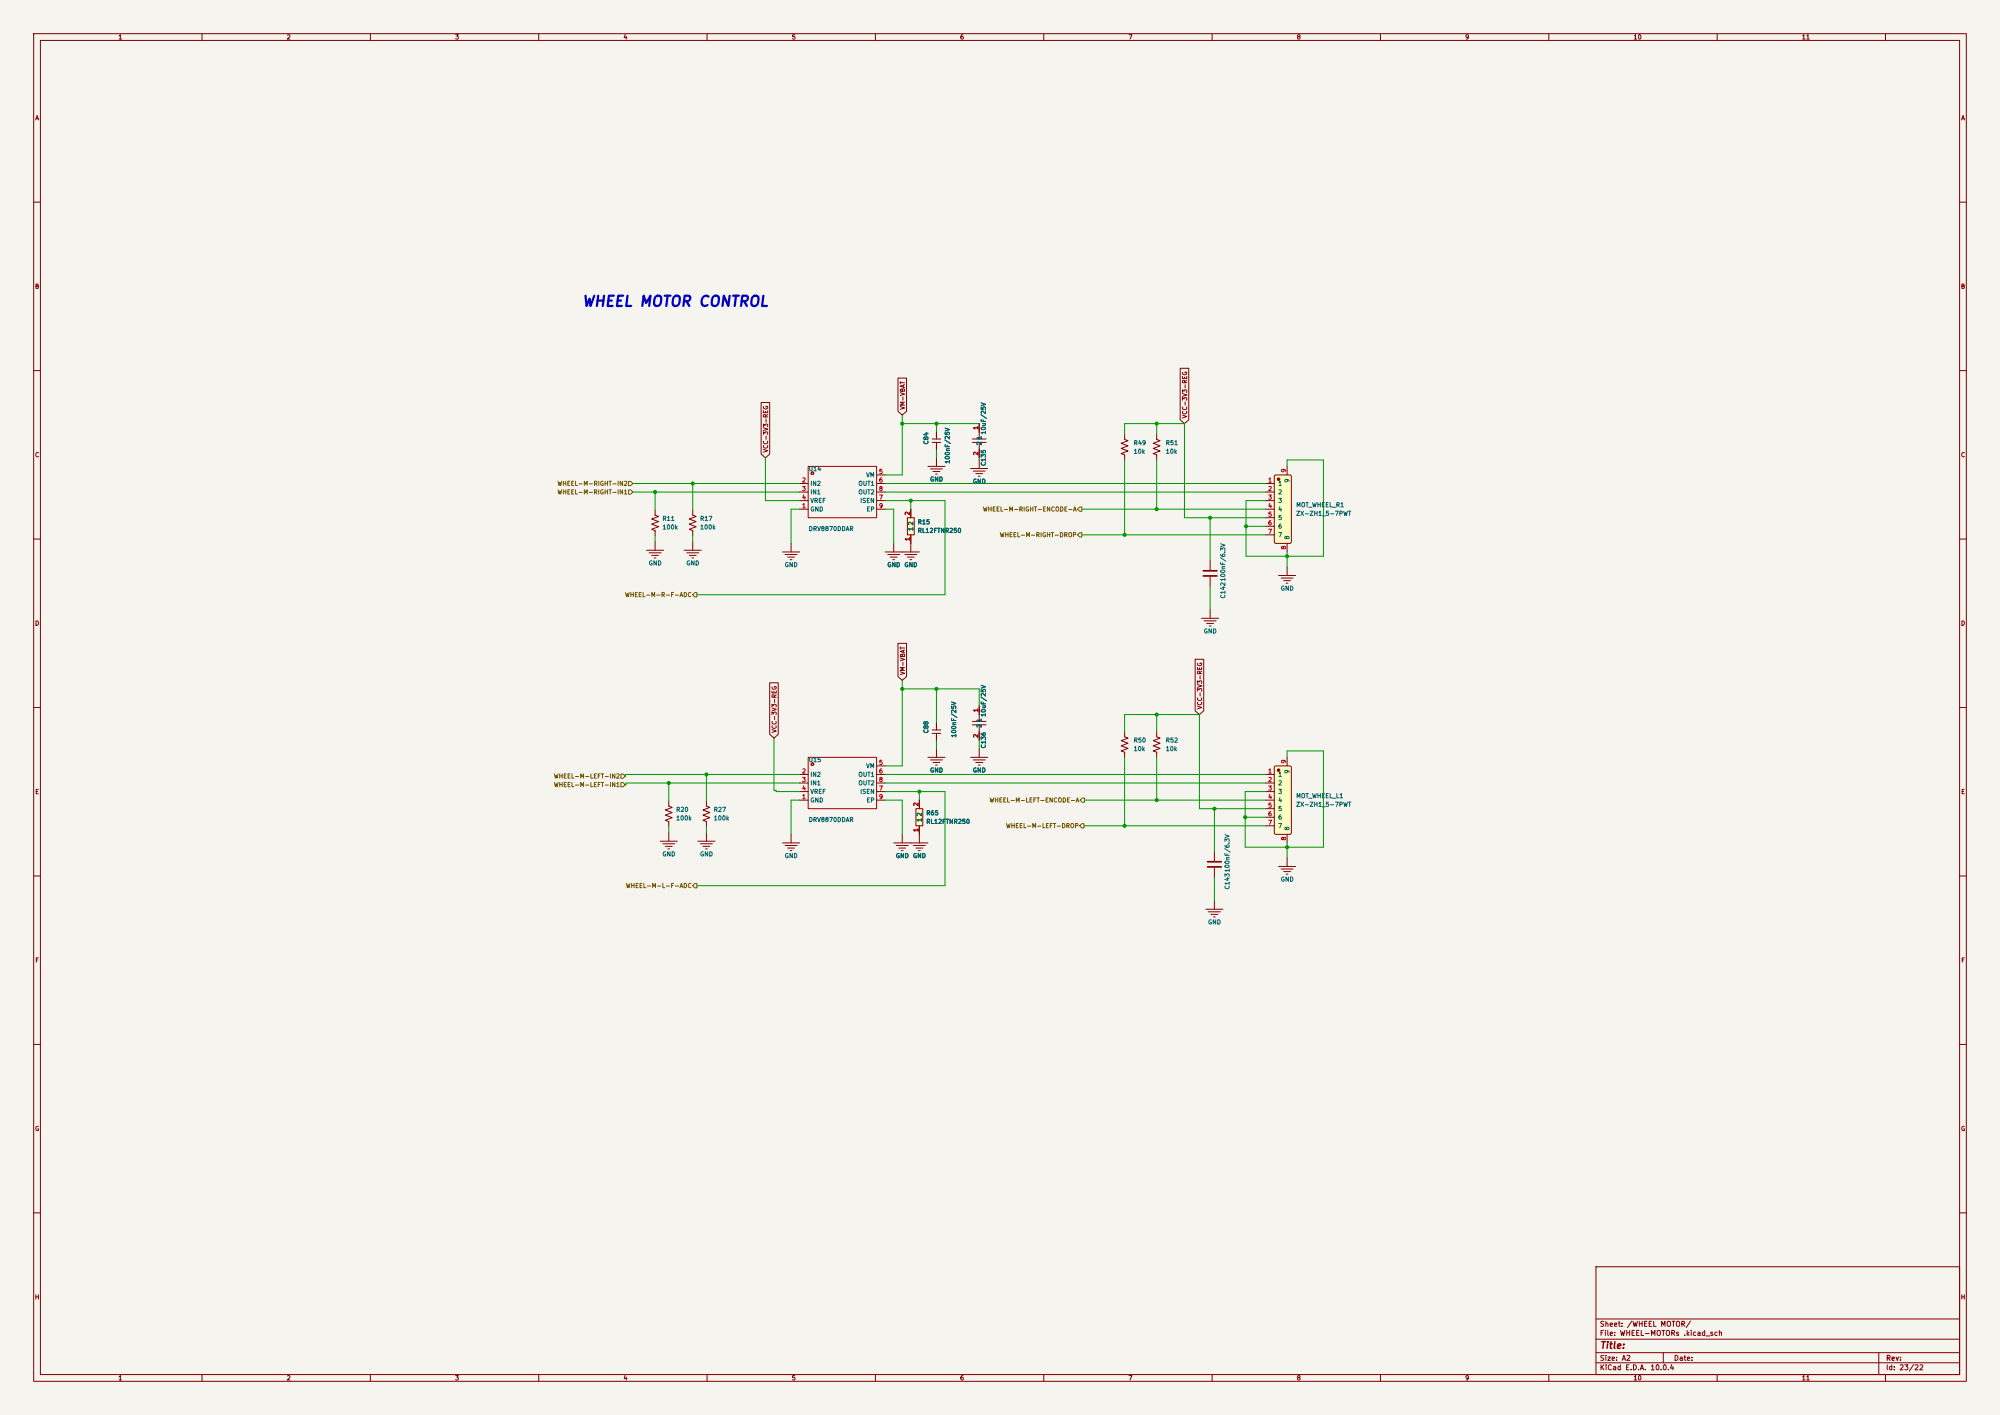
[picture p32: page 11]

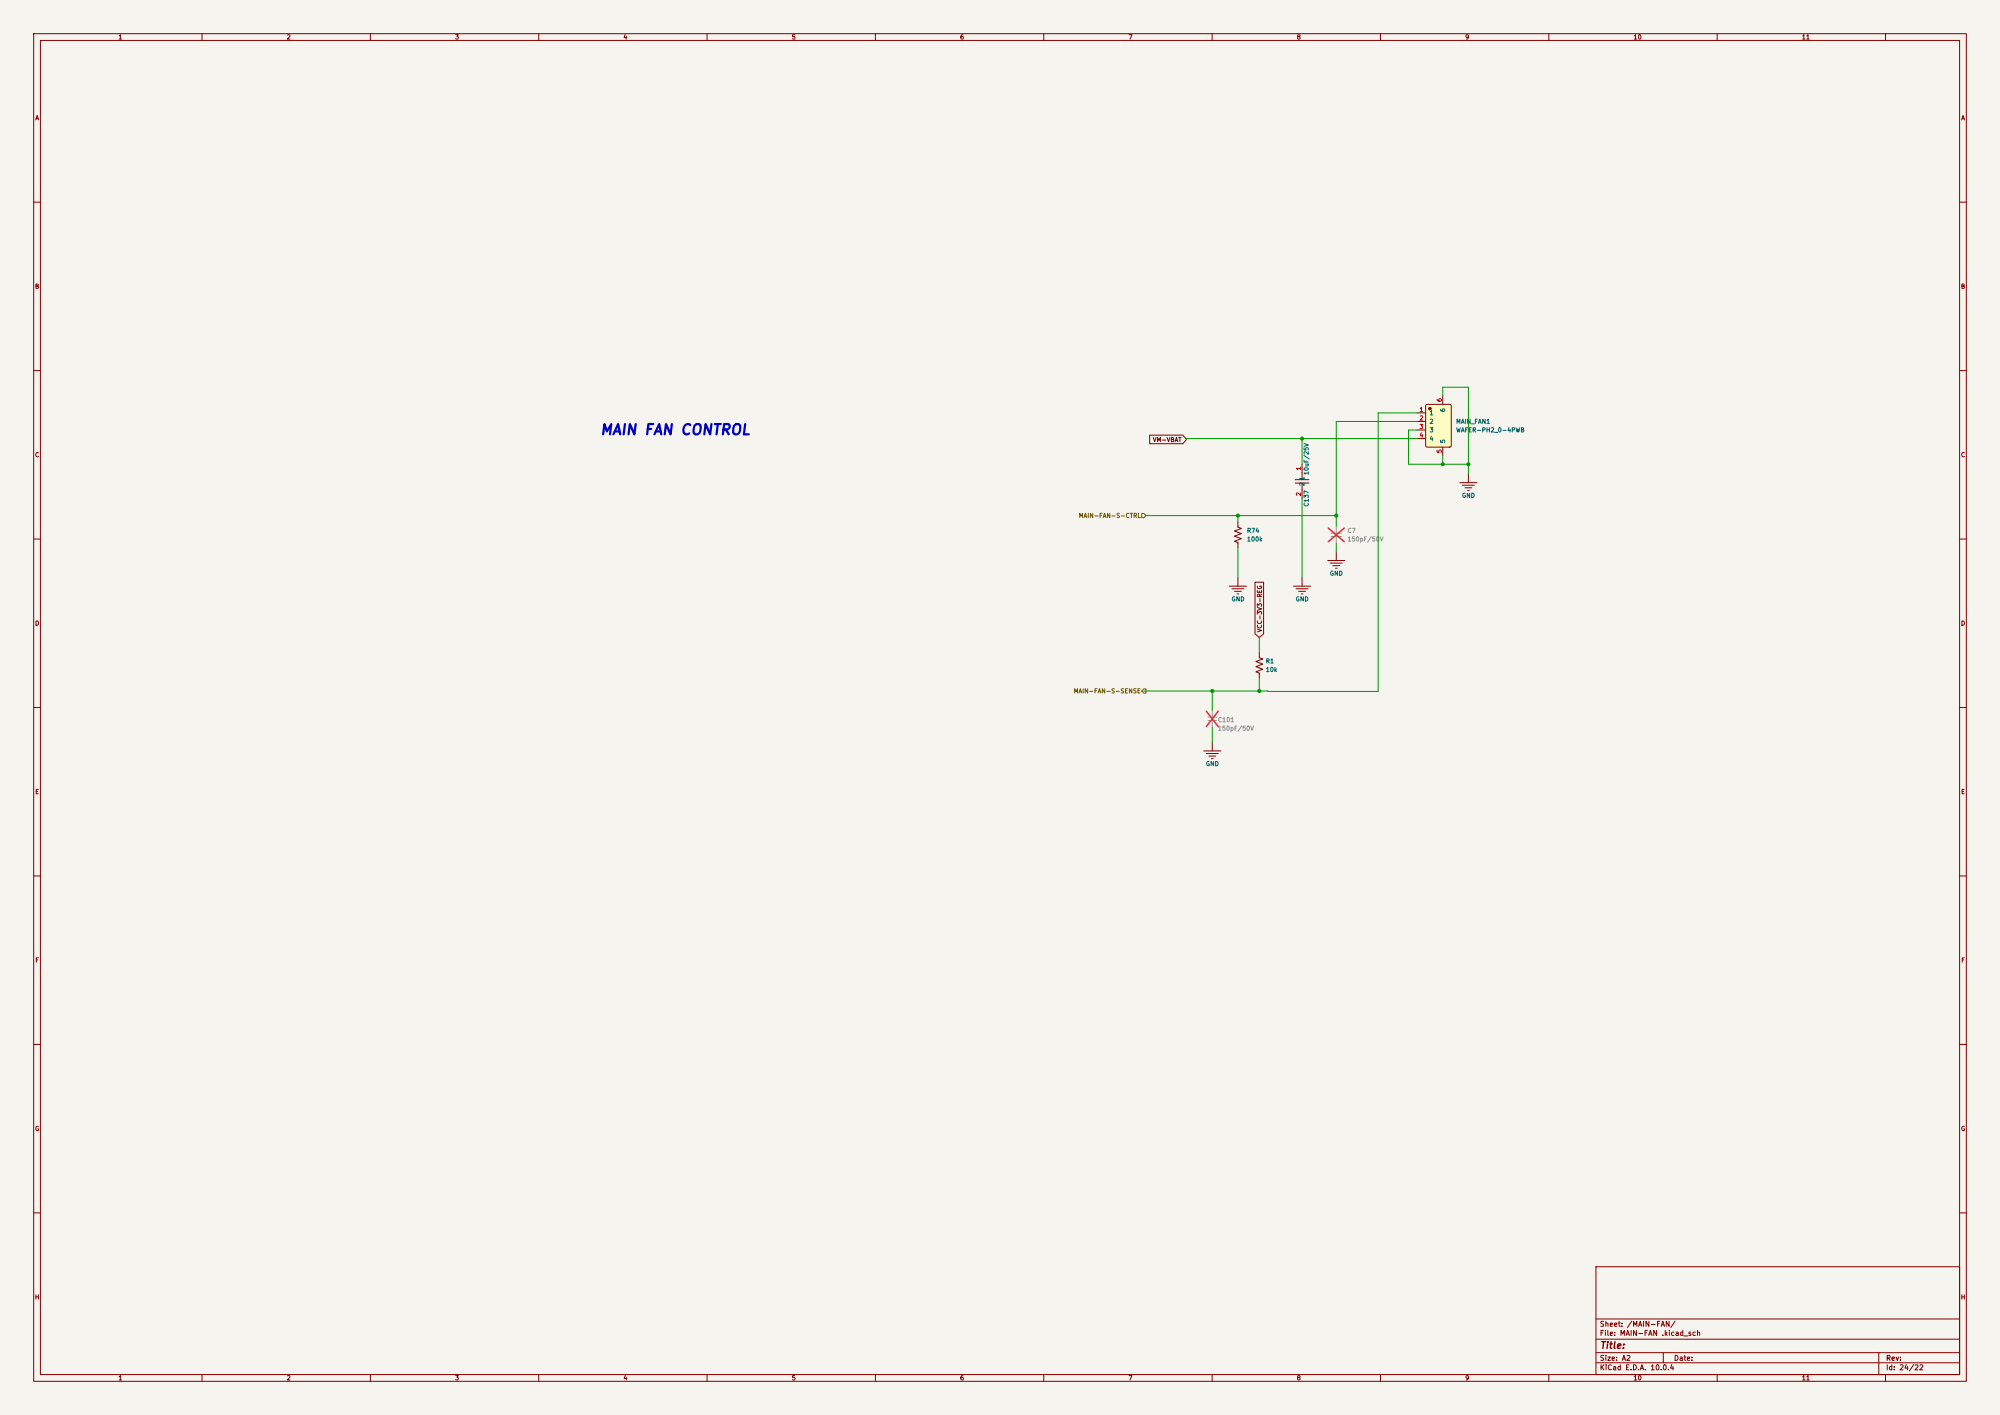
[picture p33: page 12]

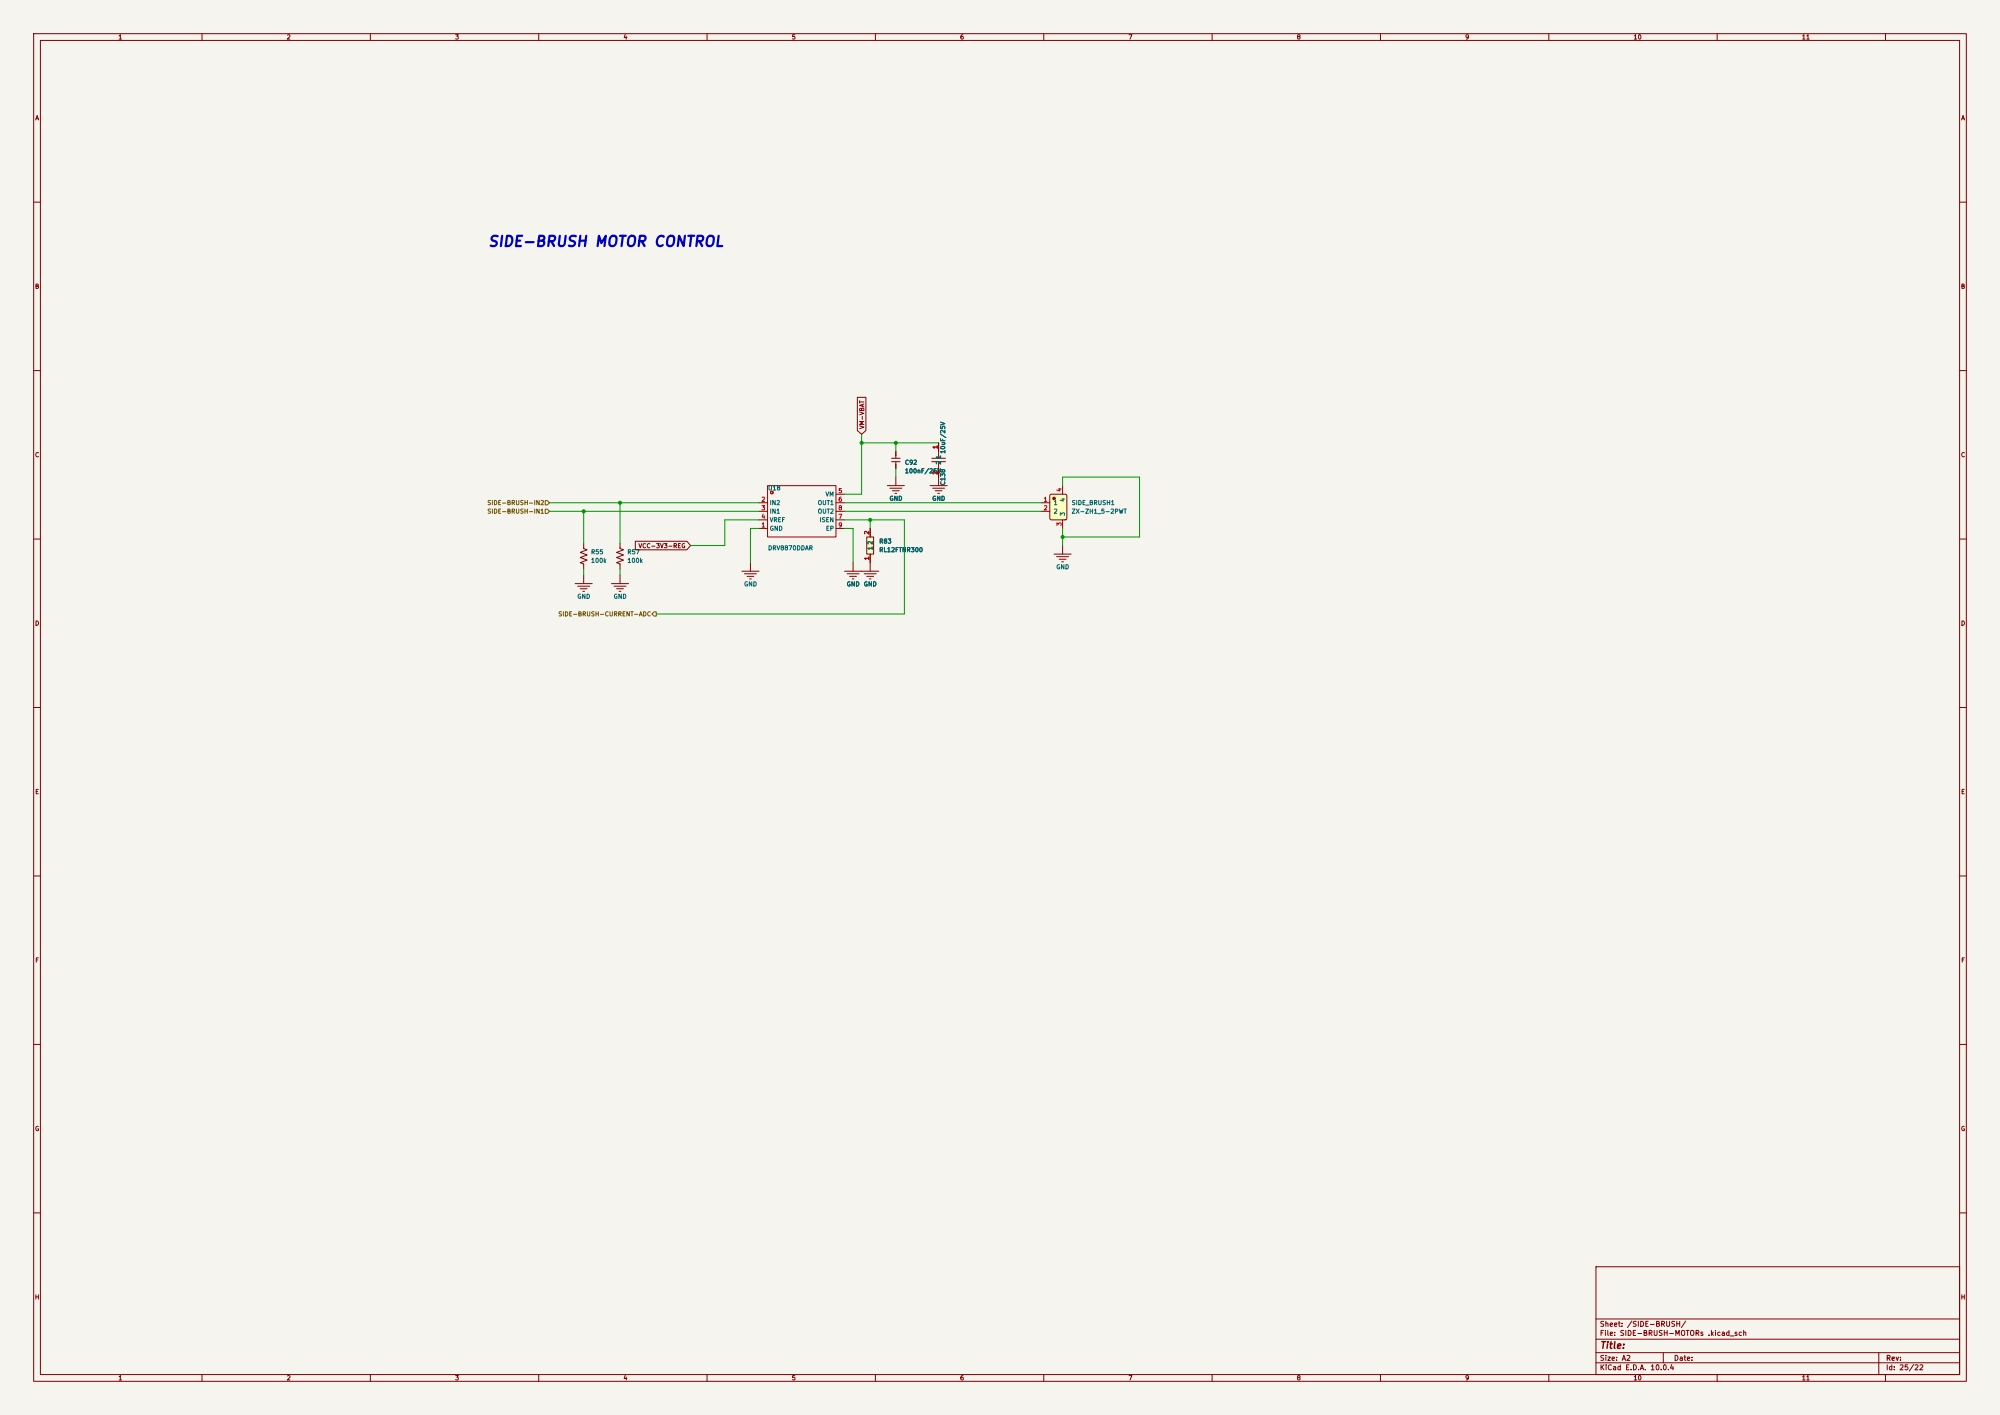
[picture p34: page 13]

SIDE-BRUSH MOTOR CONTROL

2 C138 10uF/25V GND GND SIDE-BRUSH-IN2

SIDE-BRUSH-CURRENT-ADC

Sheet: /SIDE-BRUSH/
File: SIDE-BRUSH-MOTORs .kicad_sch

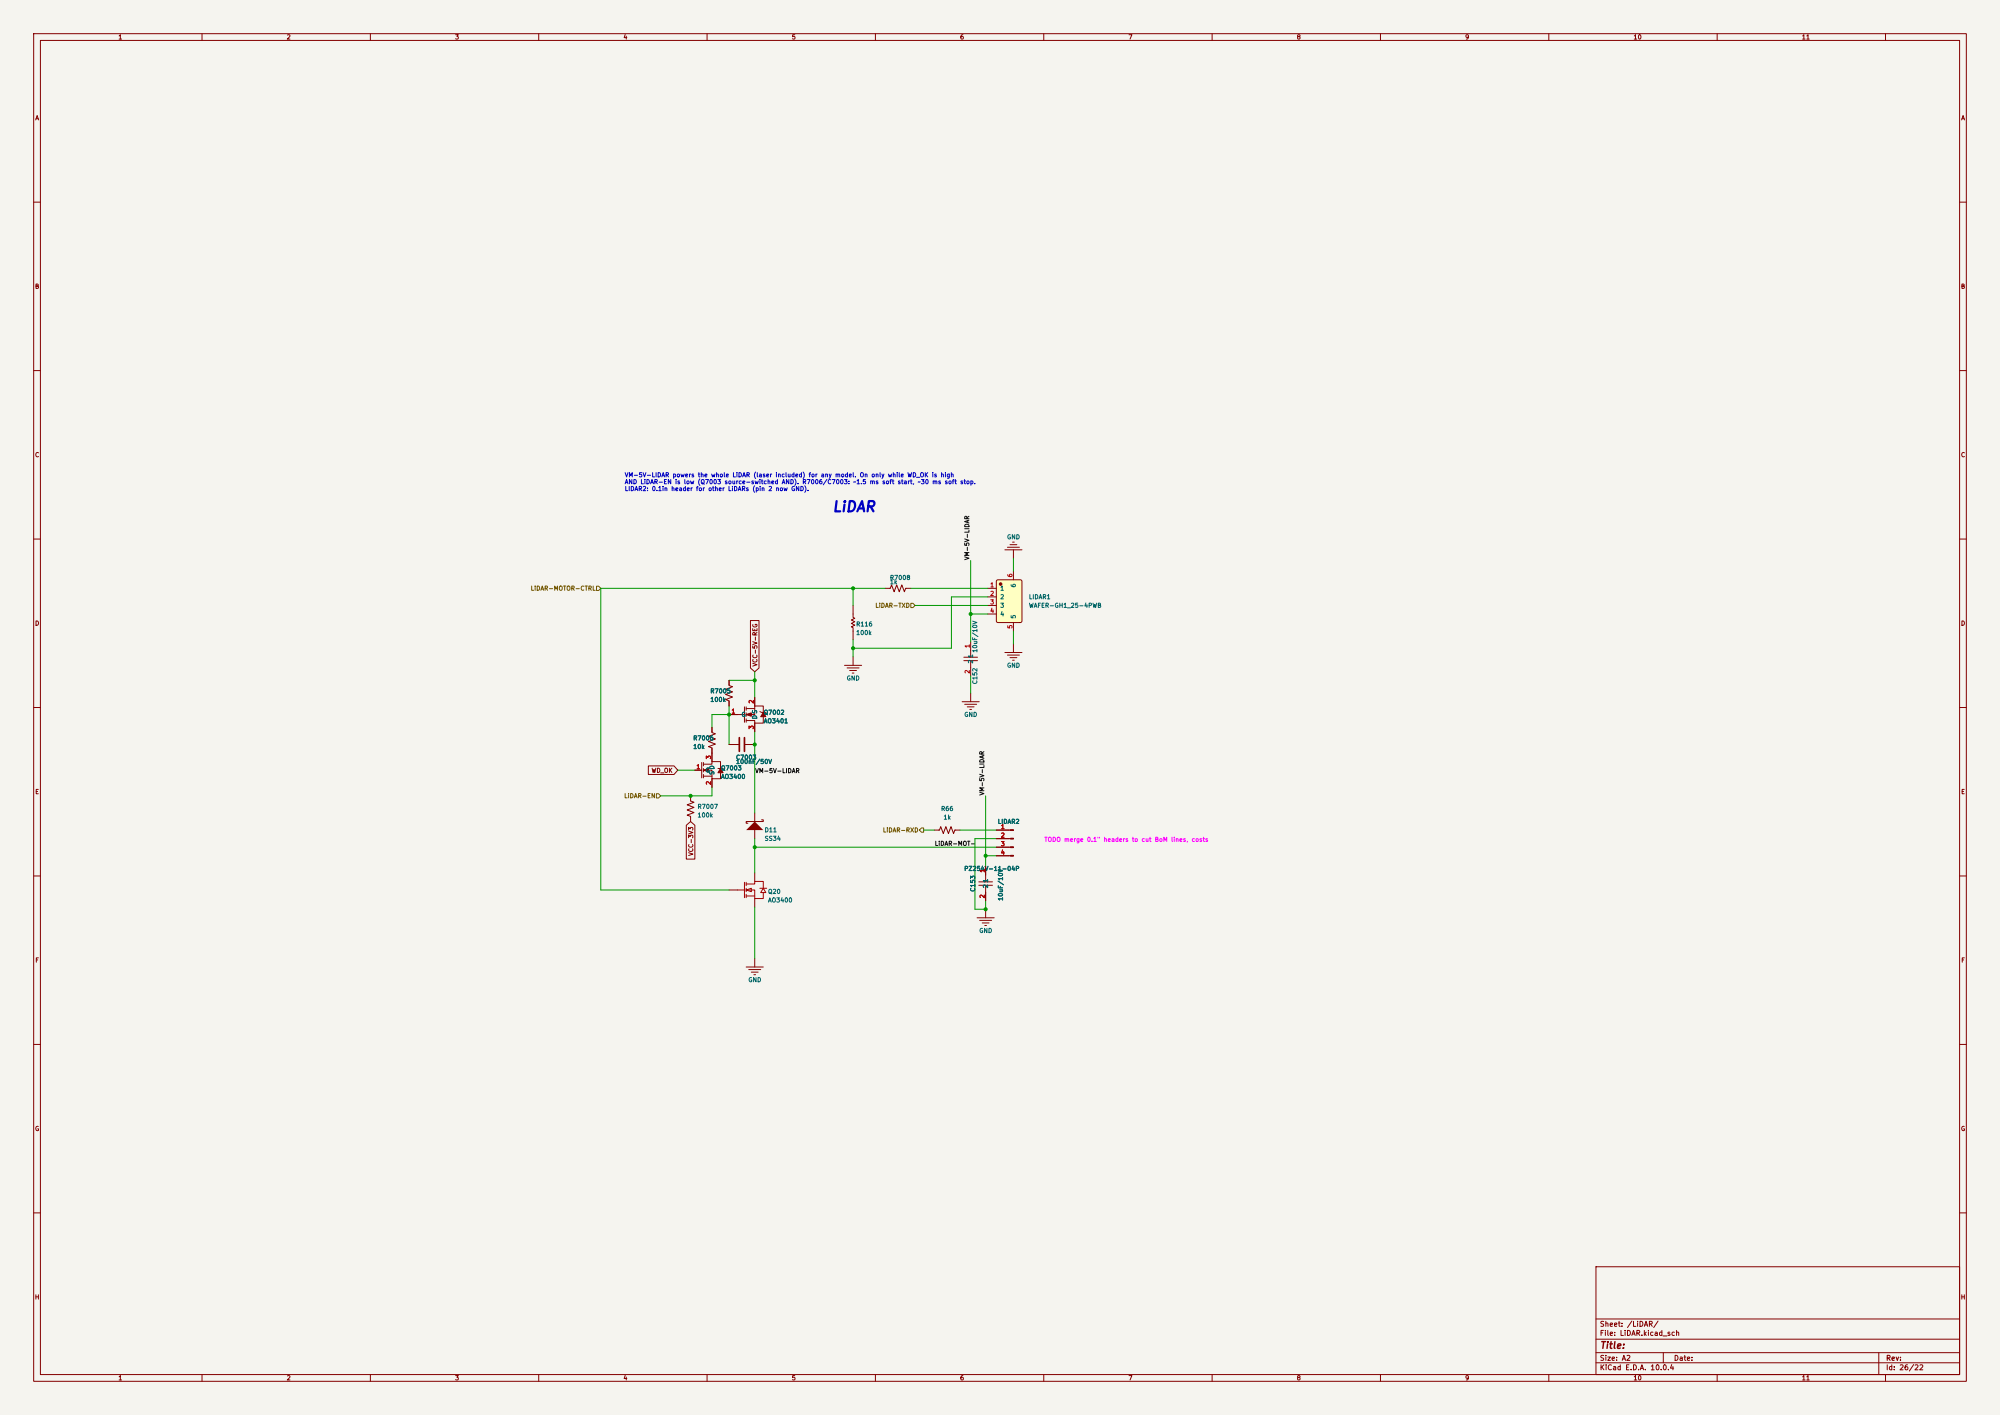
[picture p35: page 14]

VM-5V-LIDAR powers the whole LiDAR (laser included) for any model. On only while WD_OK is high

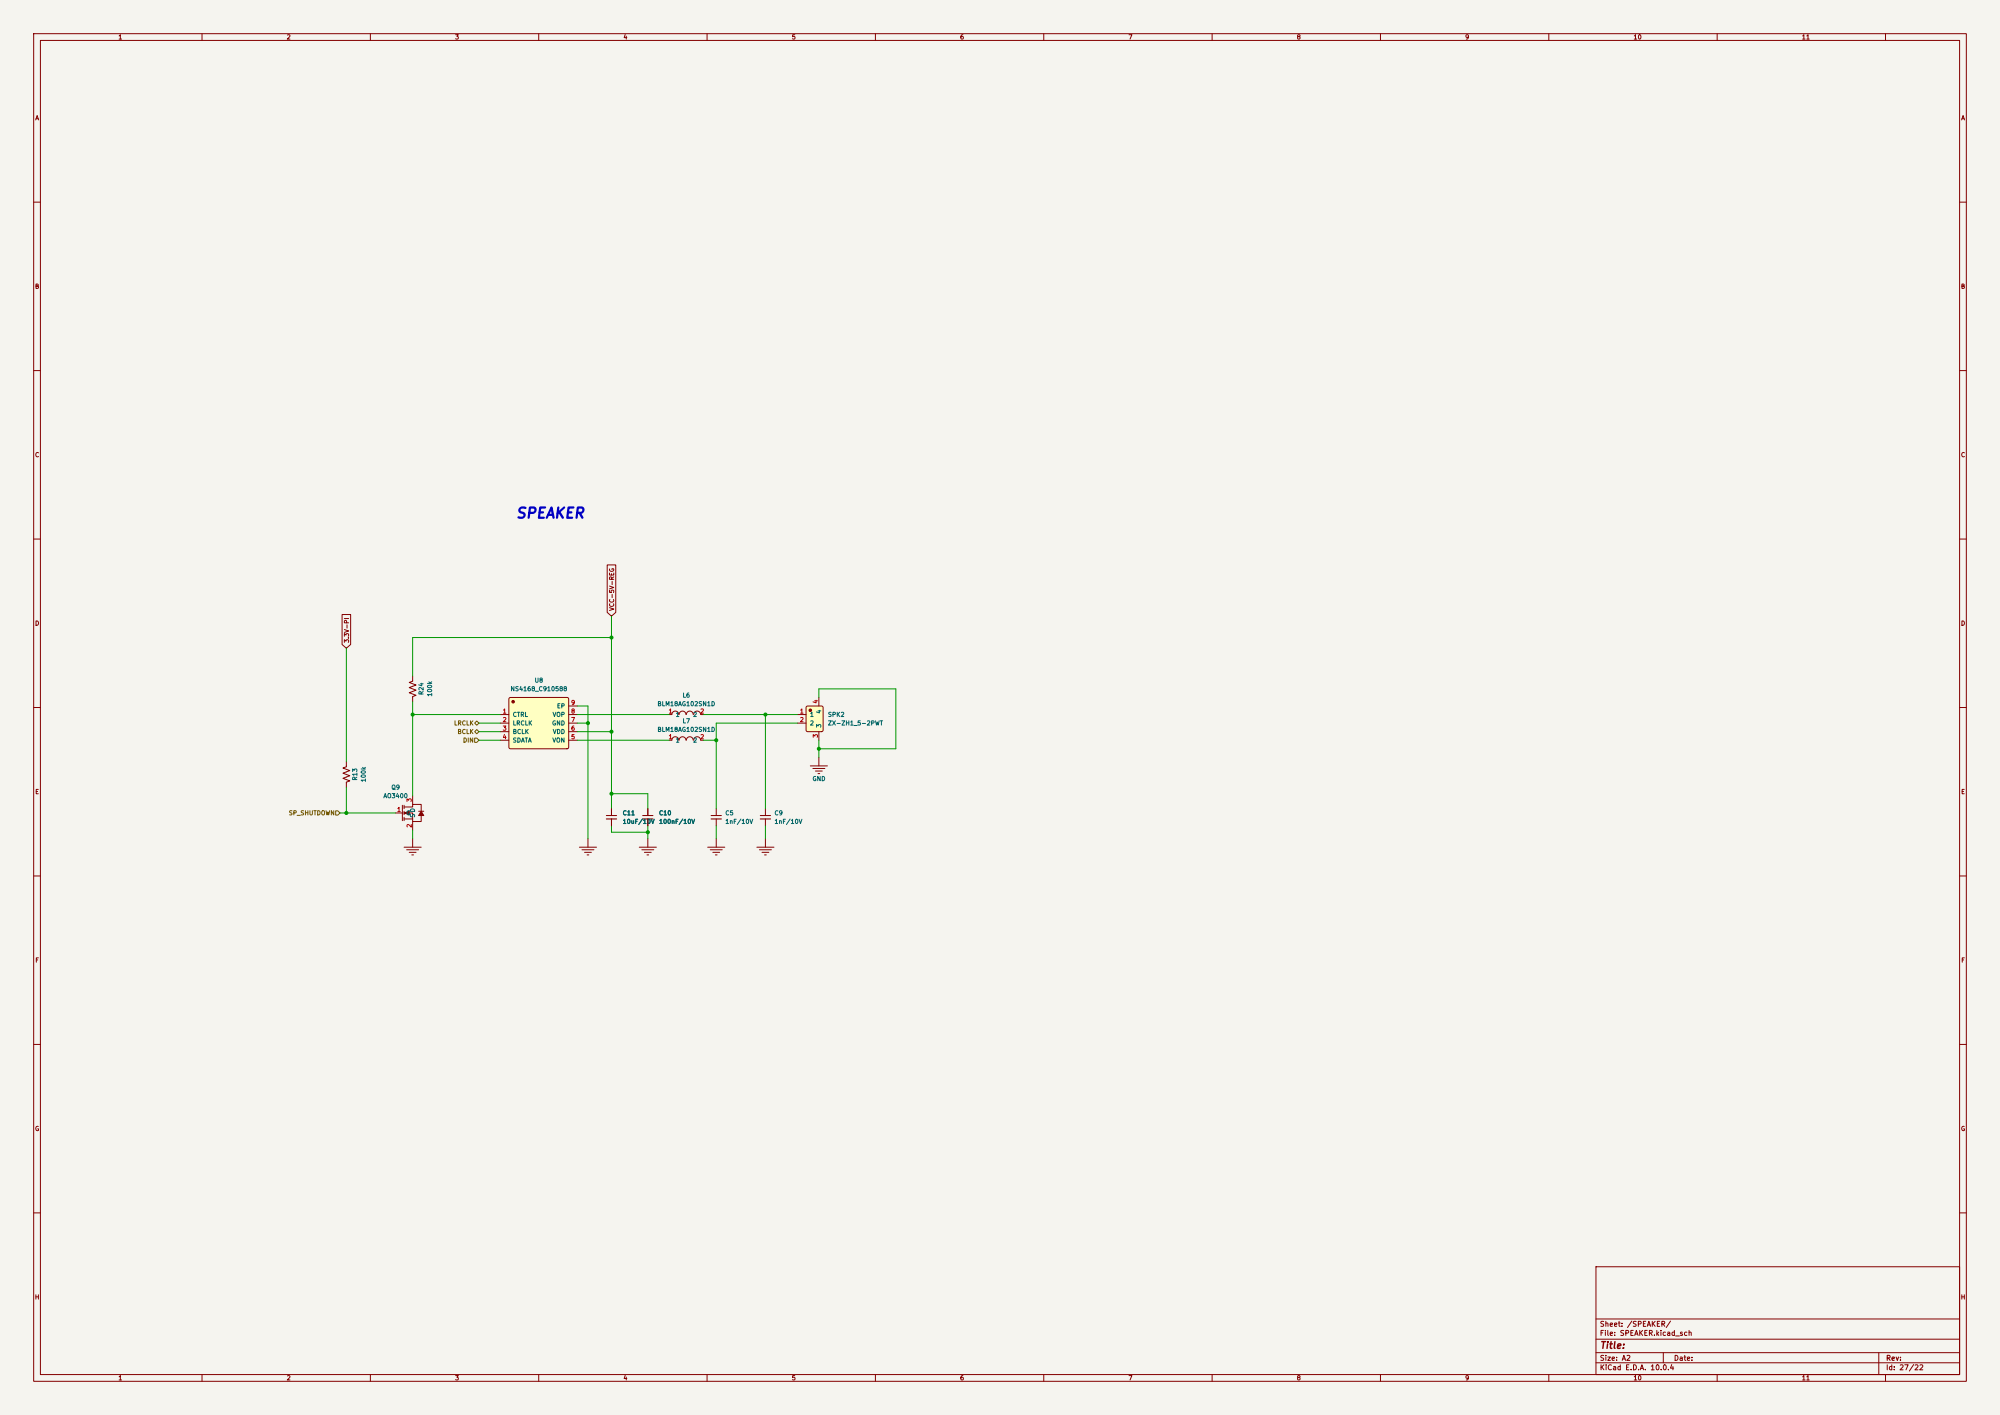
[picture p36: page 15]

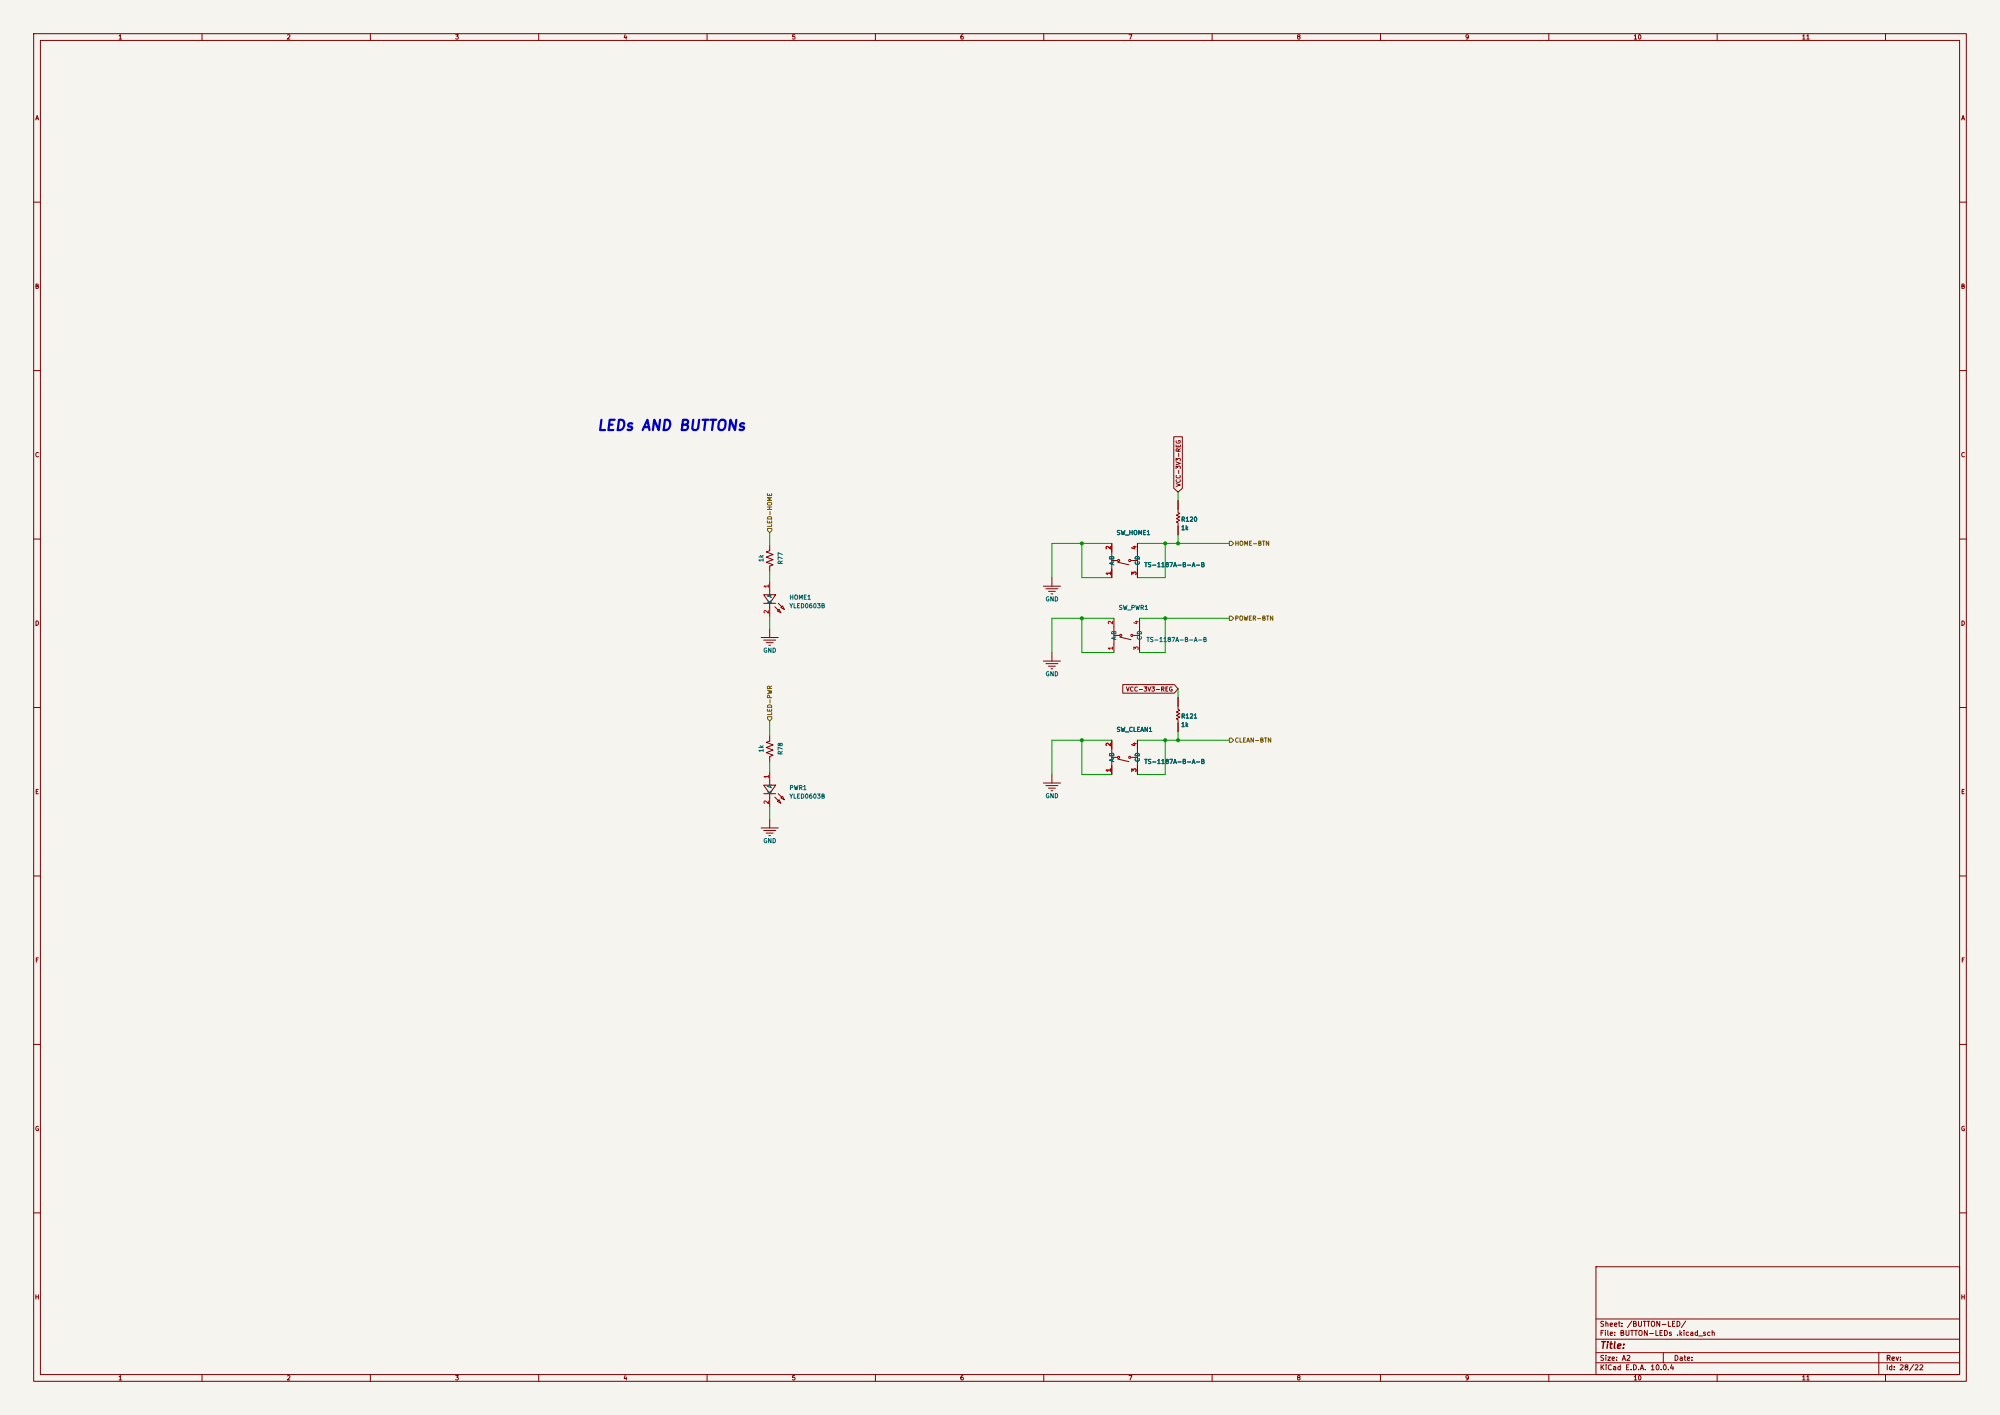
[picture p37: page 16]

VCC-3V3-REG LEDs AND BUTTONs

HOME-BTN VCC-3V3-REG

CLEAN-BTN LED-HOME

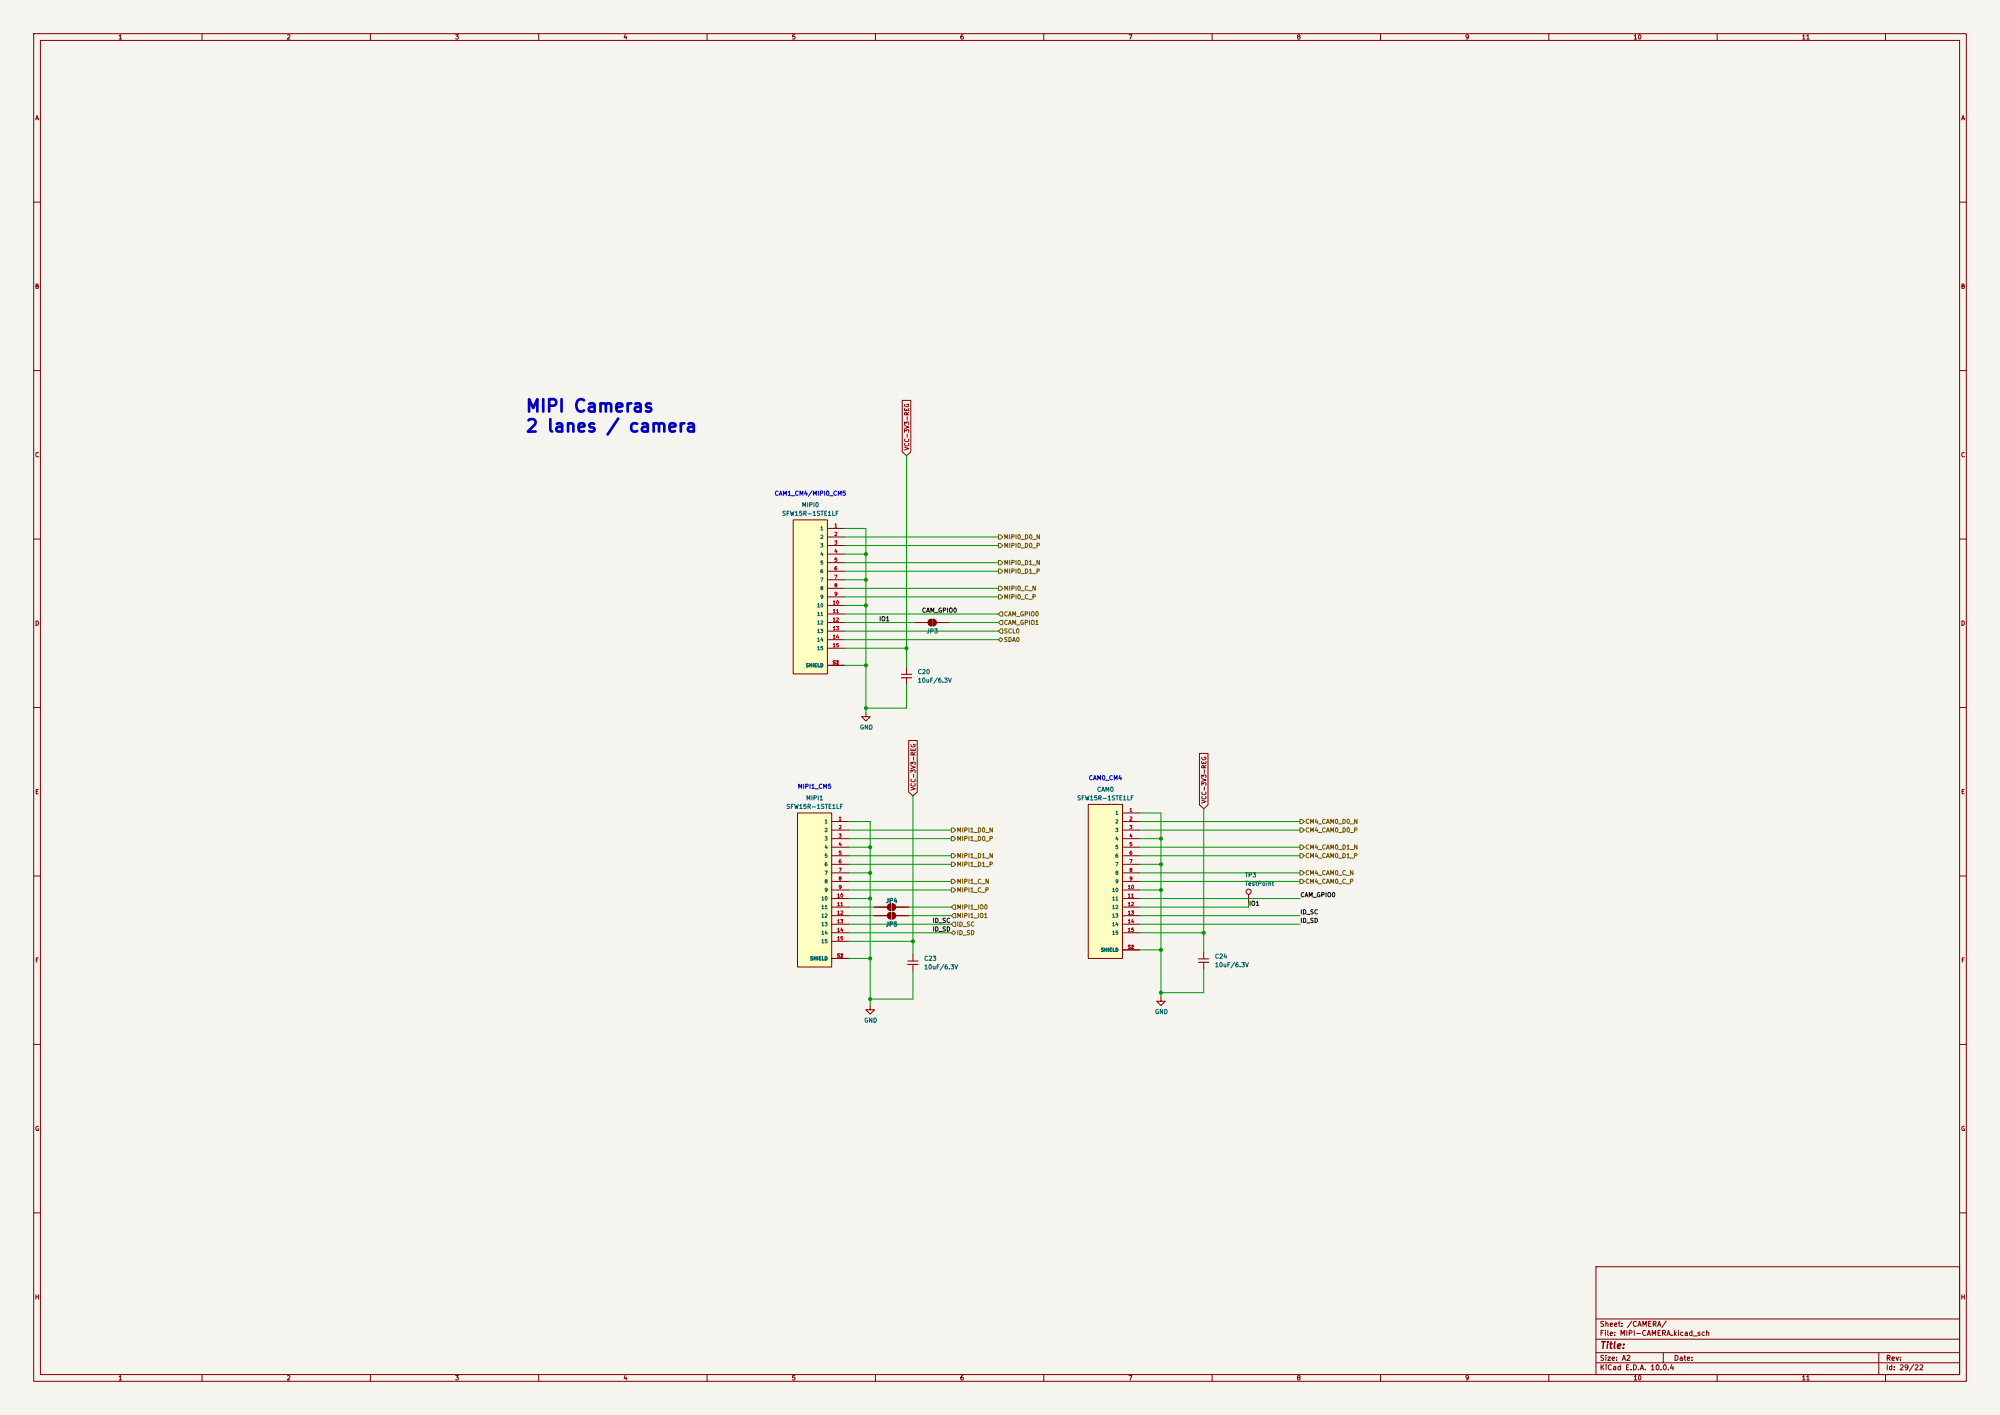
[picture p38: page 17]

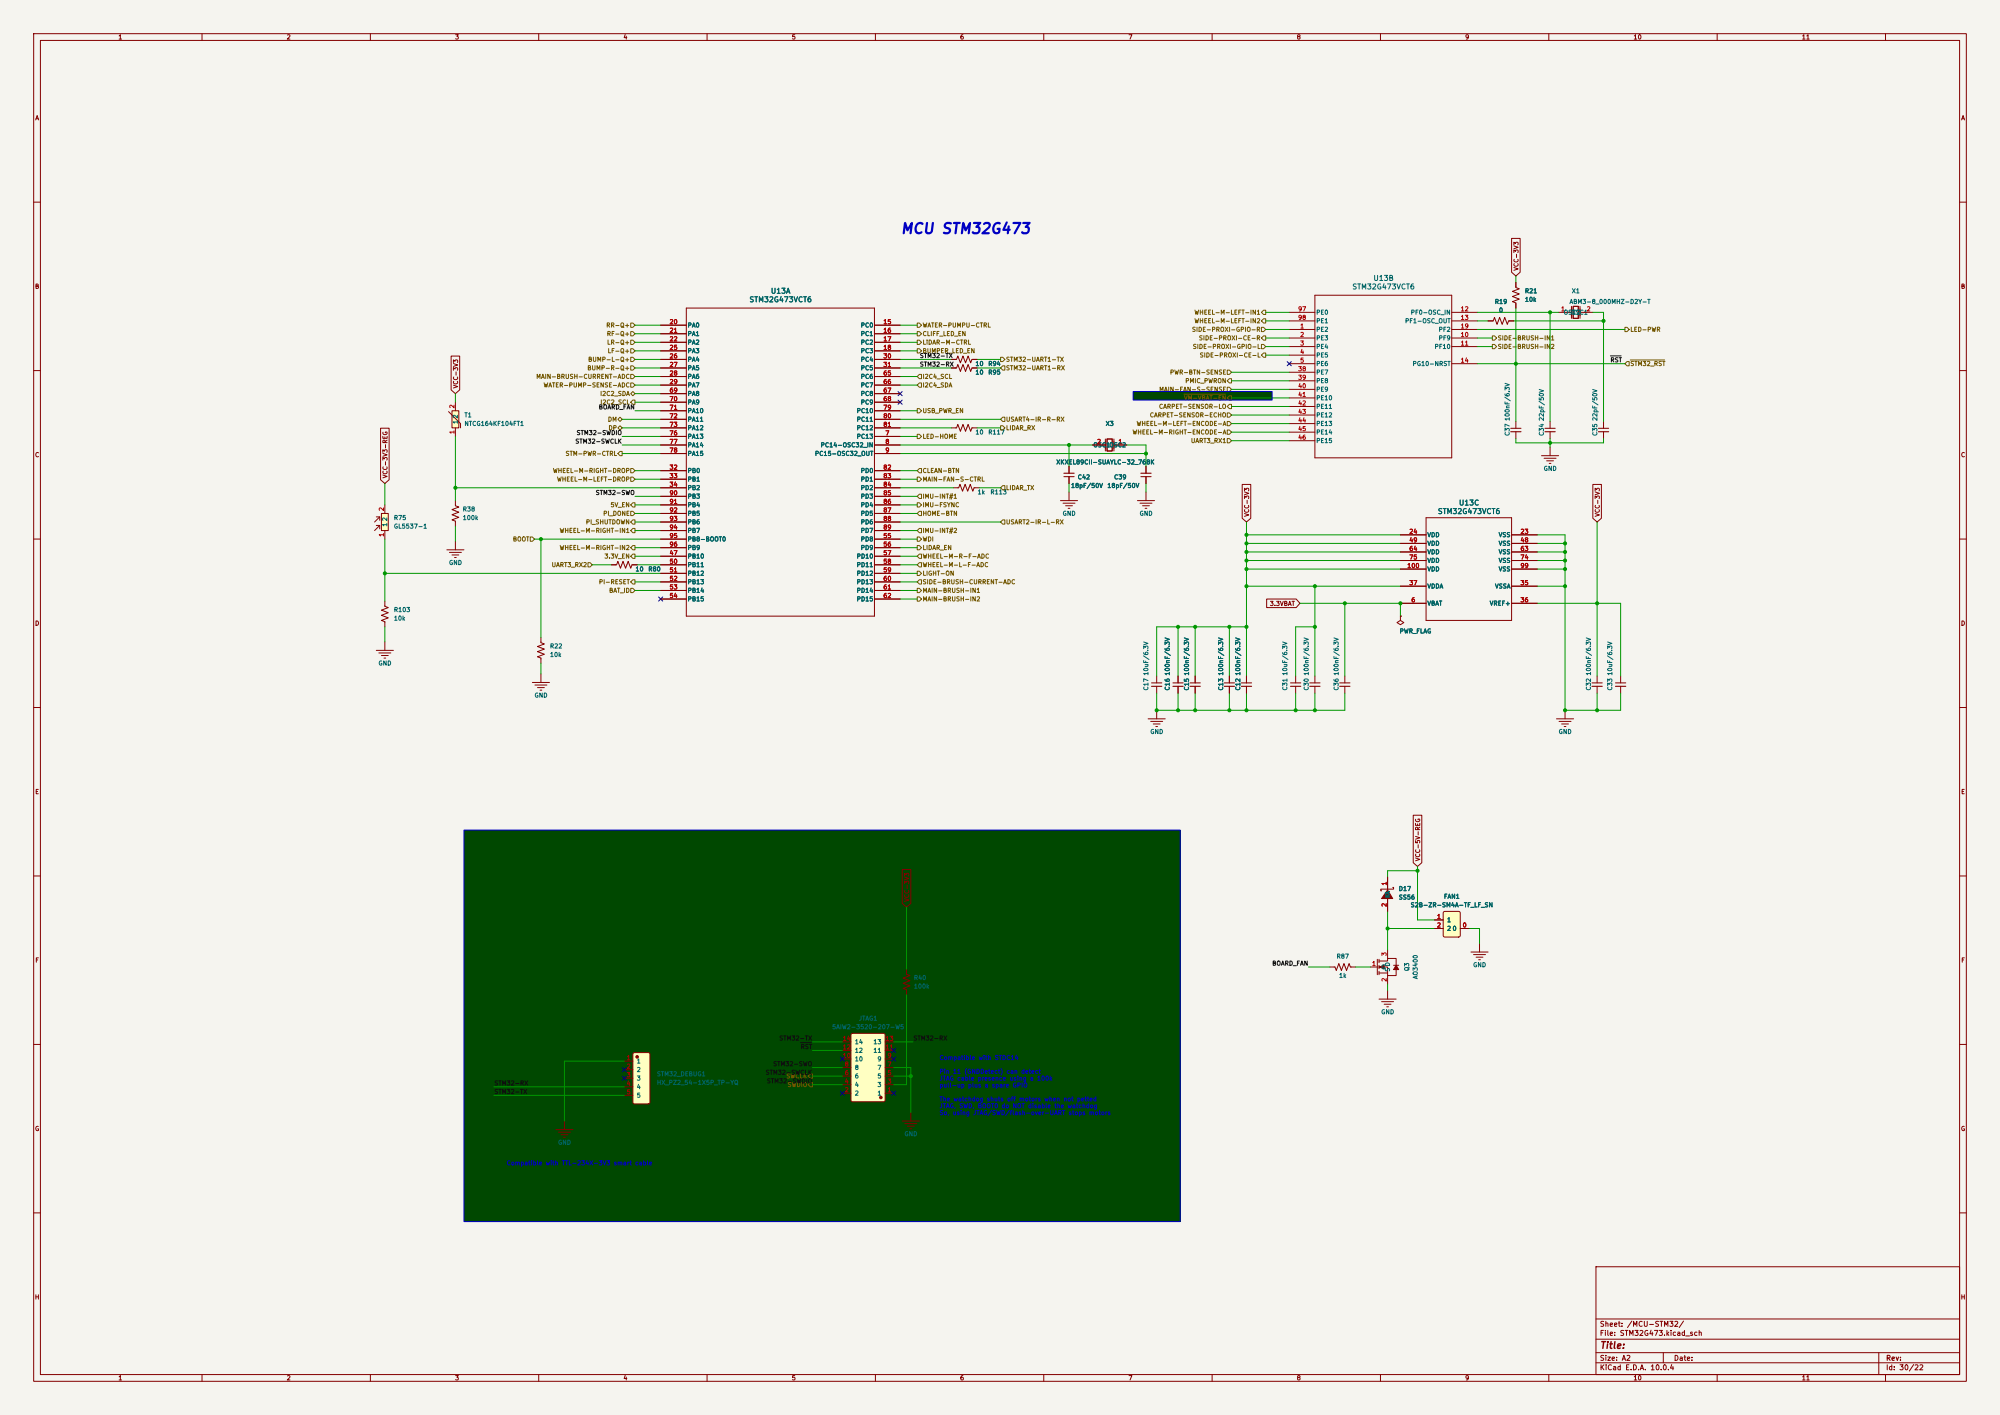
[picture p39: page 18]

SIDE-BRUSH-IN1 USART4-IR-R-RX

LiDAR-M-CTRL
SIDE-PROXI-GPIO-L SIDE-PROXI-CE-L BUMPER_LED_EN
STM32-TX
STM32-RX

UART3_RX1 PWR-BTN-SENSE MAIN-FAN-S-SENSE CARPET-SENSOR-LO

CARPET-SENSOR-ECHO WHEEL-M-LEFT-ENCODE-A

CLEAN-BTN
IMU-INT#1 MAIN-FAN-S-CTRL

IMU-FSYNC
IMU-INT#2 HOME-BTN

LIDAR_EN WHEEL-M-L-F-ADC
LIGHT-ON WHEEL-M-R-F-ADC

49 49 | 48 48
64 64 | 63 63
75 75 | 74 74

SIDE-BRUSH-CURRENT-ADC

Compatible with STDC14 Pin 11 (GNDDetect) can detect JTAG cable presence using a 100k pull-up plus a spare GPIO

The watchdog shuts off motors when not petted
JTAG, SWD, BOOT0 do NOT disable the watchdog
So, using JTAG/SWD/flash-over-UART stops motors

Compatible with TTL-234X-3V3 smart cable

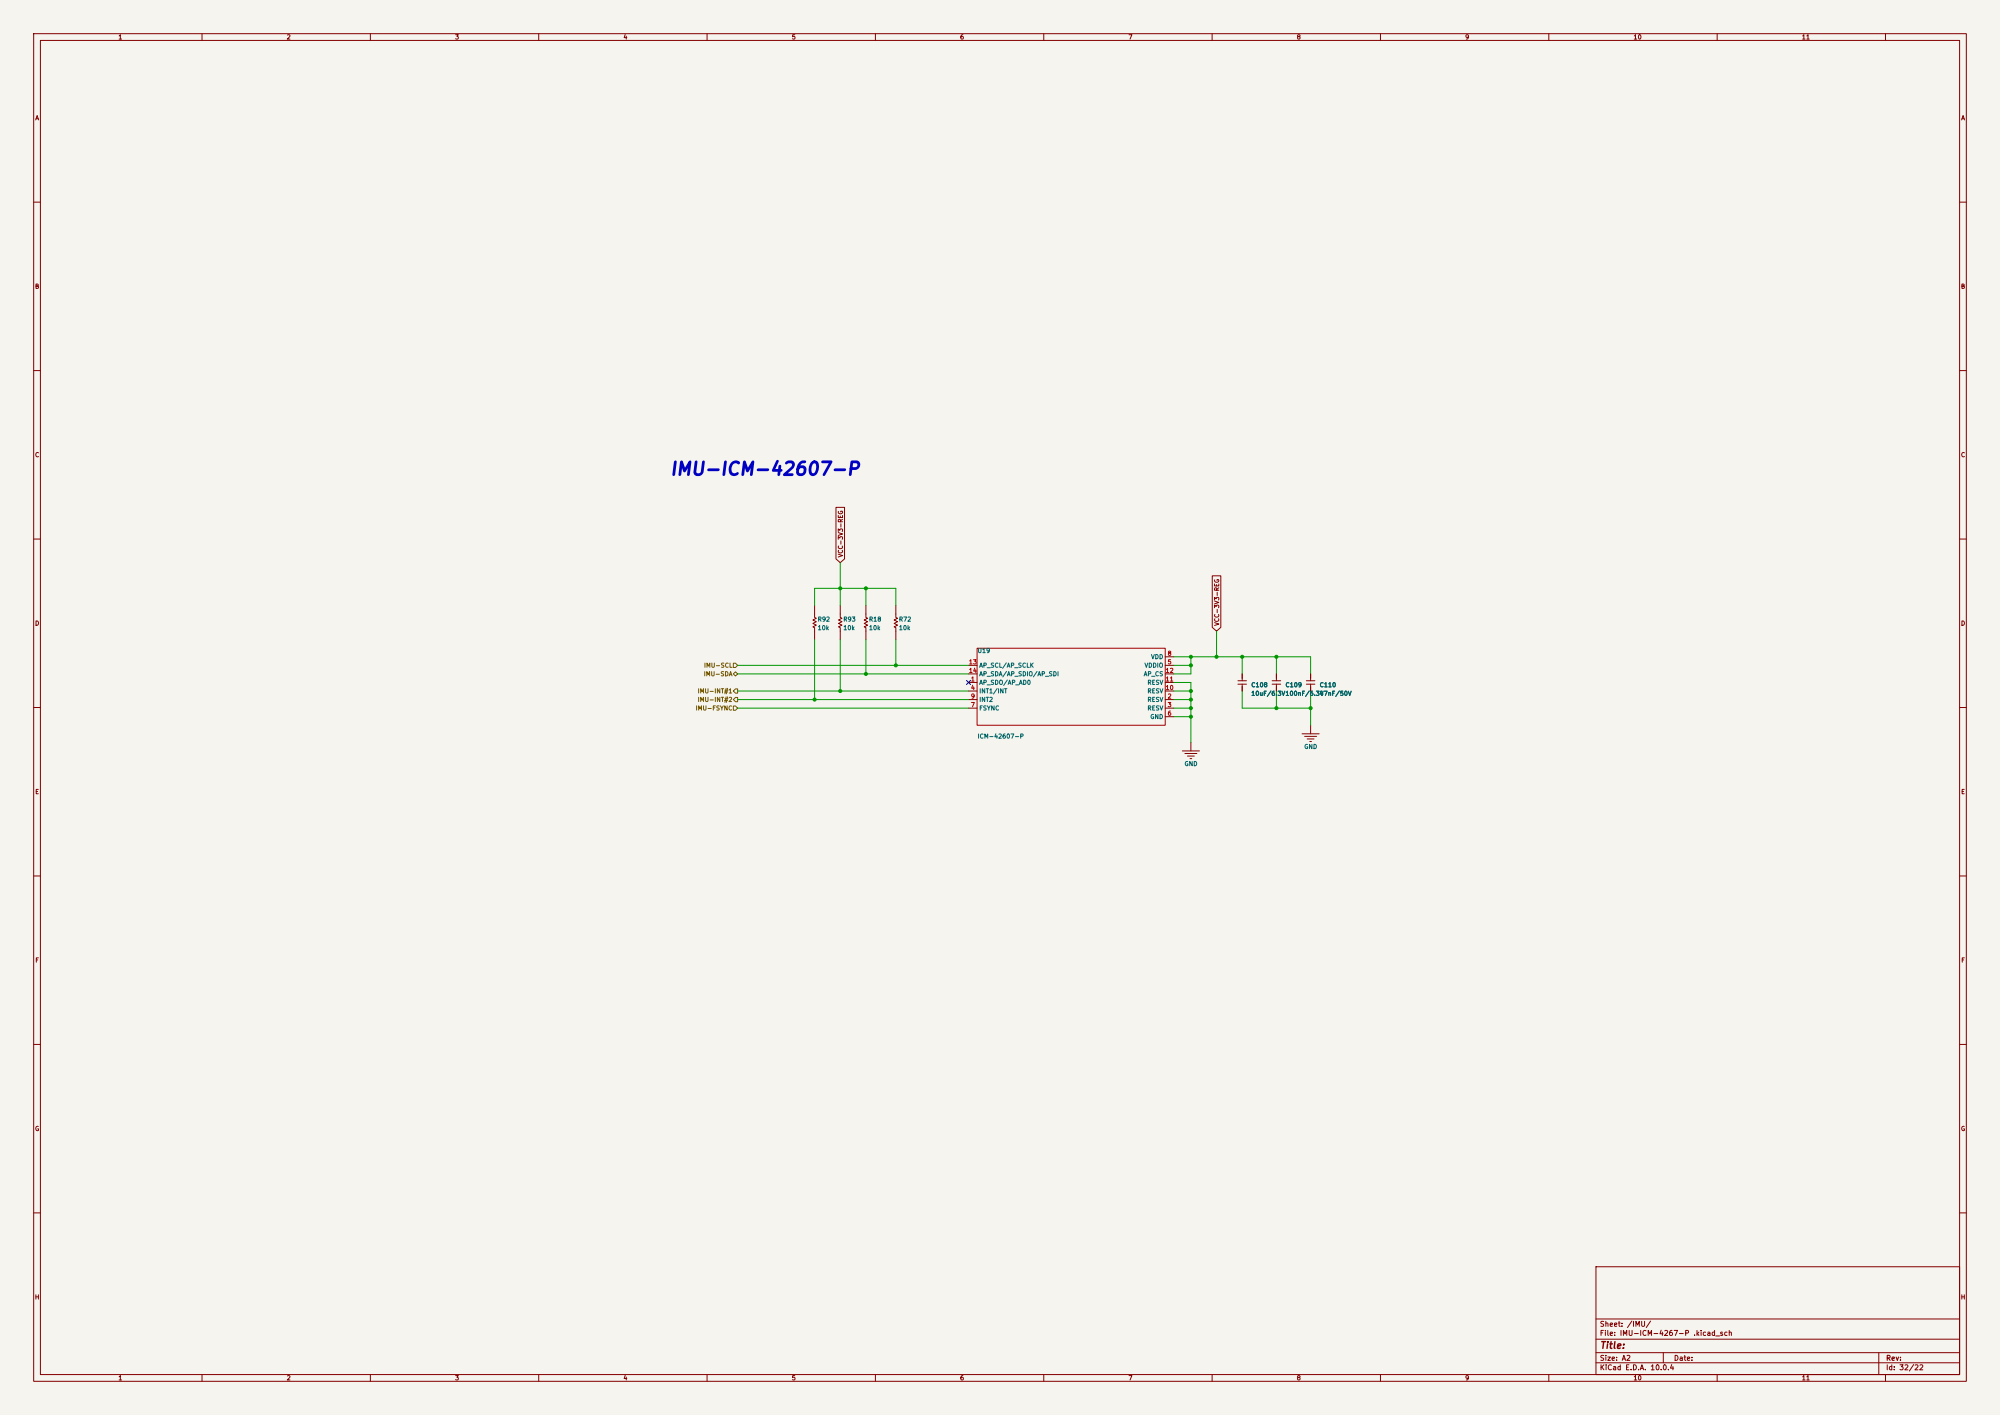
[picture p40: page 19]

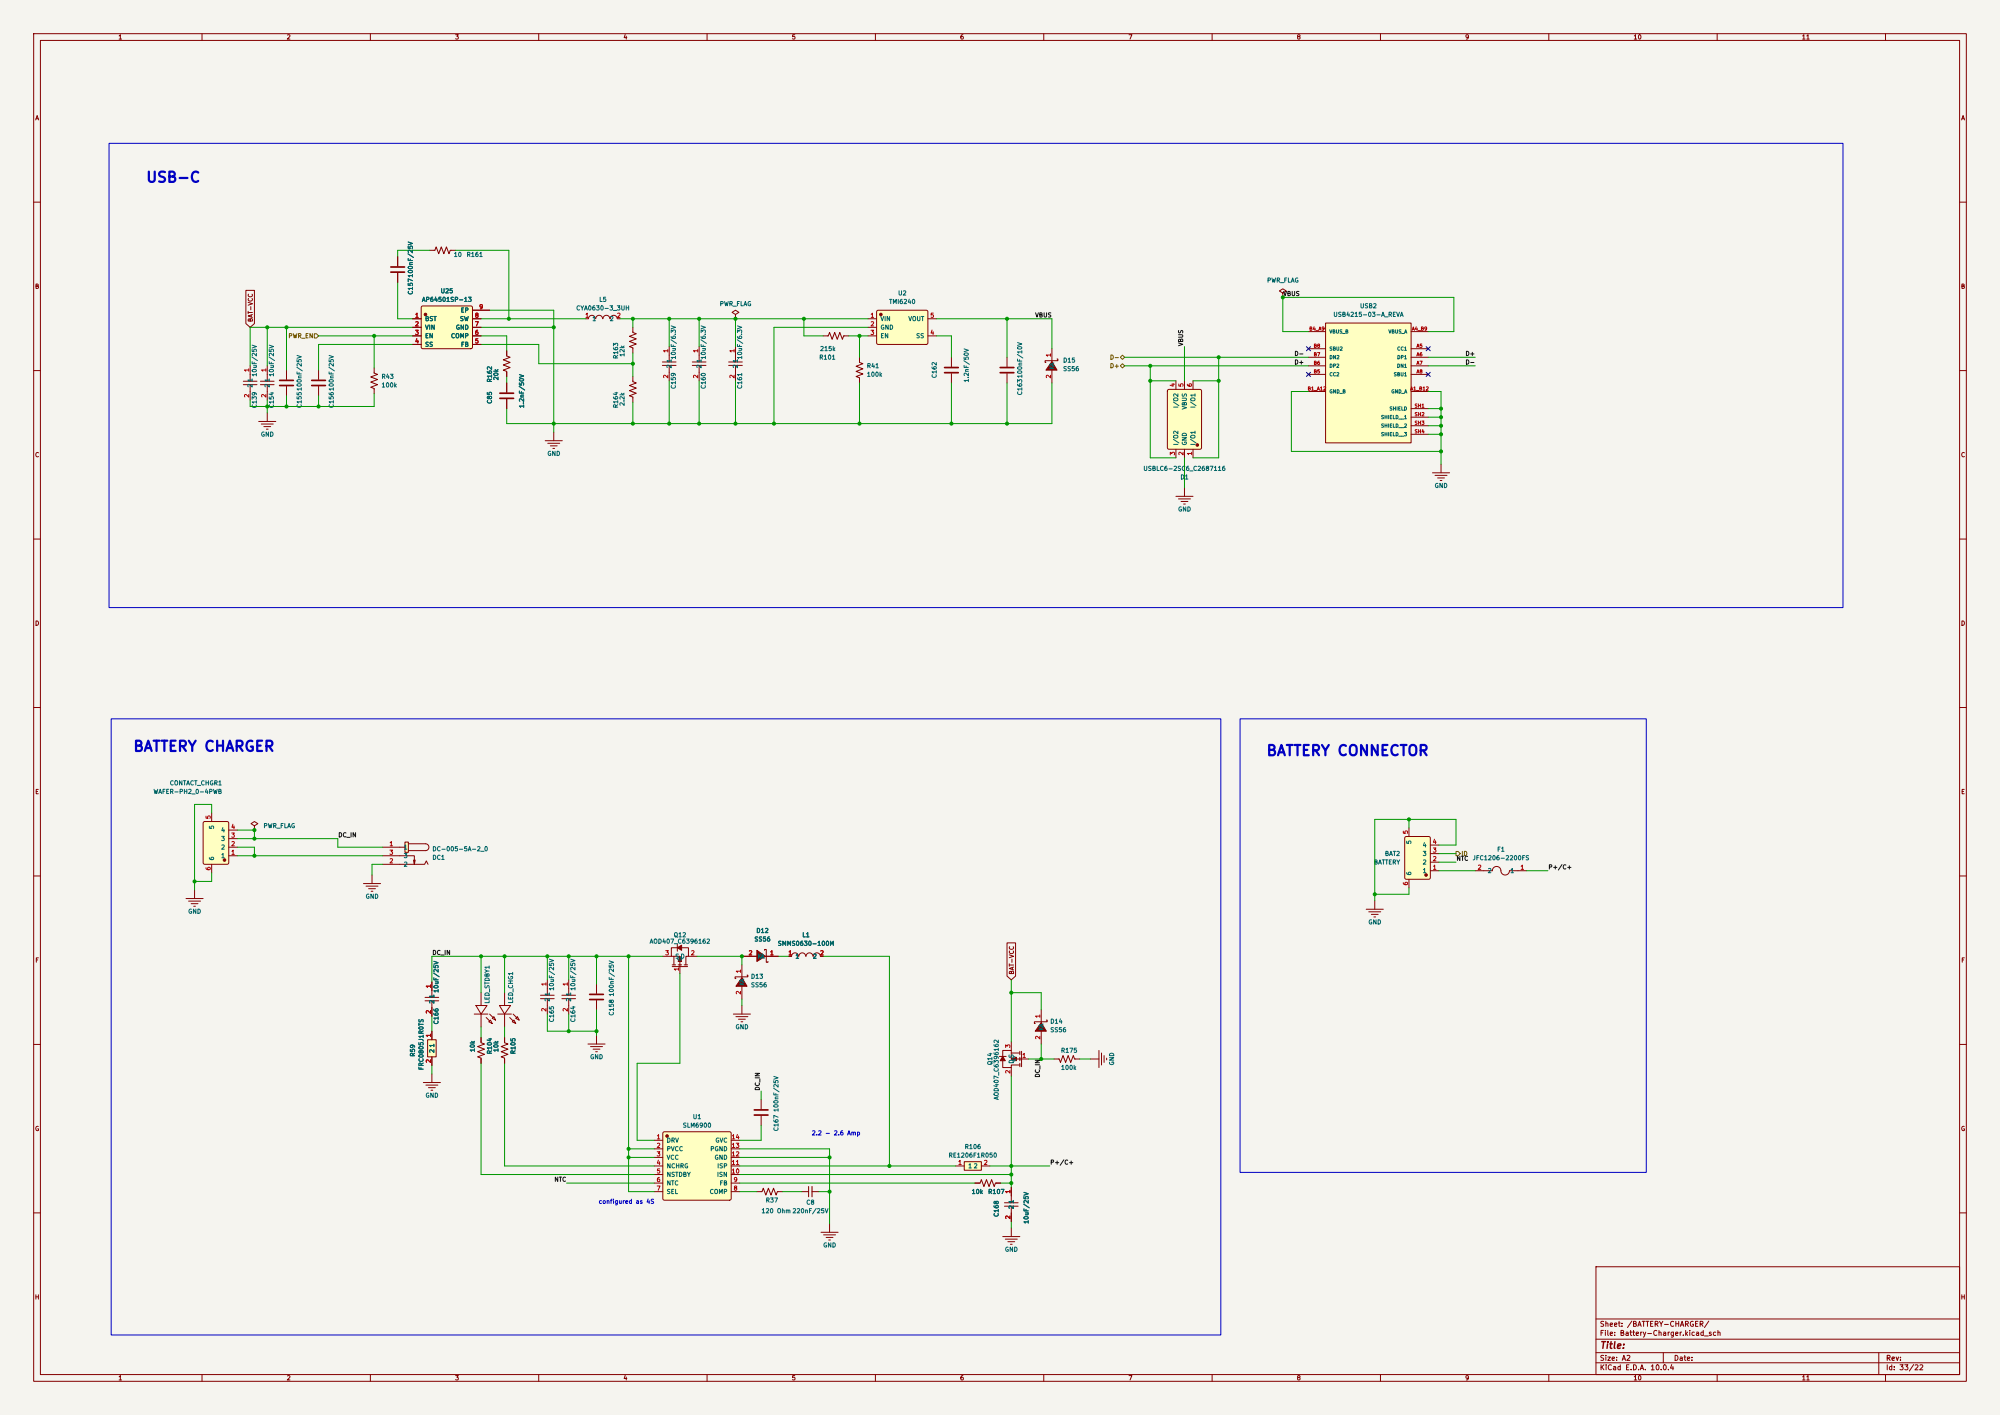
[picture p41: page 20]

ISN 10 ISP 11 GND 12 PGND 13 GVC 14 U1

VCC 3 NCHRG 4 NSTDBY 5 NTC 6

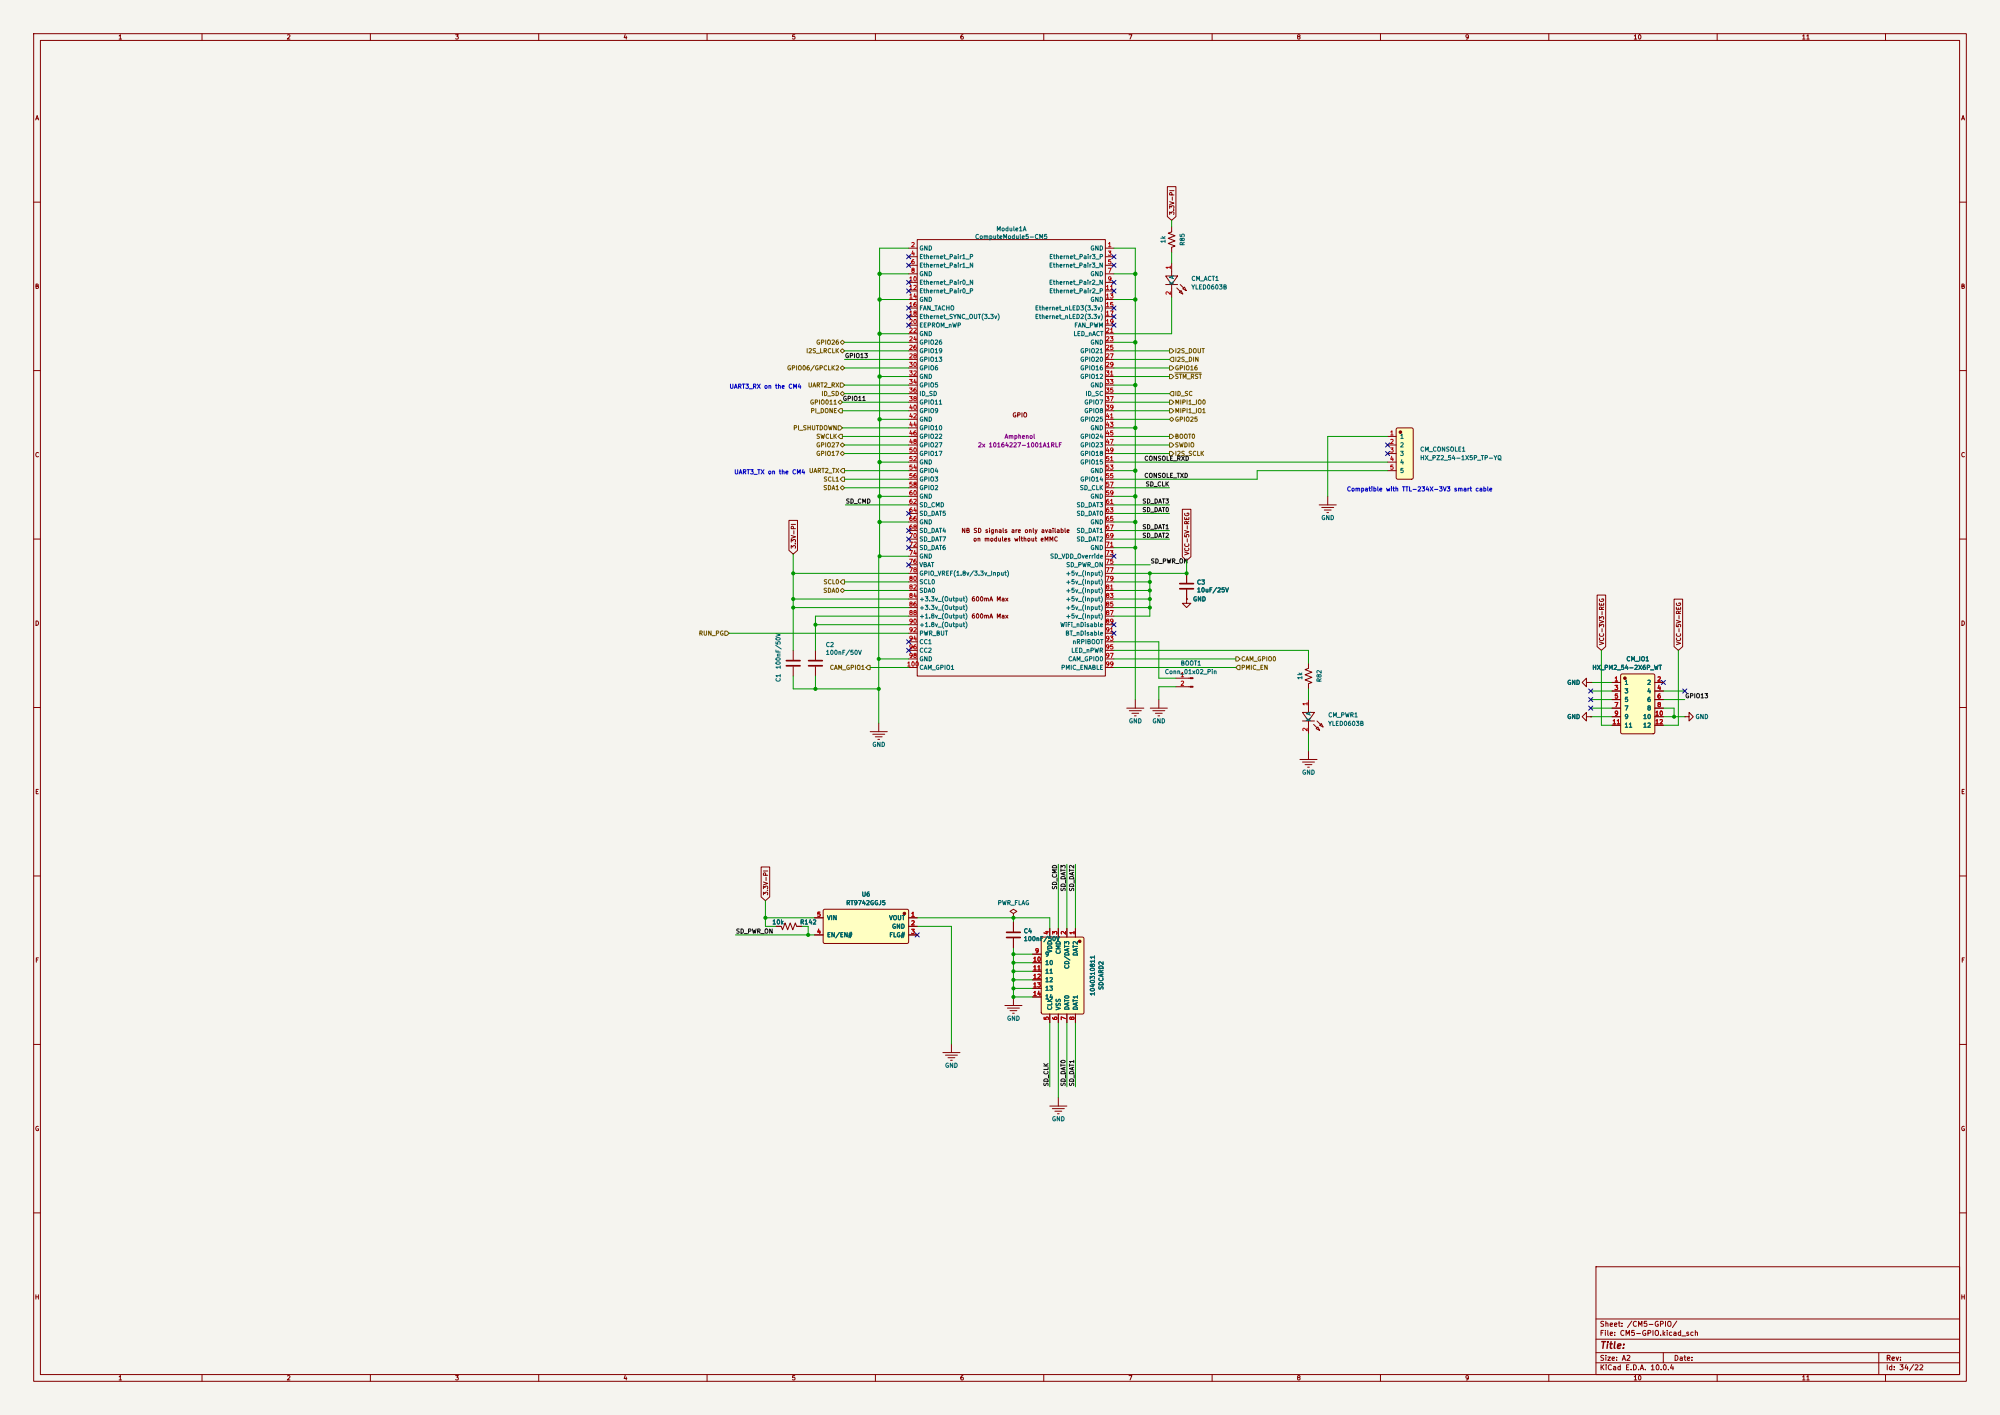
[picture p42: page 21]

600mA Max NB SD signals are only available on modules without eMMC

GND DAT2 1 CD/DAT3 2 CMD 3 VDD 4 CLK 5 VSS 6 DAT0 7 DAT1 8 9 9

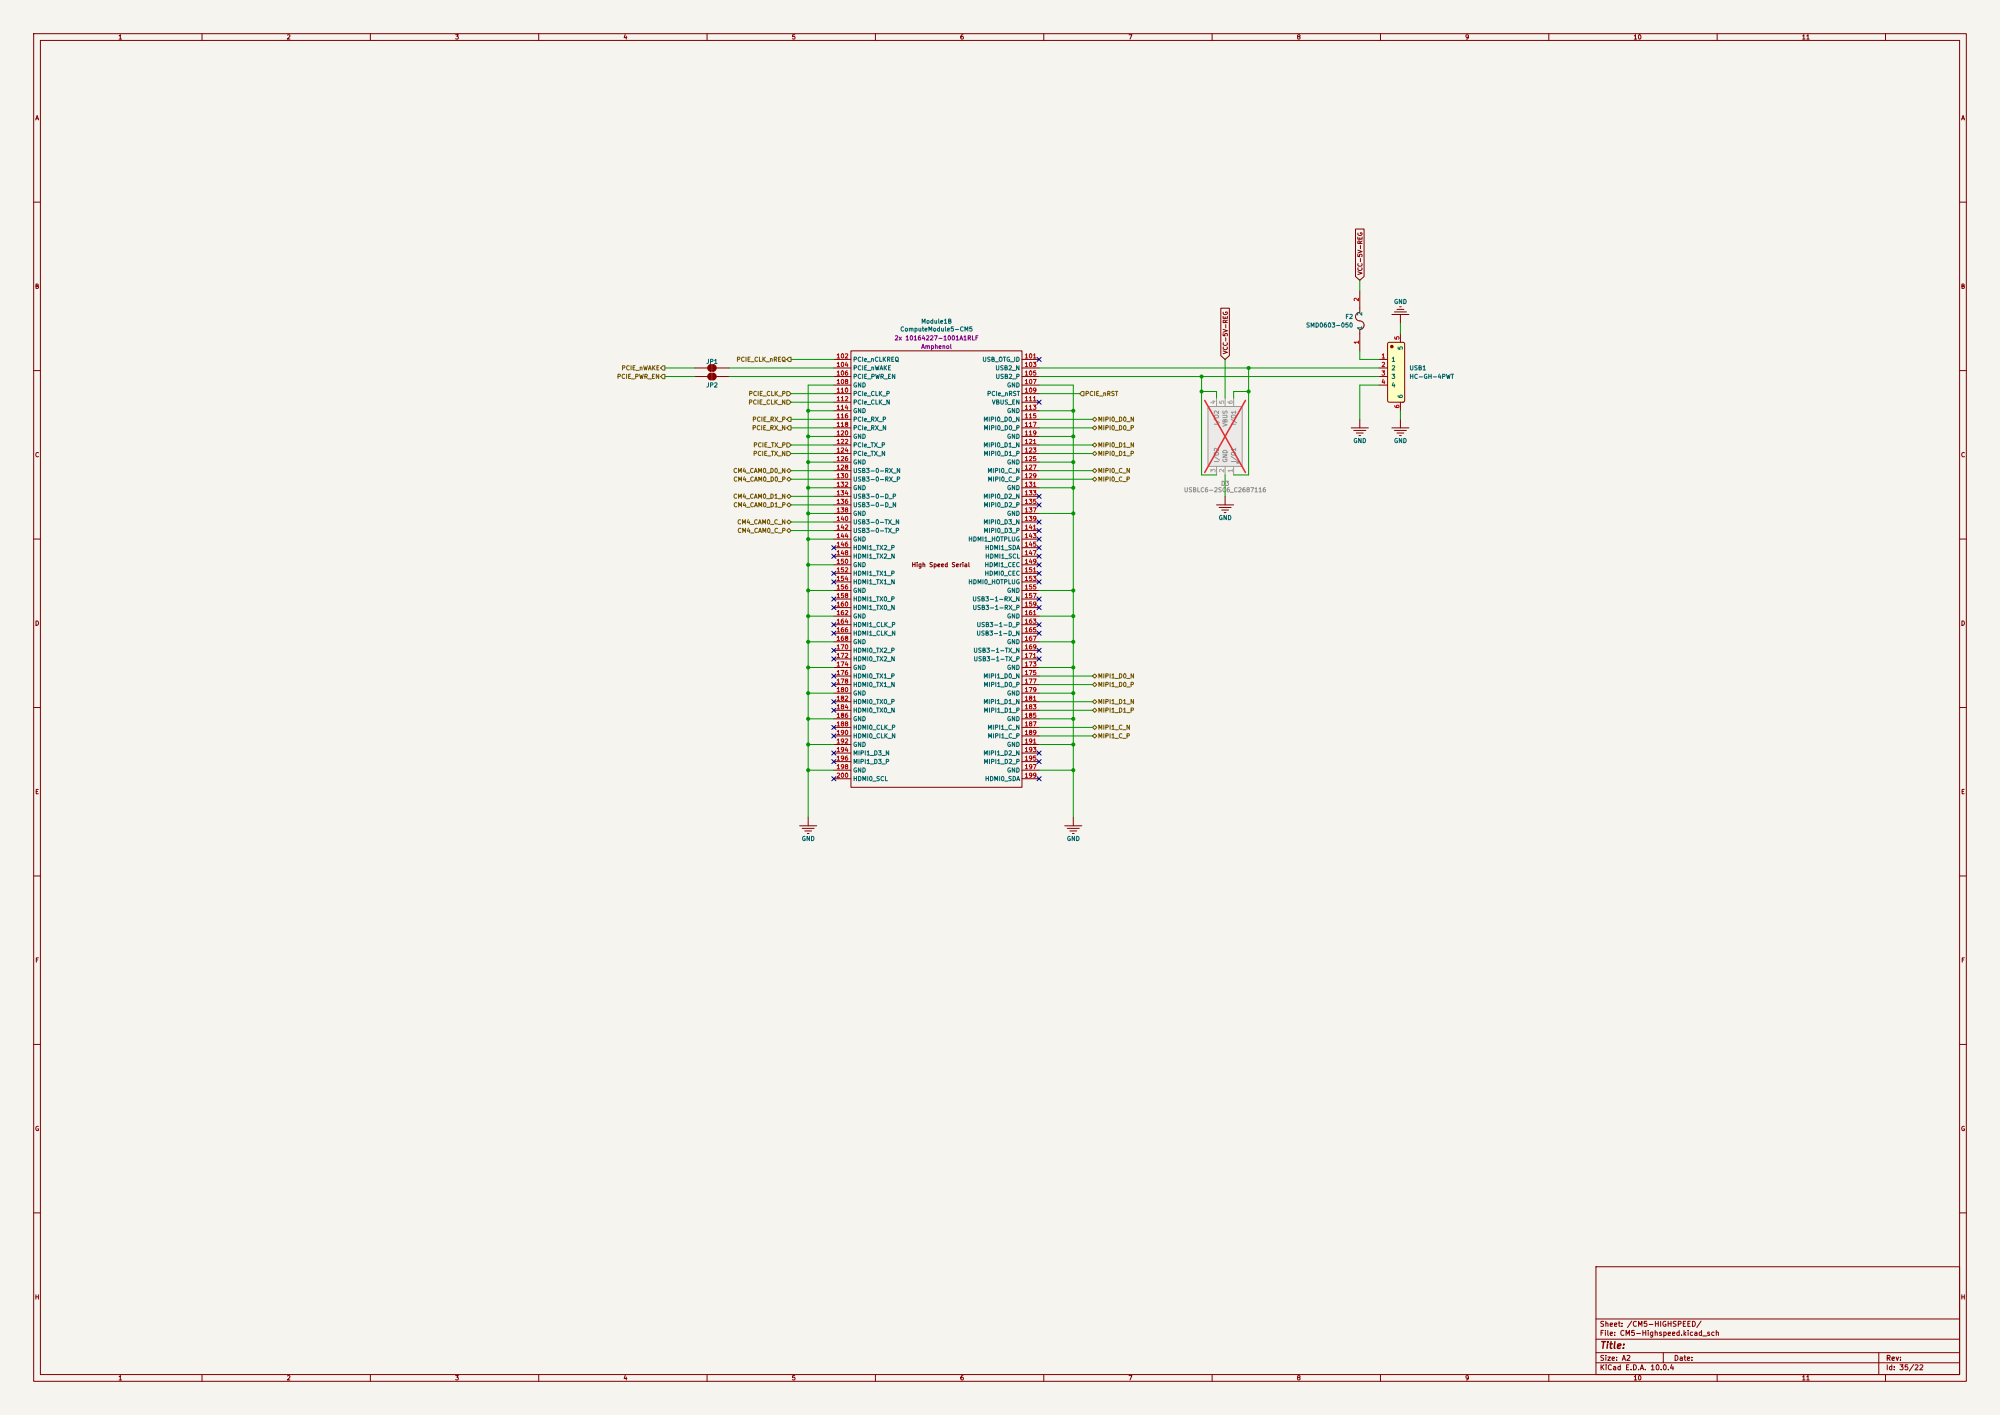
[picture p43: page 22]
