Grammid/oomwoo-pcb/kicad/rear-ir/output/Rear IR.pdf

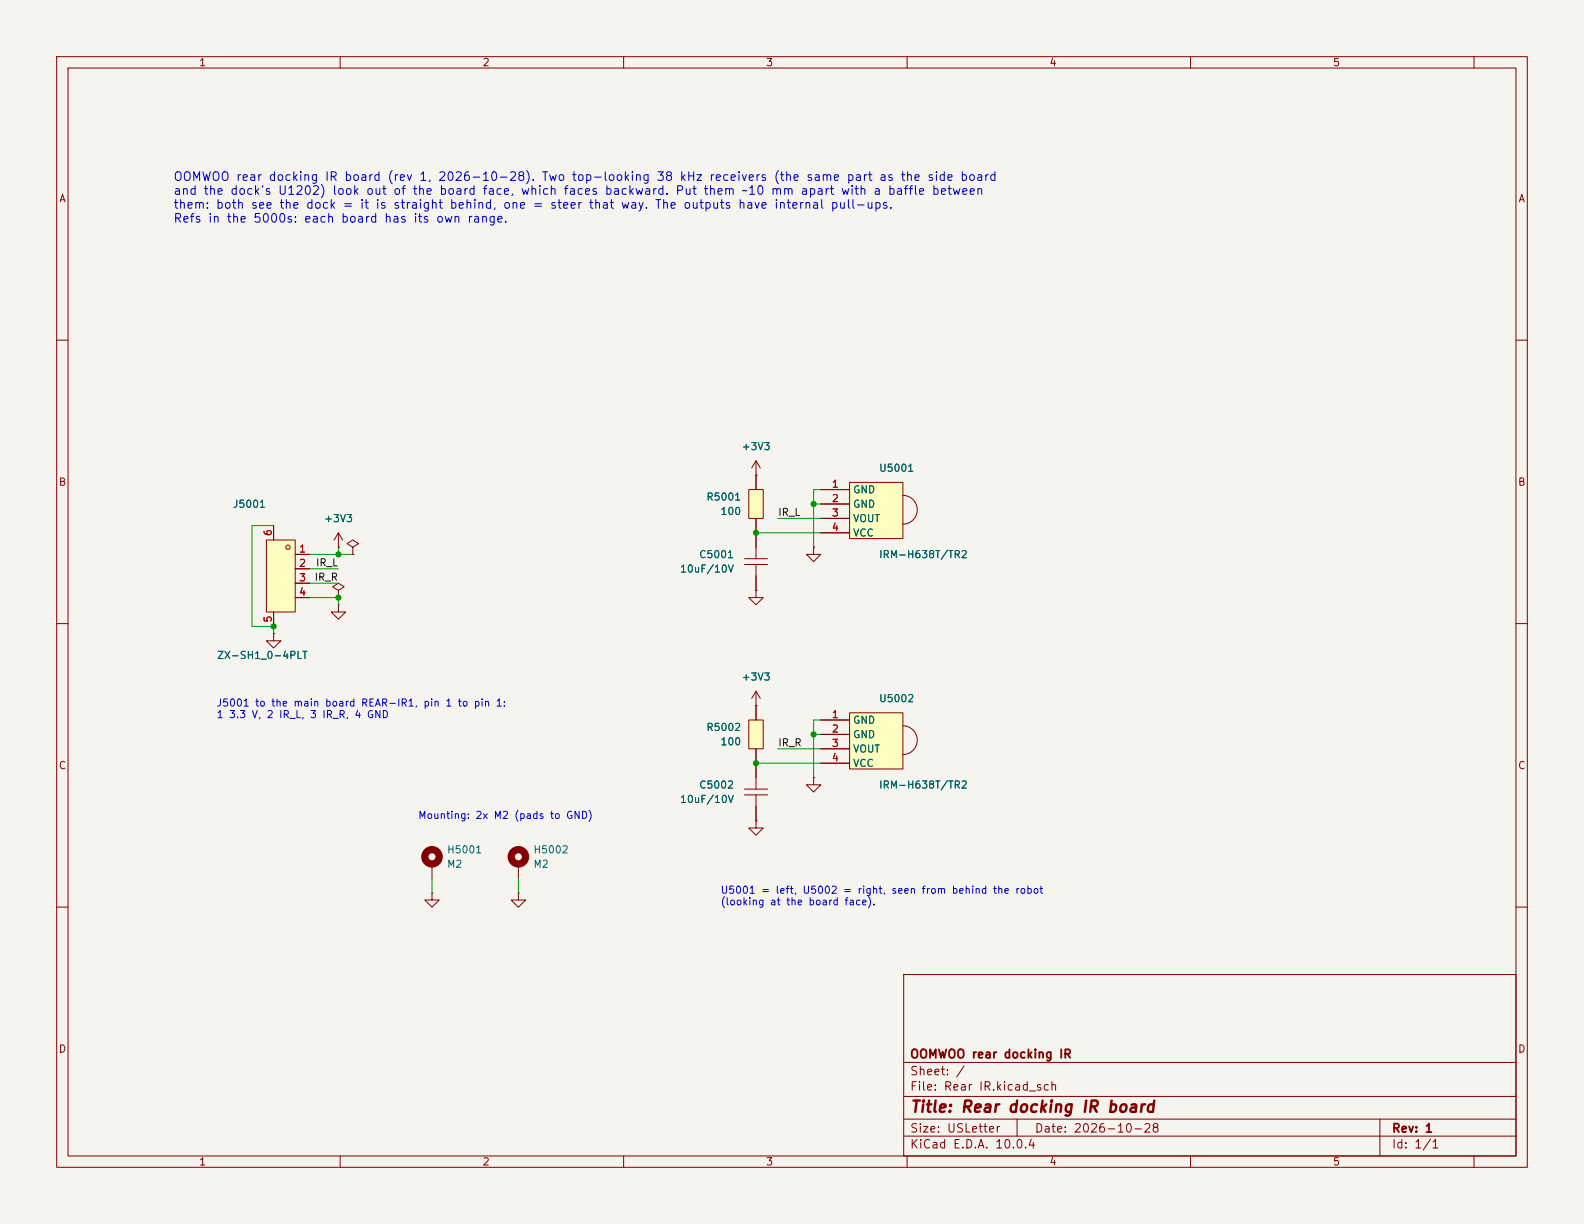
[picture p44: page 1]

OOMWOO rear docking IR board (rev 1, 2026-10-28). Two top-looking 38 kHz receivers (the same part as the side board
and the dock's U1202) look out of the board face, which faces backward. Put them ~10 mm apart with a baffle between
them: both see the dock = it is straight behind, one = steer that way. The outputs have internal pull-ups.

IR_L U5001 = left, U5002 = right, seen from behind the robot (looking at the board face).

Mounting: 2x M2 (pads to GND)

OOMWOO rear docking IR
Sheet: /
File: Rear IR.kicad_sch
Title: Rear docking IR board

Size: USLetter | Rev: 1
KiCad E.D.A. 10.0.4 | Id: 1/1
