Grammid/oomwoo-pcb/kicad/side-sensors/output/Side Sensor.pdf

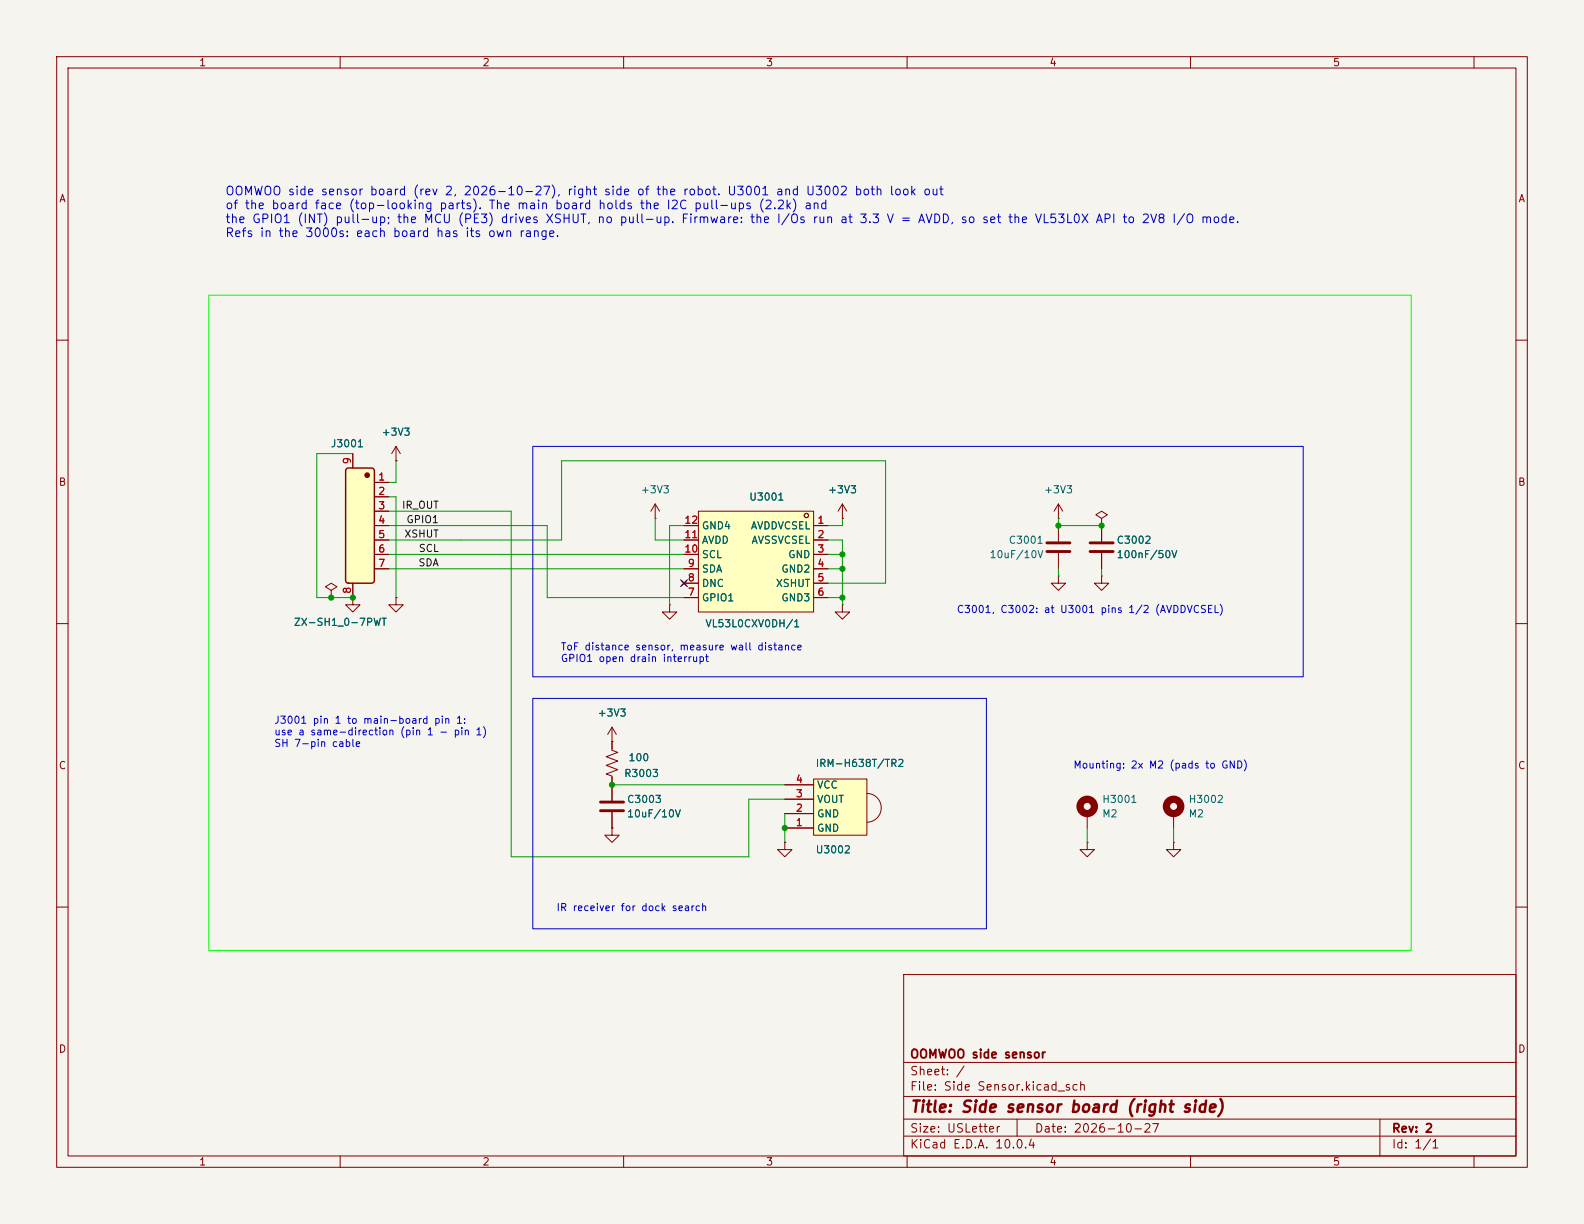
[picture p45: page 1]

IR_OUT OOMWOO side sensor board (rev 2, 2026-10-27), right side of the robot. U3001 and U3002 both look out
of the board face (top-looking parts). The main board holds the I2C pull-ups (2.2k) and
the GPIO1 (INT) pull-up; the MCU (PE3) drives XSHUT, no pull-up. Firmware: the I/Os run at 3.3 V = AVDD, so set the VL53L0X API to 2V8 I/O mode.
Refs in the 3000s: each board has its own range.

J3001 pin 1 to main-board pin 1: use a same-direction (pin 1 - pin 1) SH 7-pin cable

Mounting: 2x M2 (pads to GND)

IR receiver for dock search

OOMWOO side sensor
Sheet: /
File: Side Sensor.kicad_sch
Title: Side sensor board (right side)

Size: USLetter | Rev: 2
KiCad E.D.A. 10.0.4 | Id: 1/1
