Grammid/oomwoo-pcb/kicad/front-sensors/Front Sensor.kicad_pcb

## KiCad design kicad/front-sensors/Front Sensor.kicad_pcb (2026-11-11)

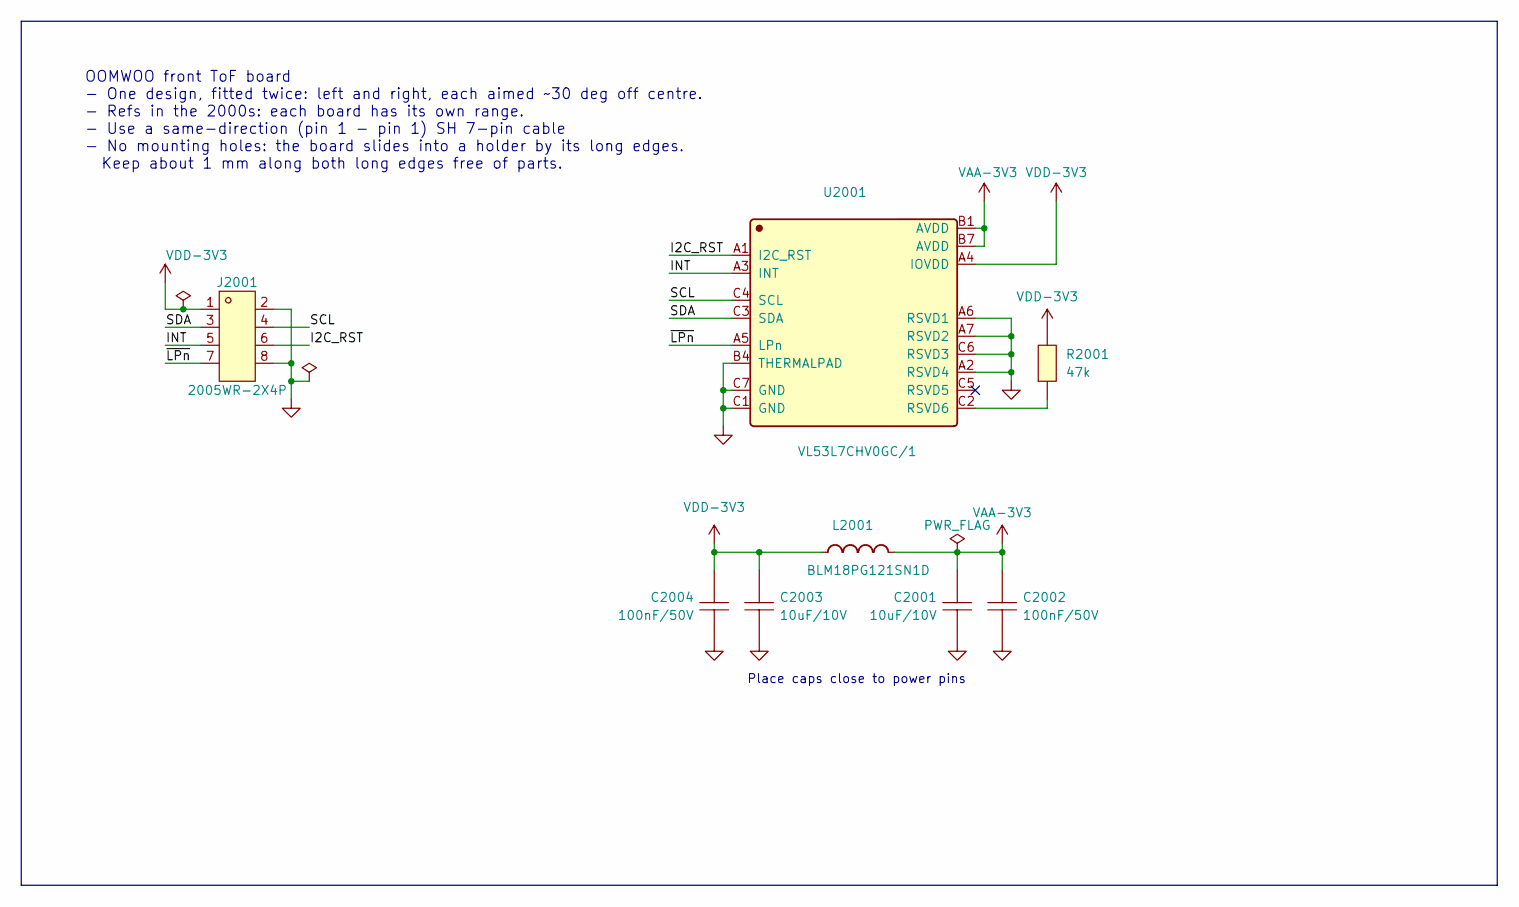
[picture p46: schematic Front Sensor.kicad_sch, Front ToF sensor board (fit 2x)]

Parts:
C2001, C2003: 10uF/10V; C0603; MPN CL10A106KP8NNNC; LCSC C19702
C2002, C2004: 100nF/50V; C0603; MPN CL10B104KB8NNNC; LCSC C1591
J2001: 2005WR-2X4P; HDR-TH_8P-P2.00-H-F-R2-C2-S2.00-W8.8; MPN 2005WR-2x4P; LCSC C6837622
L2001: BLM18PG121SN1D; Manufacturer Part BLM18PG121SN1D; LCSC C14709
R2001: 47k; R0603; MPN FRC0603F4702TS; LCSC C2907042
U2001: VL53L7CHV0GC/1; VL53L7CHV0GC_1; LCSC C19183986

Connections:
/I2C_RST: J2001.6, U2001.A1 (I2C_RST)
/INT: J2001.5, U2001.A3 (INT)
/SCL: J2001.4, U2001.C4 (SCL)
/SDA: J2001.3, U2001.C3 (SDA)
/~LPn: J2001.7, U2001.A5 (LPn)
GND: C2001.2, C2002.2, C2003.2, C2004.2, J2001.2, J2001.8, U2001.A2 (RSVD4), U2001.A6 (RSVD1), U2001.A7 (RSVD2), U2001.B4 (THERMALPAD), U2001.C1 (GND), U2001.C6 (RSVD3), U2001.C7 (GND)
unnamed: R2001.1, U2001.C2 (RSVD6)
VAA-3V3: C2001.1, C2002.1, L2001.2, U2001.B1 (AVDD), U2001.B7 (AVDD)
VDD-3V3: C2003.1, C2004.1, J2001.1, L2001.1, R2001.2, U2001.A4 (IOVDD)

Notes on the sheet:
Place caps close to power pins
OOMWOO front ToF board - One design, fitted twice: left and right, each aimed ~30 deg off centre. - Refs in the 2000s: each board has its own range. - Use a same-direction (pin 1 - pin 1) SH 7-pin cable - No mounting holes: the board slides into a holder by its long edges. Keep about 1 mm along bot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

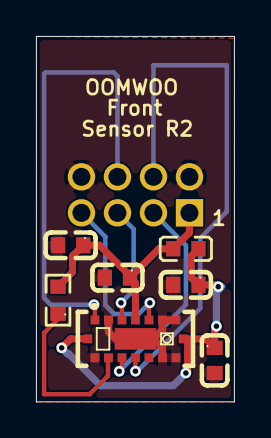
[picture p47: board Front Sensor.kicad_pcb from above]

Board: 2 copper layers, 11.0 x 20.3 mm, 8 parts (1 on the bottom side), 9 nets.
