Grammid/oomwoo-pcb/(commit log)

2026-11-09 Update Front Sensor.kicad_pro
2026-11-10 Front ToF: Board setup and first placement
    [Front Sensor.kicad_pcb]
2026-11-10 Update HDR-TH_8P-P2.00-H-F-R2-C2-S2.00-W8.8.kicad_mod
    2005WR-2x4P footprint: 3D model offset Y 7.2 mm (model origin wasn’t at the hole grid; pins sat outside the holes and the body pointed the wrong way)
2026-11-10 Front Sensor: Placement
    [Front Sensor.kicad_pcb]
2026-11-10 Front ToF sensor: Routing completed
    Routing completed.
    [Front Sensor.kicad_pcb]
2026-11-11 Front ToF: re-layout to the new mock-up
    DRC clean. Re-layout done after board mockup availability.
    [Front Sensor.kicad_pcb]
2026-11-11 Sensor courtyard added
    VL53L7CHV0GC_1 footprint: add courtyard (body + 0.25 mm)
    [Front Sensor.kicad_pcb]
